Kerol-Dev/Tercio-B1/data/bom-estimate.csv

refs | description | lcsc | library | stock | qty | unit@10 | board@10 | unit@100 | board@100
U1 | MCU STM32G431CBT6 (LQFP-48) | C529355 | Extended | 5241 | 1 | 4.3763 | 4.376 | 4.049 | 4.049
U2 | Gate driver DRV8353RSRGZR (buck + 3 CSA + SPI) | C506246 | Extended | 1675 | 1 | 5.2347 | 5.235 | 4.6092 | 4.609
U3 | Encoder MT6835GT-STD-R (21-bit, SPI) | C2932578 | Extended | 1462 | 1 | 4.2884 | 4.288 | 3.5408 | 3.541
U4 | CAN-FD transceiver MCP2562FDT-E/SN | C511335 | Extended | 5333 | 1 | 1.4398 | 1.44 | 1.1238 | 1.124
U5 | LDO 3.3 V TLV75533PDBVR | C404027 | Extended | 132914 | 1 | 0.1424 | 0.142 | 0.1132 | 0.113
Q1-Q6 | MOSFET BSC030N08NS5 80 V 3 mOhm 5x6 | C501507 | Extended | 24529 | 6 | 0.7688 | 4.613 | 0.5685 | 3.411
R1-R3 | Shunt 1 mOhm 2512 3 W RLP25FEGR001 | C459678 | Extended | 27351 | 3 | 0.0888 | 0.266 | 0.0715 | 0.214
C1-C10 | Bulk MLCC 4.7 uF 100 V X7R 1210 | C381466 | Extended | 160984 | 10 | 0.1856 | 1.856 | 0.1856 | 1.856
C11 | Bulk electrolytic 47 uF 80 V 10x10 (height check) | C249920 | Extended | 7438 | 1 | 0.2238 | 0.224 | 0.1799 | 0.18
D1 | TVS SMBJ54A | C2891330 | Extended | 6025 | 1 | 0.0429 | 0.043 | 0.0429 | 0.043
Y1 | Crystal 16 MHz 3225 (Basic, same as S1/FD) | C13738 | Basic | 152708 | 1 | 0.093 | 0.093 | 0.074 | 0.074
RT1 | NTC 10k 0603 (FET temperature) | C13564 | Extended | 178011 | 1 | 0.0465 | 0.046 | 0.0391 | 0.039
D2 | CAN ESD PESD2CAN | C2687131 | Extended | 658668 | 1 | 0.0362 | 0.036 | 0.0362 | 0.036
D3,D4 | Aux ESD TPD4E05U06DQAR | C138714 | Extended | 102774 | 2 | 0.0839 | 0.168 | 0.0665 | 0.133
J1 | XT30PW-M power (right angle) | C431092 | Extended | 72882 | 1 | 0.3339 | 0.334 | 0.2623 | 0.262
J2,J3 | JST-GH 4-pin SM04B-GHS-TB (CAN in/out) | C189895 | Extended | 28981 | 2 | 0.304 | 0.608 | 0.2675 | 0.535
J4 | JST-GH 8-pin BM08B-GHS-TBT (aux) | C133062 | Extended | 1233 | 1 | 0.3737 | 0.374 | 0.3015 | 0.301
LED1,LED2 | LED 0603 (Basic) | C2286 | Basic | 7143368 | 2 | 0.0076 | 0.015 | 0.0076 | 0.015
- | Driver buck passives: inductor, 100 V Schottky, caps, FB divider |  | Basic (est) | est | 1 | 0.3 | 0.3 | 0.22 | 0.22
- | Driver support caps (100 V CP caps, VGLS/DVDD/VCP, VM HF bypass) |  | Basic (est) | est | 1 | 0.1 | 0.1 | 0.07 | 0.07
- | Logic passives: ~50x 0402 R/C, CAN split termination, dividers, filters |  | Basic (est) | est | 1 | 0.18 | 0.18 | 0.12 | 0.12
- | Leg HF decoupling 100 nF 100 V 0603 x6 |  | Basic (est) | est | 1 | 0.05 | 0.05 | 0.03 | 0.03
