Kerol-Dev/Tercio-B1/data/parts-live-2026-10-12-candidates-extra.csv

group | query | mpn | brand | lcsc | package | library | jlc_stock | jlc_p1 | jlc_p10 | jlc_p100 | lcsc_stock | lcsc_p10 | lcsc_p100 | describe | status
Connector | BM08B-GHS-TBT | BM08B-GHS-TBT-LF-SN | JLCPCB Assembly | C9900006063 | CONN-SMD_BM08B-GHS-TBT-LF-SN | Extended | 0 | 0.0007 | 0.0007 | 0.0007 |  |  |  | CONN-SMD_BM08B-GHS-TBT-LF-SN SMT ROHS | ok
Connector | BM08B-GHS-TBT | BM08B-GHS-TBT(LF)(SN) | JST | C133062 | SMD,P=1.25mm | Extended | 1233 | 0.3737 | 0.3737 | 0.3015 | 1235 | 0.3767 | 0.3039 | -25℃~+85℃ 1 1.25mm 13.25mm 1A 1x8P 4.05mm 4.32mm 50V 8 8P Auxiliary Solder Pin GH PA9T Phosphor bronze Surface Mount,Vertical Tin UL94V-0 White SMD,P=1.25mm Wir | ok
Connector | BM08B-GHS-TBT | BM08B-GHS-TBT(LF)(SN) | JST | C265379 | CONN-SMD-8P-P1.25 | Extended | 0 | 0.544 | 0.4056 | 0.3551 |  |  |  | 插件 Wire To Board Connector ROHS | ok
Connector | BM08B-GHS-TBT | BM08B-GHS-TBT(LF)(SN)(N) | JST | C2983884 | SMD,P=1.25mm | Extended | 0 | 0.0396 | 0.0396 | 0.0204 |  |  |  | -25℃~+85℃ 1 1.25mm 13.25mm 1A 1x8P 4.05mm 4.32mm 50V 8 8P Auxiliary Solder Pin GH PA9T Phosphor bronze Surface Mount,Vertical Tin UL94V-0 White SMD,P=1.25mm Wir | ok
Connector | SM07B-GHS-TB | SM07B-GHS-TB(LF)(SN) | JST | C495552 | SMD,P=1.25mm,Surface Mount，Right Angle | Extended | 6167 | 0.3766 | 0.3766 | 0.3172 | 4760 | 0.3798 | 0.3199 | -25℃~+85℃ 1 1.25mm 12mm 1A 1x7P 4.13mm 4.25mm 50V 7 7P Auxiliary Solder Pin GH PA9T Phosphor bronze Surface Mount, Right Angle Tin UL94V-0 White SMD,P=1.25mm,卧贴 | ok
Connector | BM06B-GHS-TBT | BM06B-GHS-TBT | JST | C20089153 | SMD,P=1.25mm | Extended | 0 | 0.1421 | 0.1421 | 0.139 | 0 | 0.1422 | 0.1391 | -25℃~+85℃ 1 1.25mm 10.75mm 1A 1x6P 4.05mm 4.32mm 50V 6 6P Auxiliary Solder Pin GH PA9T Phosphor bronze Surface Mount,Vertical Tin UL94V-0 White SMD,P=1.25mm Wir | ok
Connector | BM06B-GHS-TBT | BM06B-GHS-TBT(LF)(SN) | JST | C189892 | SMD,P=1.25mm | Extended | 1 | 0.3012 | 0.3012 | 0.2347 | 0 | 0.3034 | 0.2365 | -25℃~+85℃ 1 1.25mm 10.75mm 1A 1x6P 4.05mm 4.32mm 50V 6 6P Auxiliary Solder Pin GH PA9T Phosphor bronze Surface Mount,Vertical Tin UL94V-0 White SMD,P=1.25mm Wir | ok
Connector | BM06B-GHS-TBT | BM06B-GHS-TBT(LF)(SN) | JST | C495534 | SMD,P=1.25mm | Extended | 0 | 0.3168 | 0.3168 | 0.254 |  |  |  | -25℃~+85℃ 1 1.25mm 10.75mm 1A 1x6P 4.05mm 4.32mm 50V 6 6P Auxiliary Solder Pin GH PA9T Phosphor bronze Surface Mount,Vertical Tin UL94V-0 White SMD,P=1.25mm Wir | ok
Connector | BM06B-GHS-TBT | BM06B-GHS-TBT(LF)(SN)(N) | JST | C485353 | SMD,P=1.25mm | Extended | 0 | 0.1748 | 0.1748 | 0.171 | 0 | 0.1716 | 0.1679 | -25℃~+85℃ 1 1.25mm 10.75mm 1A 1x6P 4.05mm 4.32mm 50V 6 6P Auxiliary Solder Pin GH PA9T Phosphor bronze Surface Mount,Vertical Tin UL94V-0 White SMD,P=1.25mm Wir | ok
Connector | BM06B-GHS-TBT | BM06B-GHS-TBT(LF)(SN)(N) | JST | C2845126 | SMD,P=1.25mm | Extended | 0 | 0.1147 | 0.1147 | 0.1147 |  |  |  | -25℃~+85℃ 1 1.25mm 10.75mm 1A 1x6P 4.05mm 4.95mm 50V 6 6P Beige PA9T Phosphor bronze Surface Mount,Vertical Tin UL94V-0 SMD,P=1.25mm Wire To Board Connector ROH | ok
Connector | BM06B-GHS-TBT | BM06B-GHS-TBT(LF)(SN)(N) | JST | C2879703 | SMD,P=1.25mm | Extended | 0 | 0.1147 | 0.1147 | 0.1147 |  |  |  | -25℃~+85℃ 1 1.25mm 10.75mm 1A 1x6P 4.05mm 4.95mm 50V 6 6P Beige PA9T Phosphor bronze Surface Mount,Vertical Tin UL94V-0 SMD,P=1.25mm Wire To Board Connector ROH | ok
Connector | BM06B-GHS-TBT | BM06B-GHS-TBT(LF)(SN)(N) | JLCPCB Assembly | C9900141395 | SMD,P=1.25mm,6P | Extended | 0 | 0.0396 | 0.0396 | 0.0204 |  |  |  | SMD,P=1.25mm,6P New Arrivals ROHS | ok
Connector | 1.25mm 8P GH | SH-SM08B-GHS-TB(LF)(SN) | SHOU HAN | C42376901 | SMD,P=1.25mm,Surface Mount，Right Angle | Extended | 30603 | 0.0839 | 0.0839 | 0.0663 | 27170 | 0.0848 | 0.067 | -25℃~+85℃ 1 1.25mm 125V 1A 1x8P 8 8P Beige GH LCP Phosphor bronze Surface Mount, Right Angle Tin UL94V-0 SMD,P=1.25mm,Surface Mount，Right Angle Wire To Board Co | ok
Connector | 1.25mm 8P GH | A1251WR-S-8P-LCP | CJT(Changjiang Connectors) | C225117 | SMD,P=1.25mm,Surface Mount，Right Angle | Extended | 17177 | 0.1471 | 0.1471 | 0.1173 | 17175 | 0.1485 | 0.1184 | -40℃~+105℃ 1 1.25mm 125V 1A 1x8P 8 8P LCP Phosphor Bronze Surface Mount, Right Angle Tin UL94V-0 SMD,P=1.25mm,卧贴 Wire To Board Connector ROHS | ok
Connector | 1.25mm 8P GH | A1251WV-S-8P | CJT(Changjiang Connectors) | C225110 | SMD,P=1.25mm | Extended | 11154 | 0.1662 | 0.1662 | 0.1295 | 11150 | 0.1676 | 0.1306 | -40℃~+105℃ 1 1.25mm 125V 1A 1x8P 8 8P LCP Phosphor Bronze Surface Mount,Vertical Tin UL94V-0 SMD,P=1.25mm Wire To Board Connector ROHS | ok
Connector | 1.25mm 8P GH | A1257WV-S-8P | CJT(Changjiang Connectors) | C225124 | SMD,P=1.25mm | Extended | 10616 | 0.1846 | 0.1846 | 0.1424 | 10020 | 0.1856 | 0.1433 | -40℃~+105℃ 1 1.25mm 1A 1x8P 50V 8 8P GH PA9T Phosphor Bronze Surface Mount,Vertical Tin UL94V-0 SMD,P=1.25mm Wire To Board Connector ROHS | ok
Dev board | B-G431B-ESC1 | B-G431B-ESC1 |  |  |  |  |  |  |  |  |  |  |  |  | not found on JLCPCB/LCSC
Bulk elec | 47uF 80V SMD | HBV470M1KTR-1010 | Lelon | C3031594 | SMD,D10xL10mm | Extended | 9901 | 0.8111 | 0.6629 | 0.5147 | 9901 | 0.6689 | 0.5193 | -55℃~+105℃ 10000hrs@105℃ 10mm 10mm 47uF 80V Polarized SMD ±20% SMD,D10xL10mm Hybrid Aluminum Electrolytic Capacitors ROHS | ok
Bulk elec | 47uF 80V SMD | HV1K476M1010PZ | Honor Elec | C5246571 | SMD,D10xL10mm | Extended | 9385 | 0.3686 | 0.3686 | 0.2991 | 9105 | 0.3724 | 0.3022 | -55℃~+105℃ 10mm 10mm 2000hrs 4.5mm 47uF 80V Polarized ±20% SMD,D10xL10mm Polymer Aluminum Capacitors ROHS | ok
Bulk elec | 47uF 80V SMD | VZH470M1KTR-1010 | Lelon | C249920 | SMD,D10xL10mm | Extended | 7438 | 0.2238 | 0.2238 | 0.1799 | 7095 | 0.2252 | 0.181 | -45℃~+105℃ 10mm 10mm 47uF 5000hrs@105℃ 80V ±20% SMD,D10xL10mm Aluminum Electrolytic Capacitors - SMD ROHS | ok
Bulk elec | 100uF 80V SMD | JVJ80V100M10x10 | jieerrui | C46550424 | SMD,D10xL10.5mm | Extended | 35809 | 0.1662 | 0.1662 | 0.1305 | 34170 | 0.1677 | 0.1317 | -55℃~+105℃ 10.5mm 100uF 10mm 135mA@120Hz 2000hrs@105℃ 80V ±20% SMD,D10xL10.5mm Aluminum Electrolytic Capacitors - SMD ROHS | ok
Bulk elec | 100uF 80V SMD | RVT100UF80V167RV0112 | KNSCHA | C5246576 | SMD,D10xL10.5mm | Extended | 12198 | 0.1602 | 0.1602 | 0.1303 | 12195 | 0.1611 | 0.1312 | -55℃~+105℃ 10.5mm 100uF 10mm 2000hrs@105℃ 280mA@120Hz 80V ±20% SMD,D10xL10.5mm Aluminum Electrolytic Capacitors - SMD ROHS | ok
Bulk elec | 100uF 80V SMD | MA80V100M10X12 | jieerrui | C53120969 | SMD,D10xL12.5mm | Extended | 6506 | 0.4773 | 0.3746 | 0.2769 | 6506 | 0.3782 | 0.2795 | -55℃~+105℃ 100uF 10mm 12.5mm 2.9A@100kHz 2000hrs@105℃ 35mΩ@100kHz 5mm 80V Polarized Polymer ±20% SMD,D10xL12.5mm Polymer Aluminum Capacitors ROHS | ok
Bulk elec | 33uF 100V SMD | RVT2A330M1010 | Honor Elec | C45162 | SMD | Extended | 11265 | 0.136 | 0.136 | 0.1101 | 10795 | 0.1373 | 0.1112 | -55℃~+105℃ 10.2mm 100V 10mm 2000hrs@105℃ 33uF ±20% SMD Aluminum Electrolytic Capacitors - SMD ROHS | ok
Bulk elec | 33uF 100V SMD | JVJ100V33M10X10 | jieerrui | C49256861 | SMD,D10xL10.5mm | Extended | 5760 | 0.1888 | 0.1888 | 0.1499 | 5760 | 0.1899 | 0.1507 | -55℃~+105℃ 10.5mm 100V 10mm 133mA@120Hz 2000hrs@105℃ 33uF ±20% SMD,D10xL10.5mm Aluminum Electrolytic Capacitors - SMD ROHS | ok
Bulk elec | 33uF 100V SMD | FZ2A330M1010 | JARSON | C5260775 | SMD,D10xL10.5mm | Extended | 819 | 0.1237 | 0.1237 | 0.0981 | 790 | 0.1248 | 0.0991 | -55℃~+105℃ 10.5mm 100V 10mm 200mA 33uF 5000hrs@105℃ 700mΩ ±20% SMD,D10xL10.5mm Aluminum Electrolytic Capacitors - SMD ROHS | ok
ESD | TPD4E05U06DQAR | TPD4E05U06DQAR | Texas Instruments | C138714 | USON-10(1x2.5) | Extended | 102774 | 0.0839 | 0.0839 | 0.0665 | 102770 | 0.0848 | 0.0671 | -40℃~+125℃ 0.5pF 10nA 14V 2.5A@8/20us 40W@8/20us 5.5V 6.5V ESD Four channels IEC 61000-4-2、IEC 61000-4-5、IEC 61000-4-4 Unidirectional USON-10(1x2.5) ESD and Sur | ok
ESD | TPD4E05U06DQAR | TPD4E05U06DQAR-N | BORN | C920310 | DFN-10(2.5x1.0) | Extended | 23300 | 0.0706 | 0.0706 | 0.0564 | 23300 | 0.0713 | 0.057 | 0.25pF、0.3pF 10V 3.5A@8/20us 500nA 5V 60W@8/20us 7.8V IEC 61000-4-2、IEC 61000-4-5、IEC 61000-4-4 Unidirectional DFN-10(2.5x1.0) ESD and Surge Protection (TVS/ESD | ok
ESD | TPD4E05U06DQAR | TPD4E05U06DQAR | TECH PUBLIC | C2827646 | USON-10(1x2.5) | Extended | 35262 | 0.0717 | 0.0717 | 0.0569 | 35260 | 0.0725 | 0.0575 | -55℃~+125℃ 0.3pF、0.6pF 13V 5.5V 50nA 5A 7.5V 70W@8/20us ESD Four channels IEC 61000-4-2、IEC 61000-4-5、IEC 61000-4-4 Unidirectional USON-10(1x2.5) ESD and Surge | ok
ESD | TPD4E05U06DQAR | TPD4E05U06DQAR-MS | MSKSEMI | C2836386 | DFN2510-10 | Extended | 7749 | 0.072 | 0.072 | 0.0579 | 7740 | 0.0727 | 0.0584 | 0.3pF、0.8pF 150W 15V 1uA 3.3V 5A 6V ESD Four channels IEC 61000-4-2、IEC 61000-4-5、IEC 61000-4-4 DFN2510-10 ESD and Surge Protection (TVS/ESD) ROHS | ok
ESD | TPD4E05U06DQAR | TPD4E05U06DQAR | Leiditech | C2972498 | DFN2510-10 | Extended | 5653 | 0.0838 | 0.0838 | 0.0681 | 5650 | 0.0846 | 0.0688 | 0.3pF、0.8pF 100nA 5A@8/20us 5V 6V 75W@8/20us 9.8V、15V ESD Four channels IEC 61000-4-2、IEC 61000-4-5 DFN2510-10 ESD and Surge Protection (TVS/ESD) ROHS | ok
ESD | TPD4E05U06DQAR | TPD4E05U06DQAR-ES | ElecSuper | C5199181 | DFN2510-10L | Extended | 1951 | 0.0279 | 0.0279 | 0.0229 | 1950 | 0.0282 | 0.023 | -40℃~+125℃ 0.6pF 12V 1uA 4.5A 5V 60W 6V ESD Four channels IEC 61000-4-2、IEC 61000-4-5、IEC 61000-4-4 Unidirectional DFN2510-10L ESD and Surge Protection (TVS/ESD | ok
ESD | TPD4E05U06DQAR | TPD4E05U06DQAR | HXY MOSFET | C5337182 | DFN2510-10L | Extended | 286 | 0.0807 | 0.0807 | 0.0642 | 285 | 0.0814 | 0.0648 | -40℃~+125℃ 0.8pF 150W 15V 1uA 3.3V 5A 6V ESD Four channels IEC 61000-4-2 Unidirectional DFN2510-10L ESD and Surge Protection (TVS/ESD) ROHS | ok
ESD | TPD4E05U06DQAR | TPD4E05U06DQAR | GOODWORK | C21713973 | USON-10(1x2.5) | Extended | 1193 | 0.0393 | 0.0393 | 0.0393 | 1180 | 0.0397 | 0.0397 | -55℃~+125℃ 0.6pF 15V 1uA 4.5A@8/20us 5V 60W@8/20us 6V ESD Four channels IEC 61000-4-2 Unidirectional USON-10(1x2.5) ESD and Surge Protection (TVS/ESD) ROHS | ok
ESD | TPD4E05U06DQAR | TPD4E05U06DQAR | DOWO | C22390021 | DFN2510-10L | Extended | 97226 | 0.0287 | 0.0287 | 0.0287 | 96460 | 0.0289 | 0.0289 | 0.2pF 15V 1uA 5V 60W@8/20us 9V Four channels IEC 61000-4-2、IEC 61000-4-5 TVS Unidirectional DFN2510-10L ESD and Surge Protection (TVS/ESD) ROHS | ok
ESD | TPD4E05U06DQAR | TPD4E05U06DQAR | YTL | C53433026 | DFN2510-10L | Extended | 2941 | 0.044 | 0.044 | 0.0346 | 2940 | 0.0441 | 0.0347 | DFN2510-10L ESD and Surge Protection (TVS/ESD) ROHS | ok
ESD | TPD4E05U06DQAR | TPD4E05U06DQAR | Texas Instruments | C125795 | USON-10 | Extended | 0 | 0.6124 | 0.5978 | 0.5782 |  |  |  | USON-10 ESD Protection Devices ROHS | ok
ESD | TPD4E05U06DQAR | TPD4E05U06DQAR | JLCPCB Assembly | C9900010487 | USON-10 | Extended | 0 | 0.0007 | 0.0007 | 0.0007 |  |  |  | USON-10 SMT ROHS | ok
ESD | TPD4E05U06DQAR | TPD4E05U06DQAR | JLCPCB Assembly | C9900145545 | DSON-10_L2.5-W1.0-P0.50-BL | Extended | 0 | 0.0396 | 0.0396 | 0.0204 |  |  |  | DSON-10_L2.5-W1.0-P0.50-BL New Arrivals ROHS | ok
ESD | TPD4E05U06DQAR | TPD4E05U06DQAR-L | TECH PUBLIC | C19829470 | DFN2510-10 | Extended | 2525 | 0.0481 | 0.0481 | 0.0378 | 2520 | 0.0446 | 0.035 | -55℃~+125℃ 0.3pF、0.8pF 100nA 16V 4A@8/20us 5V 80W@8/20us 8V Four channels IEC 61000-4-2、IEC 61000-4-5、IEC 61000-4-4 TVS Unidirectional DFN2510-10 ESD and Surge | ok
ESD | SRV05-4 | SRV05-4.TCT | SEMTECH | C13612 | SOT-23-6L | Extended | 43056 | 0.1624 | 0.1624 | 0.1294 | 43055 | 0.164 | 0.1305 | -55℃~+125℃ 12A@8/20us 17.5V 300W@8/20us 3pF 5V 5uA 6V Four channels IEC 61000-4-2、IEC 61000-4-5、IEC 61000-4-4 TVS Unidirectional SOT-23-6L ESD and Surge Protect | ok
ESD | SRV05-4 | SRV05-4-P-T7 | ProTek Devices | C85364 | SOT-23-6 | Extended (preferred) | 2 | 0.308 | 0.308 | 0.2522 | 0 | 0.3076 | 0.2519 | 12V 1A@8/20us 3.5pF 500W@8/20us 5V 5uA 6V ESD Four channels IEC 61000-4-2、IEC 61000-4-5、IEC 61000-4-4 SOT-23-6 ESD and Surge Protection (TVS/ESD) ROHS | ok
ESD | SRV05-4 | SRV05-4L-TP | MCC(Micro Commercial Components) | C107351 | SOT-23-6L | Extended | 1339 | 0.1684 | 0.1684 | 0.1333 | 1335 | 0.2247 | 0.1959 | -55℃~+150℃ 1.5pF 12A@8/20us 17.5V 1uA 350W@8/20us 5V 9V ESD Four channels IEC 61000-4-2、IEC 61000-4-4 SOT-23-6L ESD and Surge Protection (TVS/ESD) ROHS | ok
ESD | SRV05-4 | SRV05-4HTG | Littelfuse | C151305 | SOT-23-6 | Extended | 29731 | 0.9431 | 0.8274 | 0.6808 | 29731 | 0.8326 | 0.6851 | 10A@8/20us 150W 15V 3pF 500nA 6V IEC 61000-4-2、IEC 61000-4-5、IEC 61000-4-4 TVS SOT-23-6 ESD and Surge Protection (TVS/ESD) ROHS | ok
ESD | SRV05-4 | SRV05-4A | SMC(Sangdest Microelectronicstronic (Nanjing)) | C260410 | SOT-23-6L | Extended | 2786 | 0.14 | 0.14 | 0.1101 | 2785 | 0.1411 | 0.1111 | -55℃~+125℃ 1.5pF、3.2pF 17.5V 2.3uA 20A@8/20us 5V 6V Four channels IEC 61000-4-2、IEC 61000-4-5、IEC 61000-4-4 TVS Unidirectional SOT-23-6L ESD and Surge Protectio | ok
ESD | SRV05-4 | SRV05-4ATCT | SEMTECH | C371093 | SOT-23-6 | Extended | 3757 | 0.2284 | 0.2284 | 0.1797 | 3755 | 0.2305 | 0.1814 | -55℃~+125℃ 12A@8/20us 17.5V 300W 3pF 5V 5uA 6V ESD Four channels IEC 61000-4-2、IEC 61000-4-5、IEC 61000-4-4 SOT-23-6 ESD and Surge Protection (TVS/ESD) ROHS | ok
ESD | SRV05-4 | SRV05-4 | Leiditech | C384887 | SOT-26 | Extended | 7099 | 0.065 | 0.065 | 0.0509 | 7090 | 0.0655 | 0.0513 | 0.5pF 12A 15V 1uA 350W@8/20us 5V 6V Four channels IEC 61000-4-2、IEC 61000-4-5、IEC 61000-4-4 TVS SOT-26 ESD and Surge Protection (TVS/ESD) ROHS | ok
ESD | SRV05-4 | SRV05-4 | AnBon | C397788 | SOT-23-6 | Extended | 270 | 0.0514 | 0.0514 | 0.0414 | 0 | 0.0518 | 0.0418 | -55℃~+125℃ 0.35pF、0.9pF 100W@8/20us 15V 4A 5V 5uA 6V ESD Four channels IEC 61000-4-2、IEC 61000-4-5 SOT-23-6 ESD and Surge Protection (TVS/ESD) ROHS | ok
ESD | SRV05-4 | SRV05-4 | TECH PUBLIC | C558418 | SOT-23-6 | Extended | 195535 | 0.0266 | 0.0266 | 0.0266 | 195600 | 0.0268 | 0.0268 | -55℃~+125℃ 0.3pF、0.8pF 20V 3A 500nA 5V 60W 6V ESD Four channels IEC 61000-4-2、IEC 61000-4-5、IEC 61000-4-4 Unidirectional SOT-23-6 ESD and Surge Protection (TVS/ | ok
ESD | SRV05-4 | SRV05-4MR6T1G | onsemi | C604719 | TSOP-6 | Extended | 78 | 4.4154 | 3.9496 | 3.36 | 78 | 3.9742 | 3.3809 | -55℃~+125℃ 1.5pF、3pF 17.5V 300W 5V 5uA 6V ESD Four channels IEC 61000-4-2、IEC 61000-4-5、IEC 61000-4-4 TSOP-6 ESD and Surge Protection (TVS/ESD) ROHS | ok
ESD | SRV05-4 | SRV05-4 | Applied Power | C712153 | SOT-23-6 | Extended | 1 | 0.0989 | 0.0989 | 0.0786 | 0 | 0.0995 | 0.079 | 1.5pF、3pF 12A@8/20us 25V 300W@8/20us 500nA 5V 6V IEC 61000-4-2、IEC 61000-4-5 TVS SOT-23-6 ESD and Surge Protection (TVS/ESD) ROHS | ok
ESD | SRV05-4 | SRV05-4LA 4A | DOWO | C1884586 | SOT-23-6L | Extended | 4148 | 0.0354 | 0.0354 | 0.0354 | 4140 | 0.0356 | 0.0356 | -40℃~+85℃ 0.8pF 15V 1uA 4A@8/20us 5V 60W@8/20us 9.5V Four channels IEC 61000-4-2 TVS Unidirectional SOT-23-6L ESD and Surge Protection (TVS/ESD) ROHS | ok
ESD | SRV05-4 | SRV05-4HTG-D | Littelfuse | C1975211 | SOT-23-6 | Extended | 25620 | 0.1784 | 0.1784 | 0.1417 | 25620 | 0.18 | 0.143 | 10A@8/20us 150W@8/20us 15V 1pF 500nA 6V 8.5V ESD Four channels IEC 61000-4-2、IEC 61000-4-5、IEC 61000-4-4 SOT-23-6 ESD and Surge Protection (TVS/ESD) ROHS | ok
ESD | SRV05-4 | SRV05-4.TCT | UMW(Youtai Semiconductor Co., Ltd.) | C2687126 | SOT-23-6 | Extended | 63022 | 0.0373 | 0.0373 | 0.0373 | 63020 | 0.0373 | 0.0373 | 0.3pF 20V 500nA 5V 6V ESD Four channels IEC 61000-4-2、IEC 61000-4-5、IEC 61000-4-4 SOT-23-6 ESD and Surge Protection (TVS/ESD) ROHS | ok
ESD | SRV05-4 | SRV05-4ATCT | TECH PUBLIC | C2827642 | SOT-23-6 | Extended | 4168 | 0.0417 | 0.0417 | 0.0331 | 4160 | 0.0421 | 0.0334 | -55℃~+125℃ 0.4pF、0.8pF 18V 300W@8/20us 5.5A@8/20us 5V 6V 80nA Four channels IEC 61000-4-2、IEC 61000-4-5、IEC 61000-4-4 SOT-23-6 ESD and Surge Protection (TVS/ESD | ok
ESD | SRV05-4 | SRV05-4 | MSKSEMI | C2836319 | SOT-23-6 | Extended | 401980 | 0.0289 | 0.0289 | 0.0289 | 393440 | 0.0292 | 0.0292 | -40℃~+125℃ 0.6pF 12V 1uA 4.5A@8/20us 5V 60W@8/20us 9V ESD Four channels SOT-23-6 ESD and Surge Protection (TVS/ESD) ROHS | ok
ESD | SRV05-4 | SRV05-4MR6T1G | TECH PUBLIC | C2901302 | SOT-23-6 | Extended | 3161 | 0.079 | 0.079 | 0.0644 | 3160 | 0.0799 | 0.0651 | -55℃~+125℃ 0.3pF、0.8pF 18V 300W@8/20us 4.7A@8/20us 5V 6V 80nA ESD IEC 61000-4-2、IEC 61000-4-5、IEC 61000-4-4 SOT-23-6 ESD and Surge Protection (TVS/ESD) ROHS | ok
ESD | SRV05-4 | SRV05-4.TCT | TECH PUBLIC | C2905630 | SOT-23-6 | Extended | 8975 | 0.0455 | 0.0455 | 0.0365 | 8860 | 0.046 | 0.0369 | -55℃~+125℃ 0.3pF、0.8pF 18V 300W@8/20us 4.7A@8/20us 5V 6V 80nA ESD IEC 61000-4-2、IEC 61000-4-5、IEC 61000-4-4 SOT-23-6 ESD and Surge Protection (TVS/ESD) ROHS | ok
ESD | SRV05-4 | SRV05-4 | DOWO | C2972082 | SOT-23-6L | Extended | 6424 | 0.0362 | 0.0362 | 0.0362 | 6420 | 0.0366 | 0.0366 | 0.3pF、0.6pF 12V 1uA 4.5A@8/20us 5V 60W@8/20us ESD Four channels IEC 61000-4-2 Unidirectional SOT-23-6L ESD and Surge Protection (TVS/ESD) ROHS | ok
ESD | SRV05-4 | SRV05-4 | Shenzhen Jinkaisheng Elec | C2972750 | SOT-23-6L | Extended | 2910 | 0.0509 | 0.0509 | 0.0408 | 2910 | 0.0478 | 0.0382 | 0.4pF、0.8pF 150W@8/20us 15V、28V 1uA 5A@8/20us 5V 6V ESD Four channels IEC 61000-4-2 SOT-23-6L ESD and Surge Protection (TVS/ESD) ROHS | ok
LED | 0603 red LED | KT-0603R | Hubei KENTO Elec | C2286 | 0603 | Basic | 7143368 | 0.0076 | 0.0076 | 0.0076 | 4686900 | 0.0077 | 0.0077 | -40℃~+85℃ 1.6mm x 0.8mm square LED 1.8V~2.4V 120° 20mA 300mcd 40mW 615nm~630nm 645nm Discrete Diode Red Water Clear 0603 LED Indication - Discrete ROHS | ok
LED | 0603 red LED | NCD0805R1 | Foshan NationStar Optoelectronics | C84256 | 0805 | Basic | 4196154 | 0.0134 | 0.0134 | 0.0134 | 3009300 | 0.0135 | 0.0135 | -30℃~+85℃ 1.6V~2.6V 130° 195mcd 25mA 615nm~630nm 630nm 65mW Discrete Diode Red 0805 LED Indication - Discrete ROHS | ok
MOSFET | BSC070N10NS5 | BSC070N10NS5 | Infineon Technologies | C534364 | TDSON-8(5x6) | Extended | 25994 | 0.588 | 0.4984 | 0.3258 | 22631 | 0.5032 | 0.3289 | -55℃~+150℃ 1 N-channel 100V 2.7nF 28pF 3.8V 38nC@10V 7mΩ@10V 80A 83W TDSON-8(5x6) MOSFETs ROHS | ok
MOSFET | BSC070N10NS5 | BSC070N10NS5-HXY | HXY MOSFET | C22366974 | DFN-8(5x6) | Extended | 133 | 0.6206 | 0.5082 | 0.3975 | 133 | 0.5114 | 0.3999 | -55℃~+150℃ 1 N-channel 1.6V 100V 2.046nF 25pF 39.4nC@10V 7.3mΩ@10V 75A 865pF 97W N-Channel Standalone ±20V DFN-8(5x6) MOSFETs ROHS | ok
MOSFET | BSC070N10NS5 | BSC070N10NS5SC | Infineon Technologies | C534365 | SON-8-EP(5x6) | Extended | 0 | 3.5571 | 3.5571 | 3.5571 |  |  |  | SON-8-EP(5x6) MOSFETs ROHS | ok
MOSFET | BSC070N10NS5 | BSC070N10NS5SC | Infineon Technologies | C3279351 | WSON-8-EP(5x6) | Extended | 0 | 2.1206 | 2.075 | 2.0131 | 0 | 2.0727 | 2.0109 | -55℃~+175℃ 1 N-channel 100V 100W 2.7nF 28pF 3.8V 30nC@10V 440pF 7mΩ@10V 82A N-Channel WSON-8-EP(5x6) MOSFETs ROHS | ok
MOSFET | BSC070N10NS5 | BSC070N10NS5 | JLCPCB Assembly | C9900102270 | TDSON-8 | Extended | 0 | 0.0396 | 0.0396 | 0.0204 |  |  |  | TDSON-8 New Arrivals ROHS | ok
MOSFET | BSC070N10NS5 | BSC070N10NS5-MS | MSKSEMI | C51927954 | DFN-8L(5x6) | Extended | 199 | 0.9186 | 0.772 | 0.6238 | 199 | 0.77 | 0.6222 | -55℃~+150℃ 1 N-channel 1.6V 100V 2.046nF 25pF 39.4nC 7.3mΩ@10V 75A 865pF 97W N-Channel ±20V DFN-8L(5x6) MOSFETs ROHS | ok
MOSFET | BSC070N10NS5 | BSC070N10NS5(ES) | ElecSuper | C49108749 | PDFN-8L(5x6) | Extended | 2 | 0.4603 | 0.4603 | 0.3807 | 0 | 0.4647 | 0.3842 | 1 N-channel 1.357nF 1.8nF 100V 125W 29nC@10V 3V 53pF 6.5mΩ@10V 92A N-Channel PDFN-8L(5x6) MOSFETs ROHS | ok
MOSFET | BSC070N10NS5 | BSC070N10NS5ATMA1 | Infineon Technologies | C151549 | PG-TDSON-8 | Extended | 0 | 2.6939 | 2.347 | 1.9072 |  |  |  | 100V 3.8V@50uA 7mΩ@10V,40A 80A 83W N-Channel PG-TDSON-8(6x5) MOSFETs ROHS | ok
MOSFET | BSC070N10NS5 | BSC070N10NS5ATMA1 | JLCPCB Assembly | C9900302558 | PG-TDSON-8 | Extended | 0 | 0.0396 | 0.0396 | 0.0204 |  |  |  | PG-TDSON-8 SMT ROHS | ok
MOSFET | BSC070N10NS5 | BSC070N10NS5SCATMA1 | Infineon Technologies | C55035936 | WSON-8-EP(5x6) | Extended | 0 | 7.6386 | 7.6386 | 7.6386 |  |  |  | WSON-8-EP(5x6) SMT ROHS | ok
MOSFET | BSC093N10NS5 | BSC093N10NS5 |  |  |  |  |  |  |  |  |  |  |  |  | not found on JLCPCB/LCSC
