Kerol-Dev/Tercio-B1/data/parts-live-2026-10-12.csv

group | query | mpn | brand | lcsc | package | library | jlc_stock | jlc_p1 | jlc_p10 | jlc_p100 | lcsc_stock | lcsc_p10 | lcsc_p100 | describe | status
MCU | STM32G431CBT6 | STM32G431CBT6 | STMicroelectronics | C529355 | LQFP-48(7x7) | Extended | 5241 | 5.0213 | 4.3763 | 4.049 | 4197 | 4.4179 | 4.0875 | -40℃~+85℃ 1.71V~3.6V 128KB 12bit 12bit 170MHz 32 Bit 32KB 38 ARM Cortex-M4F Built-in FLASH LQFP-48(7x7) Microcontrollers (MCU/MPU/SOC) ROHS | ok
MCU | STM32G431CBT6 | STM32G431CBT6 | JLCPCB Assembly | C9900183364 | SMD-51P-P0.5 | Extended | 0 | 0.0396 | 0.0396 | 0.0204 |  |  |  | SMD-51P-P0.5 SMT ROHS | ok
MCU | STM32G431CBT6 | STM32G431CBT6TR | STMicroelectronics | C37706925 | LQFP-48(7x7) | Extended | 0 | 10.4139 | 8.9855 | 7.3862 | 0 | 9.0501 | 7.4392 | LQFP-48(7x7) Microcontrollers (MCU/MPU/SOC) ROHS | ok
MCU | STM32G431CBT6 | STM32G431CBT6GQ204 | JLCPCB Assembly | C9900269867 | LQFP-48(7x7) | Extended | 0 | 0.0396 | 0.0396 | 0.0204 |  |  |  | LQFP-48(7x7) SMT ROHS | ok
MCU | STM32G431CBU6 | STM32G431CBU6 | STMicroelectronics | C529356 | UFQFPN-48(7x7) | Extended | 3561 | 7.9252 | 7.0116 | 5.8617 | 2575 | 7.075 | 5.9148 | -40℃~+85℃ 1.71V~3.6V 128KB 12bit 12bit 170MHz 32 Bit 32KB 42 ARM Cortex-M4F Built-in FLASH UFQFPN-48(7x7) Microcontrollers (MCU/MPU/SOC) ROHS | ok
MCU | STM32G431CBU6 | STM32G431CBU6U | STMicroelectronics | C1341712 | UFQFPN-48(7x7) | Extended | 0 | 4.2086 | 4.2086 | 4.2086 | 0 | 3.9884 | 3.9884 | -40℃~+85℃ 1.71V~3.6V 128KB 12bit 12bit 170MHz 32 Bit 32KB 42 ARM Cortex-M4F Built-in FLASH UFQFPN-48(7x7) Microcontrollers (MCU/MPU/SOC) ROHS | ok
MCU | STM32G431RBT6 | STM32G431RBT6 | STMicroelectronics | C431633 | LQFP-64(10x10) | Extended | 3117 | 5.7477 | 5.1272 | 4.2982 | 2980 | 5.1736 | 4.3371 | -40℃~+85℃ 1.71V~3.6V 128KB 12bit 12bit 170MHz 32 Bit 32KB 52 ARM Cortex-M4F Built-in FLASH LQFP-64(10x10) Microcontrollers (MCU/MPU/SOC) ROHS | ok
MCU | STM32G431RBT6 | STM32G431RBT6U | STMicroelectronics | C1341937 | LQFP-64(10x10) | Extended | 0 | 5.5848 | 5.5848 | 5.5848 | 0 | 5.2926 | 5.2926 | -40℃~+85℃ 1.71V~3.6V 128KB 12bit 12bit 170MHz 32 Bit 32KB 52 ARM Cortex-M4F Built-in FLASH LQFP-64(10x10) Microcontrollers (MCU/MPU/SOC) ROHS | ok
MCU | STM32G431RBT6 | STM32G431RBT6TR | STMicroelectronics | C3019121 | LQFP-64(10x10) | Extended | 0 | 19.6844 | 18.743 | 15.6892 | 0 | 17.7505 | 14.8584 | -40℃~+85℃ 1.71V~3.6V 128KB 12bit 12bit 170MHz 32 Bit 32KB 52 ARM Cortex-M4 Built-in FLASH LQFP-64(10x10) Microcontrollers (MCU/MPU/SOC) ROHS | ok
MCU | STM32G474CET6 | STM32G474CET6 | STMicroelectronics | C730125 | LQFP-48(7x7) | Extended | 0 | 21.4694 | 20.4662 | 15.8847 | 0 | 20.653 | 16.0297 | -40℃~+85℃ 1.71V~3.6V 128KB 12bit 12bit 170MHz 32 Bit 38 512KB ARM Cortex-M4F Built-in FLASH LQFP-48(7x7) Microcontrollers (MCU/MPU/SOC) ROHS | ok
MCU | STM32G474CEU6 | STM32G474CEU6 | STMicroelectronics | C1235412 | UFQFPN-48(7x7) | Extended | 6 | 13.7462 | 13.0784 | 10.9123 | 0 | 13.1866 | 11.0025 | -40℃~+85℃ 1.71V~3.6V 128KB 12bit 12bit 170MHz 32 Bit 38 512KB ARM Cortex-M4F Built-in FLASH UFQFPN-48(7x7) Microcontrollers (MCU/MPU/SOC) ROHS | ok
MCU | STM32G474CBT6 | STM32G474CBT6 | STMicroelectronics | C730123 | LQFP-48_7x7 | Extended | 481 | 4.2933 | 3.777 | 3.5131 | 164 | 3.8129 | 3.5465 | -40℃~+85℃ 1.71V~3.6V 128KB 128KB 12bit 12bit 170MHz 32 Bit 38 ARM Cortex-M4F Built-in FLASH LQFP-48(7x7) Microcontrollers (MCU/MPU/SOC) ROHS | ok
MCU | STM32G474CBT6 | STM32G474CBT6 | JLCPCB Assembly | C9900115372 | UFQFPN-48_L7.0-W7.0-P0.50-BL-E | Extended | 0 | 0.0396 | 0.0396 | 0.0204 |  |  |  | UFQFPN-48_L7.0-W7.0-P0.50-BL-E New Arrivals ROHS | ok
MCU | STM32G474CBT6 | STM32G474CBT6TR | STMicroelectronics | C5270356 | LQFP-48(7x7) | Extended | 0 | 3.5995 | 3.1288 | 2.5652 | 0 | 3.1482 | 2.5812 | 1.71V~3.6V 12bit 12bit 170MHz 38 ARM Cortex-M4 LQFP-48(7x7) Microcontrollers (MCU/MPU/SOC) ROHS | ok
MCU | STM32G474RET6 | STM32G474RET6 | STMicroelectronics | C521608 | LQFP-64(10x10) | Extended | 353 | 13.5621 | 11.9302 | 10.1631 | 139 | 12.0168 | 10.2369 | -40℃~+85℃ 1.71V~3.6V 128KB 12bit 12bit 170MHz 32 Bit 512KB 52 ARM Cortex-M4F Built-in FLASH LQFP-64(10x10) Microcontrollers (MCU/MPU/SOC) ROHS | ok
MCU | STM32G474RET6 | STM32G474RET6TR | STMicroelectronics | C55072751 | LQFP-64 | Extended | 0 | 0.0396 | 0.0396 | 0.0204 |  |  |  | LQFP-64 SMT ROHS | ok
MCU | STM32G473CET6 | STM32G473CET6 | STMicroelectronics | C730113 | LQFP-48(7x7) | Extended | 0 | 13.7755 | 13.1501 | 11.1207 | 0 | 13.2584 | 11.2124 | -40℃~+85℃ 1.71V~3.6V 128KB 12bit 12bit 170MHz 32 Bit 38 512KB ARM Cortex-M4 Built-in FLASH LQFP-48(7x7) Microcontrollers (MCU/MPU/SOC) ROHS | ok
MCU | STM32G491CET6 | STM32G491CET6 | STMicroelectronics | C3227300 | LQFP-48(7x7) | Extended | 3 | 9.023 | 8.3992 | 8.1305 | 0 | 8.4683 | 8.1973 | -40℃~+85℃ 1.71V~3.6V 112KB 12bit 12bit 170MHz 32 Bit 38 512KB ARM Cortex-M4F Built-in FLASH LQFP-48(7x7) Microcontrollers (MCU/MPU/SOC) ROHS | ok
MCU | STM32G491CEU6 | STM32G491CEU6 | STMicroelectronics | C3227342 | UFQFPN-48(7x7) | Extended | 2 | 8.6663 | 8.4627 | 8.1924 | 0 | 8.4567 | 8.1865 | -40℃~+85℃ 1.71V~3.6V 12bit 12bit 170MHz 32 Bit 42 512KB ARM Cortex-M4F Built-in FLASH UFQFPN-48(7x7) Microcontrollers (MCU/MPU/SOC) ROHS | ok
MCU | STM32G491CEU6 | STM32G491CEU6TR | STMicroelectronics | C5909866 | UFQFPN-48(7x7) | Extended | 0 | 13.6045 | 13.6045 | 13.6045 | 0 | 13.2584 | 13.2584 | -40℃~+85℃ 1.71V~3.6V 12bit 12bit 170MHz 32 Bit 42 512KB ARM Cortex-M4 Built-in FLASH UFQFPN-48(7x7) Microcontrollers (MCU/MPU/SOC) ROHS | ok
MCU | STM32G491RET6 | STM32G491RET6 | STMicroelectronics | C3231005 | LQFP-64(10x10) | Extended | 0 | 6.8031 | 5.9497 | 4.9936 | 0 | 5.9999 | 5.0358 | -40℃~+85℃ 1.71V~3.6V 112KB 12bit 12bit 170MHz 32 Bit 512KB 52 ARM Cortex-M4F Built-in FLASH LQFP-64(10x10) Microcontrollers (MCU/MPU/SOC) ROHS | ok
MCU | STM32G491RET6 | STM32G491RET6TR | STMicroelectronics | C5270292 | LQFP-64(10x10) | Extended | 0 | 8.5507 | 8.5507 | 8.5507 | 0 | 8.0675 | 8.0675 | -40℃~+85℃ 1.71V~3.6V 12bit 12bit 170MHz 32 Bit 512KB 52 ARM Cortex-M4 Built-in FLASH LQFP-64(10x10) Microcontrollers (MCU/MPU/SOC) ROHS | ok
Gate driver | DRV8323RSRGZR | DRV8323RSRGZR | Texas Instruments | C545497 | VQFN-48-EP(7x7) | Extended | 0 | 5.6809 | 5.5555 | 5.3878 | 0 | 5.6015 | 5.4323 | -40℃~+125℃ 1A、2A SPI VQFN-48-EP(7x7) Gate Drivers ROHS | ok
Gate driver | DRV8323RHRGZR | DRV8323RHRGZR | Texas Instruments | C543035 | VQFN-48-EP(7x7) | Extended | 754 | 3.1858 | 2.7151 | 2.119 | 732 | 2.738 | 2.1369 | -40℃~+125℃ 12uA 1A 2A 6V~60V Half-Bridge、Three Phase MOSFET Under Voltage Protection、Over Current Protection、Short Circuit Protection、Overtemperature protection | ok
Gate driver | DRV8323SRTAR | DRV8323SRTAR | Texas Instruments | C701784 | WQFN-40-EP(6x6) | Extended | 158 | 4.1141 | 3.5034 | 2.7721 | 158 | 3.5393 | 2.8005 | -40℃~+125℃ 12uA 1A 3 6V~60V SPI Three Phase WQFN-40-EP(6x6) Brushless DC (BLDC) Motor Driver ROHS | ok
Gate driver | DRV8353RSRGZR | DRV8353RSRGZR | Texas Instruments | C506246 | VQFN-48-EP(7x7) | Extended | 1675 | 5.7591 | 5.2347 | 4.6092 | 1580 | 5.2462 | 4.6194 | -40℃~+125℃ 1.5V 1A 20uA 2A 3 6V~95V 800mV MOSFET Three Phase Under Voltage Protection、Over Current Protection、Overtemperature protection (OTP)、Enable shutdown、I | ok
Gate driver | DRV8353SRTAR | DRV8353SRTAR | Texas Instruments | C701785 | WQFN-40-EP(6x6) | Extended | 72 | 4.4219 | 3.9741 | 3.4382 | 0 | 3.9834 | 3.4463 | -40℃~+125℃ 1.5V 20uA 6 800mV 9V~75V MOSFET Three Phase Under Voltage Protection、Over Current Protection、Overtemperature protection (OTP) WQFN-40-EP(6x6) Gate Dr | ok
Gate driver | DRV8353RHRGZR | DRV8353RHRGZR | Texas Instruments | C2868224 | VQFN-48-EP(7x7) | Extended | 5 | 6.619 | 5.922 | 5.0474 | 5 | 5.9691 | 5.0875 | -40℃~+125℃ 1.5V 1A 20uA 2A 3 800mV 9V~75V MOSFET Three Phase Under Voltage Protection、Over Current Protection、Overtemperature protection (OTP)、Enable shutdown、I | ok
Gate driver | DRV8301DCAR | DRV8301DCAR | Texas Instruments | C98969 | HTSSOP-56-6mm | Extended | 7034 | 3.3714 | 2.9317 | 2.1955 | 7034 | 2.9562 | 2.2139 | -40℃~+125℃ 1.7A 2.3A 20uA 25ns 25ns 6 6V~60V MOSFET Three Phase Under Voltage Protection、Over Voltage Protection、Over Current Protection、Overtemperature protect | ok
Gate driver | DRV8320SRHAR | DRV8320SRHAR |  |  |  |  |  |  |  |  |  |  |  |  | not found on JLCPCB/LCSC
Gate driver | 6EDL7141 | 6EDL7141XUMA1 | Infineon Technologies | C3655737 | VQFN-48 | Extended | 263 | 4.689 | 3.9969 | 3.0148 | 263 | 4.0288 | 3.0388 | -40℃~+125℃ 1.5A 1.5A 25ns 3 5.5V~60V Half-Bridge MOSFET Under Voltage Protection、Over Voltage Protection、Over Current Protection、Overtemperature protection (OTP | ok
Gate driver | 6EDL7141 | 6EDL7141XUMA1 | JLCPCB Assembly | C9900012446 | PG-VQFN-48-78 | Extended | 0 | 0.0007 | 0.0007 | 0.0007 |  |  |  | PG-VQFN-48-78 SMT ROHS | ok
Gate driver | STDRIVE101 | STDRIVE101 | STMicroelectronics | C2969847 | VFQFPN-24(4x4) | Extended | 357 | 2.1499 | 1.8014 | 1.36 | 111 | 1.8154 | 1.3706 | -40℃~+125℃ 0V~800mV 1.7mA 2V~5V 3 5.5V~75V 600mA 600mA Enable shutdown、Interleaved conduction protection、Dead-time control、Overcurrent Protection、Built-in boots | ok
Gate driver | STDRIVE101 | STDRIVE101TR | STMicroelectronics | C3655697 | VFQFPN-24 | Extended | 6 | 2.0147 | 1.7265 | 1.3014 | 6 | 1.7372 | 1.3095 | -40℃~+125℃ 0V~800mV 1.7mA 2V~5V 5.5V~75V 600mA 600mA Half-Bridge MOSFET Over Current Protection、Overtemperature protection (OTP)、Enable shutdown、Interleaved con | ok
Gate driver | MP6539 | MP6539GV-Z | Monolithic Power Systems | C5676243 | QFN-28(4x5) | Extended | 1022 | 3.1519 | 3.1519 | 2.6501 |  |  |  | -40℃~+125℃ 1A 6 700uA 800mA 8V~100V Enable shutdown、Interleaved conduction protection、Dead-time control、Charge pump boost MOSFET Three Phase QFN-28(4x5) Gate Dr | ok
Gate driver | MP6539 | MP6539GF-Z | Monolithic Power Systems | C6097207 | TSSOP-28-EP | Extended | 62 | 3.3835 | 3.3835 | 2.8431 |  |  |  | -40℃~+125℃ 1A 2V 6 700uA 800mA 800mV 8V~100V MOSFET Three Phase Under Voltage Protection、Over Current Protection、Overtemperature protection (OTP) TSSOP-28-EP Ga | ok
Gate driver | MP6539 | MP6539GF-P | Monolithic Power Systems | C5776344 | TSSOP-28-EP | Extended | 0 | 0.7737 | 0.6304 | 0.4854 |  |  |  | -40℃~+125℃ 1A 6 800mA 8V~100V MOSFET Three Phase TSSOP-28-EP Gate Drivers ROHS | ok
Gate driver | MP6539 | MP6539GV-P | Monolithic Power Systems | C6674797 | QFN-28(4x5) | Extended | 0 | 0.7346 | 0.5978 | 0.461 |  |  |  | Interleaved conduction protection QFN-28(4x5) Gate Drivers ROHS | ok
Gate driver | MP6539 | MP6539BGF-Z | Monolithic Power Systems | C3655671 | TSSOP-28-EP | Extended | 10 | 2.4572 | 2.4572 | 2.1485 |  |  |  | -40℃~+125℃ 1.1mA 1A 2 2V 8.5V~14V 800mA 800mV MOSFET Three Phase Under Voltage Protection、Over Temperature Protection TSSOP-28-EP Gate Drivers ROHS | ok
Gate driver | MP6539 | MP6539BGV-Z | Monolithic Power Systems | C7231731 | QFN-28(4x5) | Extended | 58 | 2.4572 | 2.4572 | 2.1485 |  |  |  | -40℃~+125℃ 2uA 3 8.5V~14V Interleaved conduction protection No PWM Three Phase QFN-28(4x5) Gate Drivers ROHS | ok
Gate driver | MP6539 | MP6539BGV-P | Monolithic Power Systems | C3655464 | QFN-28(4x5) | Extended | 0 | 0.6352 | 0.5131 | 0.3926 |  |  |  | -40℃~+125℃ 1A 2 8.5V~14V 800mA MOSFET Three Phase QFN-28(4x5) Gate Drivers ROHS | ok
Gate driver | MP6539 | MP6539BGF-P | Monolithic Power Systems | C6228184 | TSSOP-28-EP | Extended | 0 | 0.7623 | 0.6206 | 0.4789 |  |  |  | -40℃~+125℃ 1A 6 8.5V~14V 800mA MOSFET Three Phase TSSOP-28-EP Gate Drivers ROHS | ok
Gate driver | FD6288Q | FD6288Q | LCSC | C97677 | QFN-24 | Extended | 0 | 0.5294 | 0.4887 | 0.4072 |  |  |  | QFN-24-EP(4x4) Gate Drivers ROHS | ok
Gate driver | FD6288Q | FD6288Q | Fortior Tech | C328453 | QFN-24-EP(4x4) | Extended | 0 | 2.3535 | 1.8828 | 1.3291 | 0 | 1.8984 | 1.3401 | -40℃~+125℃ 1.5A 1.8A 100ns 12ns 12ns 2.7V 3 300ns 330uA 5V~20V 800mV IGBT、MOSFET Three Phase Under Voltage Protection QFN-24-EP(4x4) Gate Drivers ROHS | ok
Gate driver | FD6288Q | FD6288Q | JSMSEMI | C7466367 | QFN-24-EP(4x4) | Extended | 0 | 0.5603 | 0.4512 | 0.3421 |  |  |  | -40℃~+125℃ 1.5A 1.8A 230uA 3 30ns 30ns 8V~20V Interleaved conduction protection、Dead-time control Low Side、High Side、Three Phase MOSFET QFN-24-EP(4x4) Gate Driv | ok
Gate driver | FD6288Q | FD6288Q-Y1 | YLPTEC | C53446573 | QFN-24-EP(4x4) | Extended | 0 | 0.4903 | 0.3877 | 0.29 |  |  |  | QFN-24-EP(4x4) Gate Drivers ROHS | ok
Gate driver | FD6288T | FD6288T | Fortior Tech | C97683 | TSSOP-20 | Extended | 0 | 0.8828 | 0.7313 | 0.5359 | 0 | 0.7276 | 0.5331 | -40℃~+125℃ 1.5A 1.8A 12ns 12ns 2.7V 330uA 4.8V~20V 6 800mV Half-Bridge IGBT、MOSFET Under Voltage Protection、Short Circuit Protection TSSOP-20 Gate Drivers ROHS | ok
Gate driver | FD6288T | FD6288T | JSMSEMI | C5804616 | TSSOP-20 | Extended | 0 | 0.4007 | 0.3095 | 0.2199 |  |  |  | -40℃~+125℃ 1.5A 1.8A 230uA 3 30ns 30ns 8V~20V Low Side、High Side、Three Phase MOSFET TSSOP-20 Gate Drivers ROHS | ok
Gate driver | EG2133 | EG2133 | EG Micro | C190343 | TSSOP-20 | Extended | 0 | 0.5522 | 0.4317 | 0.316 | 3996 | 0.3776 | 0.3069 | -300mV~1V -40℃~+125℃ 1.2A 1.4A 100nA 20ns 25ns 4.5V~20V Half-Bridge、Three Phase IGBT、MOSFET TSSOP-20 Gate Drivers ROHS | ok
Gate driver | EG2133 | EG2133 | EG Micro | C405330 | TSSOP-20 | Extended | 0 | 0.4414 | 0.3486 | 0.259 | 0 | 0.347 | 0.2579 | -300mV~1V -40℃~+125℃ 1.2A 1.4A 20ns 25ns 300uA 4.5V~20V Half-Bridge、Three Phase IGBT、MOSFET TSSOP-20 Gate Drivers ROHS | ok
MOSFET | BSC040N08NS5 | BSC040N08NS5 | Infineon Technologies | C534333 | TDSON-8(5x6) | Extended | 6574 | 1.3225 | 1.088 | 0.8128 | 6377 | 1.0979 | 0.8202 | -55℃~+150℃ 1 N-channel 100A 104W 3.8V 3.9nF 42pF 43nC@10V 4mΩ@10V 80V TDSON-8(5x6) MOSFETs ROHS | ok
MOSFET | BSC040N08NS5 | BSC040N08NS5ATMA1-VB | VBsemi Elec | C22395976 | DFN5x6-8 | Extended | 5 | 1.8616 | 1.6027 | 1.2997 | 5 | 1.6012 | 1.2985 | -55℃~+175℃ 1 N-channel 136W 140A 225pF 3V 470pF 4mΩ@4.5V 8.6nF 85V 92nC@10V N-Channel ±20V DFN5x6-8 MOSFETs ROHS | ok
MOSFET | BSC040N08NS5 | BSC040N08NS5 | Infineon Technologies | C2986577 | TDSON-8 | Extended | 0 | 2.5261 | 2.1646 | 1.6336 | 0 | 2.0051 | 1.5133 | -55℃~+150℃ 1 N-channel 104W 121A 3.8V@67uA 3.9nF 42pF 43nC@10V 4mΩ@10V 650pF 80V N-Channel TDSON-8 MOSFETs ROHS | ok
MOSFET | BSC040N08NS5 | BSC040N08NS5-VB | VBsemi Elec | C22395977 | DFN5x6-8 | Extended | 0 | 1.3861 | 1.1792 | 0.974 | 0 | 1.1794 | 0.9742 | -55℃~+175℃ 140A 225pF 3V@250uA 470pF 4mΩ@4.5V 8.6nF 85V 92nC N-Channel DFN5x6-8 MOSFETs ROHS | ok
MOSFET | BSC040N08NS5 | BSC040N08NS5ATMA1 | Infineon Technologies | C152216 | PG-TDSON-8_EP_5.2x6.2x1.27P | Extended | 0 | 2.6923 | 2.3372 | 2.2069 |  |  |  | 100A 104W 3.8V@67uA 4mΩ@10V,50A 80V N-Channel PG-TDSON-8(6x5) MOSFETs ROHS | ok
MOSFET | BSC026N08NS5 | BSC026N08NS5 | Infineon Technologies | C534311 | TDSON-8-EP(5x6) | Extended | 0 | 3.0148 | 2.6222 | 2.1239 |  |  |  | TDSON-8-EP(5x6) MOSFETs ROHS | ok
MOSFET | BSC026N08NS5 | BSC026N08NS5-VB | VBsemi Elec | C22395986 | DFN-8-EP(5x6) | Extended | 9 | 1.9773 | 1.7199 | 1.417 | 9 | 1.7183 | 1.4157 | -55℃~+175℃ 1 N-channel 136W 140A 225pF 3V 470pF 4mΩ@4.5V 8.6nF 85V 92nC@0V N-Channel DFN-8-EP(5x6) MOSFETs ROHS | ok
MOSFET | BSC026N08NS5 | BSC026N08NS5ATMA1 | Infineon Technologies | C5955453 | TDSON-8 | Extended | 5379 | 1.5457 | 1.2737 | 0.9561 | 5105 | 1.2824 | 0.9626 | -55℃~+150℃ 1 N-channel 156W 184A 2.6mΩ@10V 3.8V 6.8nF 66pF 74nC 80V TDSON-8 MOSFETs ROHS | ok
MOSFET | BSC026N08NS5 | BSC026N08NS5ATMA1-VB | VBsemi Elec | C22395985 | DFN5x6-8 | Extended | 2 | 1.8502 | 1.5913 | 1.2883 | 2 | 1.5873 | 1.2851 | -55℃~+175℃ 1 N-channel 136W 140A 225pF 3V@250uA 3mΩ@10V 470pF 8.6nF 85V 92nC@10V N-Channel DFN5x6-8 MOSFETs ROHS | ok
MOSFET | BSC014N06NS | BSC014N06NS | Infineon Technologies | C113391 | TDSON-8-FL | Extended | 29960 | 1.505 | 1.1988 | 0.8405 | 29960 | 1.2087 | 0.8474 | -55℃~+150℃ 1 N-channel 1.45mΩ@10V 1.875nF 100A 104nC@10V 118pF 156W 3.3V 60V 8.125nF N-Channel TDSON-8-FL MOSFETs ROHS | ok
MOSFET | BSC014N06NS | BSC014N06NSTATMA1 | Infineon Technologies | C3278639 | TDSON-8FL | Extended | 5 | 3.6695 | 3.2249 | 2.6939 | 5 | 3.2168 | 2.6872 | -55℃~+175℃ 1 N-channel 1.45mΩ@10V 1.875nF 104nC@10V 118pF 188W 257A 3.3V 60V 8.125nF N-Channel TDSON-8FL MOSFETs ROHS | ok
MOSFET | BSC014N06NS | BSC014N06NST | Infineon Technologies | C534290 | TDSON-8-EP(5x6) | Extended | 0 | 5.2021 | 5.2021 | 5.2021 |  |  |  | TDSON-8-EP(5x6) MOSFETs ROHS | ok
MOSFET | BSC014N06NS | BSC014N06NSATMA1 | Infineon Technologies | C3278670 | TDSON-8 | Extended | 0 | 2.6092 | 2.5408 | 2.4512 | 0 | 2.4115 | 2.3265 | -55℃~+150℃ 1 N-channel 1.45mΩ@10V 1.875nF 104nC@10V 118pF 156W 240A 3.3V 60V 8.125nF N-Channel TDSON-8 MOSFETs ROHS | ok
MOSFET | BSC014N06NS | BSC014N06NSSCATMA1 | Infineon Technologies | C6516242 | WSON-8 | Extended | 0 | 7.106 | 6.9888 | 6.8324 | 0 | 6.984 | 6.8277 | -55℃~+175℃ 1 N-channel 1.4mΩ@10V 104nC@10V 118pF 188W 261A 3.3V 60V 8.125nF WSON-8 MOSFETs ROHS | ok
MOSFET | BSC014N06NS | BSC014N06NSSC | Infineon Technologies | C534289 | TDSON-8(5.9x5.2) | Extended | 0 | 4.6337 | 4.6337 | 4.6337 |  |  |  | TDSON-8(5.9x5.2) MOSFETs ROHS | ok
MOSFET | BSC014N06NS | BSC014N06NSTATMA1-JSM | JSMSEMI | C55509879 | DFN-8L(5x6) | Extended | 4976 | 0.8584 | 0.6955 | 0.5359 | 4976 | 0.6998 | 0.5392 | -55℃~+150℃ 1 N-channel 1.1mΩ@10V 198W 2.75nF 265A 3V 6.99nF 60V 60pF 85nC N-Channel ±20V DFN-8L(5x6) MOSFETs ROHS | ok
MOSFET | BSC030N08NS5 | BSC030N08NS5 | Infineon Technologies | C501507 | TDSON-8(5x6) | Extended | 24529 | 0.9251 | 0.7688 | 0.5685 | 24529 | 0.7748 | 0.5729 | -55℃~+150℃ 1 N-channel 100A 139W 3.8V 3mΩ@10V 5.6nF 56pF 76nC@10V 80V TDSON-8(5x6) MOSFETs ROHS | ok
MOSFET | BSC030N08NS5 | BSC030N08NS5ATMA1-VB | VBsemi Elec | C22395982 | DFN5x6-8 | Extended | 121 | 1.531 | 1.2721 | 0.9691 | 121 | 1.2697 | 0.9673 | -55℃~+175℃ 1 N-channel 140A 225pF 3V 470pF 4mΩ@4.5V 8.3W 8.6nF 85V 92nC@10V N-Channel DFN5x6-8 MOSFETs ROHS | ok
MOSFET | BSC030N08NS5 | BSC030N08NS5-VB | VBsemi Elec | C22395983 | DFN5x6-8 | Extended | 51 | 1.6743 | 1.4154 | 1.1124 | 51 | 1.4273 | 1.1218 | -55℃~+175℃ 1 N-channel 140A 225pF 3V@250uA 470pF 4mΩ@4.5V 8.3W 8.6nF 85V 92nC N-Channel DFN5x6-8 MOSFETs ROHS | ok
MOSFET | BSC030N08NS5 | BSC030N08NS5ATMA1 | Infineon Technologies | C3288905 | TDSON-8 | Extended | 0 | 1.1108 | 0.9284 | 0.6857 | 0 | 0.8779 | 0.6484 | -55℃~+150℃ 1 N-channel 139W 161A 3.8V 4.5mΩ@6V 5.6nF 56pF 76nC@10V 80V 910pF N-Channel TDSON-8 MOSFETs ROHS | ok
MOSFET | BSC030N08NS5 | BSC030N08NS5(TOKMAS) | Tokmas | C19626233 | DFN-8(5x6) | Extended | 0 | 0.8633 | 0.6939 | 0.5261 | 0 | 0.6958 | 0.5276 | -55℃~+150℃ 1 N-channel 1.63nF 130A 132W 224pF 3.3mΩ 4V 5.66nF 71.4nC@10V 80V N-Channel DFN-8(5x6) MOSFETs ROHS | ok
MOSFET | BSC030N08NS5 | BSC030N08NS5-TP | TECH PUBLIC | C50314226 | PDFN-8L(5x6) | Extended | 288 | 1.0326 | 0.8519 | 0.6401 | 288 | 0.8547 | 0.6422 | -55℃~+150℃ 1 N-channel 31pF 36.5nC@10V 3V 4.194nF 4.5mΩ@10V 665pF 83W 85A 85V PDFN-8L(5x6) MOSFETs ROHS | ok
MOSFET | BSC030N08NS5 | BSC030N08NS5(ES) | ElecSuper | C49108769 | PDFN-8L(5x6) | Extended | 266 | 1.0001 | 0.816 | 0.6336 | 266 | 0.8238 | 0.6396 | -55℃~+150℃ 1 N-channel 1.536nF 100V 138A 139W 19pF 2.7V 3.658nF 3mΩ@10V 49nC@10V N-Channel PDFN-8L(5x6) MOSFETs ROHS | ok
MOSFET | BSC030N08NS5 | BSC030N08NS5ATMA1 | JLCPCB Assembly | C9900005279 | TDSON-8 | Extended | 0 | 0.0007 | 0.0007 | 0.0007 |  |  |  | TDSON-8 SMT ROHS | ok
MOSFET | TPH4R008NH | TPH4R008NH | JLCPCB Assembly | C9900010785 | DFN5X6-8L | Extended | 0 | 0.0007 | 0.0007 | 0.0007 |  |  |  | DFN5X6-8L SMT ROHS | ok
MOSFET | TPH4R008NH | TPH4R008NH-TP | TECH PUBLIC | C50314368 | DFN-8L(5x6) | Extended | 285 | 1.044 | 0.8633 | 0.6515 | 285 | 0.8706 | 0.657 | -55℃~+150℃ 1 N-channel 31pF 36.5nC@10V 3V 4.194nF 4.5mΩ@10V 665pF 83W 85A 85V DFN-8L(5x6) MOSFETs ROHS | ok
MOSFET | TPH4R008NH | TPH4R008NH,L1Q | TOSHIBA | C141587 | SOP-8 | Extended | 4792 | 1.044 | 0.8567 | 0.6369 | 4792 | 0.8636 | 0.642 | 1 N-channel 100A 4V 4mΩ@10V 5.3nF 59nC@10V 64pF 78W 80V N-Channel SOP-8 MOSFETs ROHS | ok
MOSFET | TPH4R008NH | TPH4R008NHLQ(M1 | TOSHIBA | C5220794 | SOP-8-Advance | Extended | 19 | 0.601 | 0.4805 | 0.3632 | 19 | 0.4535 | 0.3428 | 12ns 8.6ns MOSFET SOP-8-Advance MOSFETs ROHS | ok
MOSFET | TPH4R008NH | TPH4R008NH,L1Q(M | TOSHIBA | C396039 | SOP-8-Advance | Extended | 3685 | 1.487 | 1.2183 | 0.9056 | 3685 | 1.2294 | 0.9139 | 1 N-channel 100A 4V 4mΩ@10V 5.3nF 59nC@10V 64pF 78W 80V N-Channel SOP-8-Advance MOSFETs ROHS | ok
MOSFET | TPH4R008NH | TPH4R008NH1,LQ(M | TOSHIBA | C5274169 | SOP | Extended | 3166 | 0.9756 | 0.8747 | 0.7574 | 3166 | 0.8806 | 0.7626 | -55℃~+150℃ 1 N-channel 116A 170W 3.3mΩ@10V 32pF 4.1nF 4V 59nC@10V 80V 890pF N-Channel SOP MOSFETs ROHS | ok
MOSFET | TPH2R408QM | TPH2R408QM,L1Q | TOSHIBA | C5802574 | SOP-8 | Extended | 171 | 3.2835 | 2.7965 | 2.1809 | 80 | 2.8228 | 2.2013 | 1 N-channel 1.34nF 120A 2.43mΩ@10V 3.5V 3W、210W 60pF 8.3nF 80V 87nC@10V N-Channel SOP-8 MOSFETs ROHS | ok
MOSFET | CSD19502Q5B | CSD19502Q5B | Texas Instruments | C2864118 | VSON-CLIP-8(6x5) | Extended | 7508 | 1.5473 | 1.3698 | 1.1287 | 6760 | 1.3826 | 1.1393 | -55℃~+150℃ 1 N-channel 1.202nF 157A 195W 2.7V 22pF 3.4mΩ@10V 4.87nF 48nC@10V 80V N-Channel VSON-CLIP-8(6x5) MOSFETs ROHS | ok
MOSFET | CSD19502Q5B | CSD19502Q5BT | Texas Instruments | C2868625 | VSON-CLIP-8(6x5) | Extended | 0 | 1.3453 | 1.316 | 1.2769 | 0 | 1.2366 | 1.1998 | VSON-CLIP-8(6x5) MOSFETs ROHS | ok
MOSFET | CSD19532Q5B | CSD19532Q5B | Texas Instruments | C473333 | SON-8(5x6) | Extended | 2410 | 2.1401 | 1.8291 | 1.3519 | 2049 | 1.8436 | 1.3626 | -55℃~+150℃ 1 N-channel 100A 100V 18pF 195W 2.6V 4.6mΩ@6V 4.81nF 48nC@10V 706pF N-Channel SON-8(5x6) MOSFETs ROHS | ok
MOSFET | CSD19532Q5B | CSD19532Q5BT | Texas Instruments | C2832190 | VSON-8-EP(5x6) | Extended | 33 | 2.2216 | 1.8616 | 1.6369 | 33 | 1.8784 | 1.6516 | -55℃~+150℃ 1 N-channel 100A 100V 18pF 195W 2.6V 4.81nF 48nC@10V 4mΩ@10V 918pF N-Channel VSON-8-EP(5x6) MOSFETs ROHS | ok
MOSFET | CSD19532Q5B | CSD19532Q5B-JSM | JSMSEMI | C55112138 | DFN-8L(5x6) | Extended | 556 | 1.088 | 0.9121 | 0.7069 | 556 | 0.9208 | 0.7136 | -55℃~+150℃ 1 N-channel 100A 100V 154W 20pF 3.92nF 4.1mΩ@10V 4V 590pF 59nC N-Channel ±20V DFN-8L(5x6) MOSFETs ROHS | ok
MOSFET | CSD19532Q5B | CSD19532Q5BT-HXY | HXY MOSFET | C55510086 | DFN-8L(5x6) | Extended | 25 | 1.7183 | 1.4642 | 1.1401 | 25 | 1.4733 | 1.1472 | DFN-8L(5x6) MOSFETs ROHS | ok
MOSFET | CSD18540Q5B | CSD18540Q5B | Texas Instruments | C86513 | VSON-8(5x6) | Extended | 10 | 2.2949 | 2.1011 | 1.7102 | 0 | 2.1162 | 1.7225 | -55℃~+175℃ 1 N-channel 1.9V 2.6mΩ 205A 20pF 3.8W 4.23nF 41nC@10V 60V 808pF N-Channel VSON-8(5x6) MOSFETs ROHS | ok
MOSFET | CSD18540Q5B | CSD18540Q5BT | Texas Instruments | C2863985 | VSON-CLIP-8(6x5) | Extended | 2 | 2.1353 | 1.803 | 1.5929 | 2 | 1.8199 | 1.6079 | VSON-CLIP-8(6x5) MOSFETs ROHS | ok
MOSFET | CSD18540Q5B | CSD18540Q5B(ES) | ElecSuper | C49108747 | PDFN-8L(5x6) | Extended | 3939 | 0.8958 | 0.7264 | 0.5587 | 2981 | 0.7231 | 0.5561 | 1 N-channel 1.6V 1.9mΩ@10V、2.6mΩ@4.5V 102nC@10V 135pF 156W 190A 2.2nF 5.44nF 60V N-Channel PDFN-8L(5x6) MOSFETs ROHS | ok
MOSFET | CSD18540Q5B | CSD18540Q5B-JSM | JSMSEMI | C55107000 | PDFN-8L(5x6) | Extended | 4328 | 1.0066 | 0.8177 | 0.6287 | 4328 | 0.8176 | 0.6287 | -55℃~+150℃ 1 N-channel 1.5mΩ@10V 198W 2.75nF 210A 3V 6.99nF 60V 60pF 85nC N-Channel ±20V PDFN-8L(5x6) MOSFETs ROHS | ok
MOSFET | CSD18540Q5B | CSD18540Q5B(TOKMAS) | Tokmas | C19626234 | DFN-8(5x6) | Extended | 4909 | 0.9056 | 0.7362 | 0.5685 | 4909 | 0.7432 | 0.5739 | -55℃~+150℃ 1 N-channel 1.25nF 100nC@10V 132W 2.3mΩ 2.5V 200A 58pF 6.6nF 60V N-Channel DFN-8(5x6) MOSFETs ROHS | ok
MOSFET | CSD18532Q5B | CSD18532Q5B | Texas Instruments | C882766 | SON-8(5x6) | Extended | 2356 | 2.0213 | 1.8502 | 1.619 | 2174 | 1.867 | 1.6336 | -55℃~+150℃ 1 N-channel 1.8V 100A 156W 17pF 2.5mΩ@10V 44nC@10V 5.07nF 60V 611pF N-Channel SON-8(5x6) MOSFETs ROHS | ok
MOSFET | CSD18532Q5B | CSD18532Q5BT | Texas Instruments | C2876541 | SON-8(5x6) | Extended | 182 | 2.7981 | 2.3568 | 2.0799 | 182 | 2.3714 | 2.0928 | -55℃~+150℃ 1 N-channel 1.8V 156W 172A 17pF 2.5mΩ@10V 44nC@10V 5.07nF 60V 611pF N-Channel SON-8(5x6) MOSFETs ROHS | ok
MOSFET | CSD18532Q5B | CSD18532Q5B(ES) | ElecSuper | C55067980 | PDFN-8L(5x6) | Extended | 44 | 1.632 | 1.3681 | 1.0587 | 44 | 1.3772 | 1.0657 | PDFN-8L(5x6) MOSFETs ROHS | ok
MOSFET | NTMFS6H818NL | NTMFS6H818NLT1G | onsemi | C900317 | DFN-5(5.9x4.9) | Extended | 20 | 2.7265 | 2.6841 | 2.6255 | 20 | 2.7008 | 2.6418 | -55℃~+175℃ 1 N-channel 135A 140W 2.7mΩ@10V 21pF 2V 3.844nF 64nC@10V 80V DFN-5(5.9x4.9) MOSFETs ROHS | ok
MOSFET | NTMFS5C628NL | NTMFS5C628NLT1G | onsemi | C145537 | SO-8FL | Extended | 7957 | 0.7737 | 0.619 | 0.4642 | 7957 | 0.6174 | 0.4631 | -55℃~+175℃ 1 N-channel 1.7nF 110W 150A 28pF 2V 3.3mΩ@4.5V 3.6nF 52nC@10V 60V N-Channel SO-8FL MOSFETs ROHS | ok
MOSFET | NTMFS5C628NL | NTMFS5C628NLT3G | onsemi | C604443 | SO-8FL | Extended | 5 | 3.0946 | 3.0424 | 2.9757 | 5 | 3.0348 | 2.9682 | -55℃~+175℃ 1 N-channel 150A 2.4mΩ@10V 28pF 2V 3.6nF 3.7W、110W 52nC@10V 60V SO-8FL MOSFETs ROHS | ok
MOSFET | NTMFS5C628NL | NTMFS5C628NLT1G-VB | VBsemi Elec | C55251731 | DFN-8(5x6) | Extended | 4 | 0.7867 | 0.7704 | 0.7476 | 4 | 0.7726 | 0.7497 | DFN-8(5x6) MOSFETs ROHS | ok
MOSFET | NTMFS5C628NL | NTMFS5C628NLT1G(ES) | ElecSuper | C49108756 | PDFN-8L(5x6) | Extended | 5935 | 0.5359 | 0.43 | 0.3242 | 5935 | 0.4336 | 0.3268 | 1 N-channel 1.6V 1.9mΩ@10V、2.6mΩ@4.5V 102nC@10V 135pF 156W 190A 2.2nF 5.44nF 60V N-Channel PDFN-8L(5x6) MOSFETs ROHS | ok
MOSFET | NTMFS5C628NL | NTMFS5C628NLT1G(TOKMAS) | Tokmas | C48586472 | DFN-8(5x6) | Extended | 0 | 0.4952 | 0.3877 | 0.2851 | 0 | 0.3887 | 0.2858 | -55℃~+150℃ 1 N-channel 1.666nF 140W 150A 2.5V@250uA 2.7mΩ@10V 5.377nF 60V 66.1nC@10V 77.7pF N-Channel DFN-8(5x6) MOSFETs ROHS | ok
MOSFET | NTMFS5C646NL | NTMFS5C646NLT1G | onsemi | C153736 | DFN-5(5.9x4.9) | Extended | 0 | 3.7802 | 3.7363 | 3.6776 | 0 | 3.7269 | 3.6684 | -55℃~+175℃ 1 N-channel 2.164nF 2V 33.7nC@10V 6.3mΩ@4.5V 60V 900pF 93A N-Channel DFN-5(5.9x4.9) MOSFETs ROHS | ok
MOSFET | NTMFS5C646NL | NTMFS5C646NLT3G | onsemi | C893886 | DFN-5(5.9x4.9) | Extended | 0 | 2.0913 | 1.7786 | 1.3812 | 0 | 1.681 | 1.3054 | -55℃~+175℃ 1 N-channel 15.7nC@4.5V 17pF 2.164nF 2V 3.8mΩ@10V 60V 79W DFN-5(5.9x4.9) MOSFETs ROHS | ok
MOSFET | NTMFS5C646NL | NTMFS5C646NLT3G-HXY | HXY MOSFET | C51949325 | DFN-8L(5x6) | Extended | 99 | 1.7574 | 1.5131 | 1.202 | 99 | 1.5081 | 1.1981 | -55℃~+150℃ 1 N-channel 1.673nF 100A 2.9V 28.5nC@10V 3.7mΩ@10V 46.8pF 60V 73.5W 773pF N-Channel Standalone ±20V DFN-8L(5x6) MOSFETs ROHS | ok
MOSFET | NCEP85T14 | NCEP85T14 | Wuxi NCE Power Semiconductor | C216782 | TO-220 | Extended | 0 | 1.3144 | 1.0375 | 0.7639 | 0 | 0.9845 | 0.7249 | -55℃~+175℃ 1 N-channel 140A 200W 4.1mΩ@10V 4V 5.6nF 60pF 85V 8nC@10V N-Channel TO-220 MOSFETs ROHS | ok
MOSFET | NCEP85T14 | NCEP85T14D | Wuxi NCE Power Semiconductor | C2686595 | TO-263-2L | Extended | 0 | 0.9251 | 0.7313 | 0.5375 | 0 | 0.6939 | 0.51 | -55℃~+175℃ 1 N-channel 140A 200W 4V 4mΩ@10V 5.6nF 60pF 85V 8nC@10V N-Channel TO-263-2L MOSFETs ROHS | ok
MOSFET | NCEP0178AG | NCEP0178AG |  |  |  |  |  |  |  |  |  |  |  |  | not found on JLCPCB/LCSC
MOSFET | NCEP6080AGU | NCEP6080AGU |  |  |  |  |  |  |  |  |  |  |  |  | not found on JLCPCB/LCSC
MOSFET | NCEP85T25VGU | NCEP85T25VGU |  |  |  |  |  |  |  |  |  |  |  |  | not found on JLCPCB/LCSC
MOSFET | NCEP60T20AGU | NCEP60T20AGU |  |  |  |  |  |  |  |  |  |  |  |  | not found on JLCPCB/LCSC
MOSFET | SIR680ADP | SIR680ADP-T1-RE3 | Vishay Intertech | C3289502 | PowerPAK-SO-8 | Extended | 999 | 7.4155 | 6.3324 | 5.119 | 999 | 6.3784 | 5.1562 | -55℃~+150℃ 1 N-channel 125A 26pF 3.5V 3.5mΩ@7.5V 4.415nF 614pF 80V 80W 83nC@10V N-Channel PowerPAK-SO-8 MOSFETs ROHS | ok
MOSFET | AON6276 | AON6276 | Alpha & Omega Semicon | C3288304 | DFN-8(5x6) | Extended | 0 | 1.5229 | 1.5229 | 1.5229 | 0 | 1.4427 | 1.4427 | -55℃~+150℃ 1 N-channel 100A 100nC@10V 2.6mΩ@10V 215W 3.2V 4.94nF 80V DFN-8(5x6) MOSFETs ROHS | ok
MOSFET | IPT020N08N5 | IPT020N08N5 |  |  |  |  |  |  |  |  |  |  |  |  | not found on JLCPCB/LCSC
MOSFET | IPT012N08N5 | IPT012N08N5 | Infineon Technologies | C531199 | HSOF-8 | Extended | 5825 | 2.7704 | 2.3812 | 1.8877 | 5825 | 2.396 | 1.8994 | -55℃~+175℃ 1 N-channel 1.2mΩ@10V 300A 375W 3V 80V N-Channel HSOF-8 MOSFETs ROHS | ok
MOSFET | IPT012N08N5 | IPT012N08N5-VB | VBsemi Elec | C22395929 | TOLL-8 | Extended | 5 | 2.8291 | 2.3959 | 1.8486 | 5 | 2.354 | 1.8163 | -55℃~+150℃ 1 N-channel 15nF 21pF 246pF 350A 370W 4.5V 80V 80nC@10V N-Channel TOLL-8 MOSFETs ROHS | ok
MOSFET | IPT012N08N5 | IPT012N08N5ATMA1 | Infineon Technologies | C122550 | PG-HSOF-8-1 | Extended | 0 | 8.0686 | 6.9806 | 6.5816 |  |  |  | 1.2mΩ@10V,150A 3.8V@280uA 300A 375W 80V N-Channel PG-HSOF-8-1 MOSFETs ROHS | ok
MOSFET | IPT012N08N5 | IPT012N08N5(TOKMAS) | Tokmas | C19626224 | HSOF-8 | Extended | 481 | 0.9463 | 0.8535 | 0.7818 | 481 | 0.8622 | 0.7898 | 0.9mΩ 1 N-channel 14.49nF 2.35nF 240nC@10V 2V 300A 472pF 500W 85V N-Channel HSOF-8 MOSFETs ROHS | ok
MOSFET | IPT012N08N5 | IPT012N08N5ATMA1-VB | VBsemi Elec | C22395928 | TOLL-8 | Extended | 0 | 3.3959 | 2.9643 | 2.4154 | 0 | 2.9569 | 2.4094 | -55℃~+150℃ 1 N-channel 180W 18nF 1mΩ@10V 21pF 246pF 350A 4.5V 80V 80nC N-Channel TOLL-8 MOSFETs ROHS | ok
Shunt | 1mΩ 2512 | YLR12-2-1F-W | Shenzhen Yezhan Elec. | C469371 | 2512 | Extended | 45428 | 0.1005 | 0.1005 | 0.0802 | 45395 | 0.1003 | 0.08 | 1mΩ 2W Current Sense Resistor SMD ±1% ±50ppm/℃ 2512 Current Sense Resistors / Shunt Resistors ROHS | ok
Shunt | 1mΩ 2512 | ASR-M-3-1F | Shenzhen Yezhan Elec. | C469427 | 2512 | Extended | 42042 | 0.2733 | 0.2733 | 0.2159 | 41470 | 0.2755 | 0.2176 | 1mΩ 5W SMD Shunt ±1% ±100ppm/℃ 2512 Current Sense Resistors / Shunt Resistors ROHS | ok
Shunt | 1mΩ 2512 | RLP25FEGR001 | TA-I Tech | C459678 | 2512 | Extended | 27351 | 0.0888 | 0.0888 | 0.0715 | 27350 | 0.0894 | 0.0721 | 1mΩ 3W Current Sense Resistor SMD ±1% ±50ppm/℃ 2512 Current Sense Resistors / Shunt Resistors ROHS | ok
Shunt | 1mΩ 2512 | YLR12-3-1F-W | Shenzhen Yezhan Elec. | C489551 | 2512 | Extended | 23959 | 0.1147 | 0.1147 | 0.0913 | 23865 | 0.1145 | 0.0911 | 1mΩ 3W Current Sense Resistor SMD ±1% ±50ppm/℃ 2512 Current Sense Resistors / Shunt Resistors ROHS | ok
Shunt | 2mΩ 2512 | ASR-K-3-2F | Shenzhen Yezhan Elec. | C695817 | 2512 | Extended | 85820 | 0.3069 | 0.3069 | 0.2453 | 85475 | 0.3088 | 0.2469 | 2mΩ 5W SMD Shunt ±1% ±50ppm/℃ 2512 Current Sense Resistors / Shunt Resistors ROHS | ok
Shunt | 2mΩ 2512 | RLP25FEGR002 | TA-I Tech | C459679 | 2512 | Extended | 49666 | 0.0732 | 0.0732 | 0.059 | 48360 | 0.0736 | 0.0594 | 2mΩ 3W Current Sense Resistor SMD ±1% ±50ppm/℃ 2512 Current Sense Resistors / Shunt Resistors ROHS | ok
Shunt | 2mΩ 2512 | ASR-F-3-2F | Shenzhen Yezhan Elec. | C469428 | 2512 | Extended | 40747 | 0.3098 | 0.3098 | 0.2525 | 40445 | 0.3118 | 0.254 | 2mΩ 5W SMD Shunt ±1% ±50ppm/℃ 2512 Current Sense Resistors / Shunt Resistors ROHS | ok
Shunt | 2mΩ 2512 | WSL25122L000FEA18 | Vishay Intertech | C844691 | 2512 | Extended | 28300 | 0.1843 | 0.1442 | 0.1058 | 28300 | 0.1451 | 0.1063 | -65℃~+170℃ 2W 2mΩ ±1% ±275ppm/℃ 2512 Chip Resistor - Surface Mount ROHS | ok
Shunt | 1mΩ 2010 | WSLP20101L000FEA | Vishay Intertech | C2090277 | 2010 | Extended | 8745 | 1.1988 | 0.9968 | 0.759 | 8745 | 1.0048 | 0.7651 | 1mΩ 2W Current Sense Resistor SMD ±1% ±275ppm/℃ 2010 Current Sense Resistors / Shunt Resistors ROHS | ok
Shunt | 1mΩ 2010 | WSL20101L000FEA18 | Vishay Intertech | C844486 | 2010 | Extended | 5251 | 0.6597 | 0.5343 | 0.4089 | 5232 | 0.5388 | 0.4123 | -65℃~+170℃ 1W 1mΩ ±1% ±275ppm/℃ 2010 Current Sense Resistors / Shunt Resistors ROHS | ok
Shunt | 1mΩ 2010 | SL1206400 | TECHFUSE | C70173 | 1206 | Extended | 2072 | 0.1128 | 0.1128 | 0.0908 | 2060 | 0.1139 | 0.0915 | 1.5W 16mΩ 16s 1mΩ 4A 50A 6V 8A 1206 Resettable Fuses ROHS | ok
Shunt | 0.5mΩ 2512 | RLM25FEGMR50M | TA-I Tech | C710260 | 2512 | Extended | 202444 | 0.0724 | 0.0724 | 0.0582 | 202440 | 0.0728 | 0.0586 | 0.5mΩ 3W Current Sense Resistor SMD ±1% ±75ppm/℃ 2512 Current Sense Resistors / Shunt Resistors ROHS | ok
Shunt | 0.5mΩ 2512 | LRAM25GJER0005S | NCT | C5121029 | 2512 | Extended | 66581 | 0.0294 | 0.0294 | 0.0294 |  |  |  | 0.5mΩ 3W Current Sense Resistor Surface Mount ±5% 2512 Current Sense Resistors / Shunt Resistors ROHS | ok
Shunt | 0.5mΩ 2512 | HoYLR2512E-3W-0.5mR-1% | Milliohm | C5375456 | 2512 | Extended | 44994 | 0.0611 | 0.0611 | 0.0491 | 44990 | 0.0616 | 0.0495 | 0.5mΩ 3W Current Sense Resistor SMD ±1% 2512 Current Sense Resistors / Shunt Resistors ROHS | ok
Current amp | INA240A1PWR | INA240A1PWR | Texas Instruments | C93965 | TSSOP-8 | Extended | 565 | 2.4871 | 2.2656 | 1.9659 | 0 | 2.2878 | 1.9852 | -40℃~+125℃ -4V~80V 1 1.8mA 132dB 2.7V~5.5V 20V/V 250nV/℃ 2V/us 400kHz 40nV/√Hz@1kHz 5uV 90uA Bidirectional detection、Zero drift / auto-zero、Programmable output | ok
Current amp | INA240A1PWR | INA240A1PWR(I240A1) | JLCPCB Assembly | C9900292367 | TSSOP-8 | Extended | 0 | 0.0396 | 0.0396 | 0.0204 |  |  |  | TSSOP-8 SMT ROHS | ok
Current amp | INA240A2PWR | INA240A2PWR | Texas Instruments | C129949 | TSSOP-8 | Extended | 9082 | 2.2362 | 1.8926 | 1.3795 | 8587 | 1.9097 | 1.392 | -40℃~+125℃ -4V~80V 1 1.8mA 132dB 2.7V~5.5V 250nV/℃ 2V/us 400kHz 40nV/√Hz@1kHz 50V/V 5uV 90uA Bidirectional detection、Zero drift / auto-zero、Programmable output | ok
Current amp | INA181A1IDBVR | INA181A1IDBVR | Texas Instruments | C2058943 | SOT-23-6 | Extended | 4779 | 0.3377 | 0.3377 | 0.2706 | 3195 | 0.341 | 0.2731 | -200mV~26V -40℃~+125℃ 1 100dB 195uA 1uV/℃ 2.7V~5.5V 20V/V 25uV 2V/us 350kHz 40nV/√Hz@1kHz 6uA 8mA High-side detection、Low-side detection、Bidirectional detection | ok
Current amp | INA181A1IDBVR | INA181A1IDBVR(LX) | lingxingic | C52097916 | SOT-23-6 | Extended | 2278 | 0.1522 | 0.1522 | 0.1212 | 2275 | 0.1534 | 0.1223 | -200mV~30V -40℃~+125℃ 0.2uV/℃ 1 100dB 175uA 2.7V~5.5V 20V/V 25uV 2V/us 350kHz 6uA Bidirectional detection、Zero drift / auto-zero ±30V SOT-23-6 Current Sense Amp | ok
Current amp | INA181A1IDBVR | INA181A1IDBVR(XBLW) | XBLW | C45351496 | SOT-23-6 | Extended | 5460 | 0.2022 | 0.2022 | 0.1611 | 4910 | 0.2038 | 0.1624 | -200mV~30V -40℃~+125℃ 1 100dB 175uA 1uV/℃ 2.7V~5.5V 20V/V 25uV 2V/us 350kHz 40nV/√Hz@1kHz 75uA 8mA Bidirectional detection、Zero drift / auto-zero ±30V SOT-23-6 | ok
Current amp | INA181A2IDBVR | INA181A2IDBVR | Texas Instruments | C2058784 | SOT-23-6 | Extended | 21061 | 0.3354 | 0.3354 | 0.2676 | 21060 | 0.3383 | 0.27 | -200mV~26V -40℃~+125℃ 1 100dB 195uA 1uV/℃ 2.7V~5.5V 210kHz 25uV 2V/us 40nV/√Hz@1kHz 50V/V 6uA 8mA Bidirectional detection、Programmable output reference level、An | ok
Current amp | INA181A2IDBVR | INA181A2IDBVR(LX) | lingxingic | C53198613 | SOT-23-6 | Extended | 2812 | 0.1502 | 0.1502 | 0.1194 | 2810 | 0.1512 | 0.1201 | -200mV~3V -40℃~+125℃ 0.2uV/℃ 1 100dB 175uA 2.7V~5.5V 210kHz 25uV 4V/us 50V/V 6uA Bidirectional detection、Zero drift / auto-zero ±30V SOT-23-6 Current Sense Ampl | ok
Current amp | INA186A1IDCKR | INA186A1IDCKR | Texas Instruments | C2058311 | SC-70-6 | Extended | 4388 | 0.7036 | 0.5962 | 0.4561 | 4388 | 0.5999 | 0.4589 | -200mV~40V -40℃~+125℃ 0.3V/us 0.5uV/℃ 1 1.7V~5.5V 150dB 25V/V 45kHz 48uA 500pA 50uV 75nV/√Hz High-side detection、Low-side detection、Bidirectional detection、Zero | ok
Current amp | TP181A1 | TP181A1-CR | 3PEAK | C2902349 | SC70-6 | Extended | 9550 | 0.3163 | 0.3163 | 0.2432 | 9550 | 0.3182 | 0.2447 | -300mV~36V -40℃~+125℃ 0.5uV/℃ 0.6V/us 1 10uV 120dB 120uA 2.7V~30V 35mA 48kHz 50V/V Bidirectional detection、Zero drift / auto-zero SC70-6 Current Sense Amplifier | ok
Current amp | TP181A1 | TP181A1-CR | JLCPCB Assembly | C9900001365 | SOT-363 | Extended | 0 | 0.0007 | 0.0007 | 0.0007 |  |  |  | SOT-363-6_L2.1-W1.3-P0.65-LS2.3 SMT ROHS | ok
Current amp | INA199A1DCKR | INA199A1DCKR | Texas Instruments | C59135 | SOT-363(SC-70-6) | Extended | 98868 | 0.4121 | 0.3258 | 0.2444 | 97343 | 0.3292 | 0.2469 | -300mV~26V -40℃~+105℃ 0.4V/us 0.5uV/℃ 1 120dB 14kHz 2.7V~26V 25nV/√Hz@1kHz 28uA 50V/V 5uV 65uA High-side detection、Low-side detection、Bidirectional detection、Ze | ok
Current amp | INA199A1DCKR | INA199A1DCKR(XBLW) | XBLW | C55807349 | SC-70-6 | Extended | 2515 | 0.1994 | 0.1994 | 0.158 | 2515 | 0.2011 | 0.1593 | SC-70-6 Current Sense Amplifiers ROHS | ok
Encoder | MT6835GT-STD | MT6835GT-STD-R | NOVOSENSE | C2932578 | TSSOP-16 | Extended | 1462 | 4.8829 | 4.2884 | 3.5408 | 0 | 4.315 | 3.5628 | -40℃~+125℃ 0°~360° 1.2mm 22mA 3V~5.5V 4.4mm 5mm Magnetic rotary position sensor No SPI Zero position programming、Fault diagnosis、Angle nonlinearity compensation | ok
Encoder | MT6835GT-STD | MT6835GT-STD16384 | JLCPCB Assembly | C9900184884 | TSSOP-16 | Extended | 0 | 0.0396 | 0.0396 | 0.0204 |  |  |  | TSSOP-16 SMT ROHS | ok
Encoder | MT6835 | MT6835 | NOVOSENSE | C49423563 | TSSOP-16 | Extended | 0 | 12.4595 | 12.4595 | 12.4595 |  |  |  | TSSOP-16 SMT ROHS | ok
Encoder | MT6835 | MT6835GT | JLCPCB Assembly | C9900201040 | SMD-8_L7.3-W7.3-P1.27-LS10.3 | Extended | 0 | 0.0396 | 0.0396 | 0.0204 |  |  |  | SMD-8_L7.3-W7.3-P1.27-LS10.3 SMT ROHS | ok
Encoder | MT6835 | MT6835GT1 | JLCPCB Assembly | C9900201053 | SMD-8_L7.4-W7.3-P1.27-LS10.2 | Extended | 0 | 0.0396 | 0.0396 | 0.0204 |  |  |  | SMD-8_L7.4-W7.3-P1.27-LS10.2 SMT ROHS | ok
Encoder | MT6835 | MT6835-STD | JLCPCB Assembly | C9900195323 | TSSOP-16 | Extended | 0 | 0.0396 | 0.0396 | 0.0204 |  |  |  | TSSOP-16 SMT ROHS | ok
Encoder | MT6835 | MT6835-AGD | JLCPCB Assembly | C9900240868 | SSOP-16-150mil | Extended | 0 | 0.0396 | 0.0396 | 0.0204 |  |  |  | SSOP-16-150mil SMT ROHS | ok
Encoder | MT6835 | MT6835GT-M5H | JLCPCB Assembly | C9900193967 | TSSOP-16 | Extended | 0 | 0.0396 | 0.0396 | 0.0204 |  |  |  | TSSOP-16 SMT ROHS | ok
Encoder | MT6835 | MT6835GT-STD-R | NOVOSENSE | C2932578 | TSSOP-16 | Extended | 1462 | 4.8829 | 4.2884 | 3.5408 | 0 | 4.315 | 3.5628 | -40℃~+125℃ 0°~360° 1.2mm 22mA 3V~5.5V 4.4mm 5mm Magnetic rotary position sensor No SPI Zero position programming、Fault diagnosis、Angle nonlinearity compensation | ok
Encoder | MT6835 | MT6835GT-A10K | NOVOSENSE | C2984637 | TSSOP-16 | Extended | 0 | 7.062 | 6.0474 | 5.6646 | 0 | 5.8798 | 5.5077 | -40℃~+125℃ 120000rpm 16 16384 21bit 22mA 30mT 3V~5.5V Incremental encoder output、Magnetic field too high/low warning、Programmable hysteresis、Under-voltage locko | ok
Encoder | MT6835 | MT6835SGT-STD | JLCPCB Assembly | C9900192411 | TSSOP-16_L5.0-W4.4-P0.65-LS6.4-BL | Extended | 0 | 0.0396 | 0.0396 | 0.0204 |  |  |  | TSSOP-16_L5.0-W4.4-P0.65-LS6.4-BL SMT ROHS | ok
Encoder | MT6835 | MT6835GT_TSSOP16 | JLCPCB Assembly | C9900169778 | TSSOP-16_L5.0-W4.4-P0.65-LS6.4-BL | Extended | 0 | 0.0396 | 0.0396 | 0.0204 |  |  |  | TSSOP-16_L5.0-W4.4-P0.65-LS6.4-BL SMT ROHS | ok
Encoder | MT6835 | MT6835GT-STD16384 | JLCPCB Assembly | C9900184884 | TSSOP-16 | Extended | 0 | 0.0396 | 0.0396 | 0.0204 |  |  |  | TSSOP-16 SMT ROHS | ok
Encoder | MT6835 | MT6835SSOP-16_150mi | JLCPCB Assembly | C9900038417 | lLC-SSOP-16_150mil | Extended | 0 | 0.0396 | 0.0396 | 0.0204 |  |  |  | lLC-SSOP-16_150mil New Arrivals ROHS | ok
Encoder | MT6826S | MT6826S | NOVOSENSE | C27636638 | TSSOP-16 | Extended | 0 | 0.0396 | 0.0396 | 0.0204 |  |  |  | SSOP-16 New Arrivals ROHS | ok
Encoder | MT6826S | MT6826S | JLCPCB Assembly | C9900148410 | TSSOP-16 | Extended | 0 | 0.0396 | 0.0396 | 0.0204 |  |  |  | TSSOP-16 New Arrivals ROHS | ok
Encoder | MT6826S | MT6826SJT | JLCPCB Assembly | C9900177104 | QFN24-4X4-0.5 | Extended | 0 | 0.0396 | 0.0396 | 0.0204 |  |  |  | QFN24-4X4-0.5 SMT ROHS | ok
Encoder | MT6826S | MT6826SJT-ACD | NOVOSENSE | C49257135 | QFN-24(4x4) | Extended | 1000 | 3.9643 | 3.3389 | 2.5897 | 0 | 3.3664 | 2.611 | -40℃~+125℃ 120000rpm 15bit 16 22mA 30mT 3V~5.5V 4096 Incremental encoder output、Magnetic field too high/low warning、Programmable hysteresis、Under-voltage lockou | ok
Encoder | MT6826S | MT6826SJT-STD | NOVOSENSE | C49296998 | QFN-24_4x4mm | Extended | 0 | 0.0396 | 0.0396 | 0.0204 |  |  |  | QFN-24_4x4mm SMT ROHS | ok
Encoder | MT6826S | MT6826SGT-STD-R | NOVOSENSE | C27636731 | TSSOP-16 | Extended | 4822 | 3.8405 | 3.2004 | 2.391 | 4822 | 3.1982 | 2.3893 | -40℃~+125℃ 120000rpm 15bit 16 22mA 30mT 3V~5.5V 4096 Incremental encoder output、Magnetic field too high/low warning、Programmable hysteresis、Under-voltage lockou | ok
Encoder | MT6826S | MT6826SGT-ACD-R | NOVOSENSE | C41381890 | TSSOP-16 | Extended | 0 | 3.8405 | 3.2004 | 2.391 | 0 | 3.2305 | 2.4134 | -40℃~+125℃ 120000rpm 15bit 16 22mA 30mT 3V~5.5V 4096 Incremental encoder output、Magnetic field too high/low warning、Programmable hysteresis、Under-voltage lockou | ok
Encoder | MT6826S | MT6826SGT-STD-R | NOVOSENSE | C41410105 | TSSOP-16 | Extended | 0 | 0.0396 | 0.0396 | 0.0204 |  |  |  | TSSOP-16 New Arrivals ROHS | ok
Encoder | MT6826S | MT6826SGT-AKD-R | NOVOSENSE | C49257134 | TSSOP-16 | Extended | 0 | 3.8405 | 3.2004 | 2.391 | 0 | 3.1919 | 2.3846 | -40℃~+125℃ 120000rpm 15bit 16 22mA 30mT 3V~5.5V 4096 Incremental encoder output、Magnetic field too high/low warning、Programmable hysteresis、Under-voltage lockou | ok
Encoder | MT6701QT-STD | MT6701QT-STD | NOVOSENSE | C2913974 | QFN-16-EP(3x3) | Extended | 1700 | 1.9007 | 1.6678 | 1.3535 | 0 | 1.6818 | 1.3648 | -40℃~+125℃ 0.75mm 0°~360° 10mA 3.3V~5V 3mm 3mm I2C Magnetic rotary position sensor No Programmable transmission、Zero position programming QFN-16-EP(3x3) Positio | ok
Encoder | MT6701QT-STD | MT6701QT-STD | NOVOSENSE | C2837232 | QFN-16-EP_3x3 | Extended | 0 | 2.9317 | 2.9317 | 2.9317 |  |  |  | QFN-16-EP(3x3) Position Sensors ROHS | ok
Encoder | MT6701 | MT6701QT-STD | NOVOSENSE | C2913974 | QFN-16-EP(3x3) | Extended | 1700 | 1.9007 | 1.6678 | 1.3535 | 0 | 1.6818 | 1.3648 | -40℃~+125℃ 0.75mm 0°~360° 10mA 3.3V~5V 3mm 3mm I2C Magnetic rotary position sensor No Programmable transmission、Zero position programming QFN-16-EP(3x3) Positio | ok
Encoder | MT6701 | MT6701CT-STD-R | NOVOSENSE | C3003196 | SOP-8 | Extended | 4442 | 1.7248 | 1.5603 | 1.2883 | 4442 | 1.1543 | 0.8873 | -40℃~+125℃ 0°~360° 1.75mm 10mA 3.3V~5V 3.9mm 5mm I2C、SSI Magnetic rotary position sensor No Programmable transmission、Zero position programming、Fault diagnosis | ok
Encoder | MT6701 | MT6701CT-ACD-R | NOVOSENSE | C3202694 | SOP-8 | Extended | 4319 | 1.9219 | 1.6011 | 1.1955 | 4319 | 1.611 | 1.2029 | -40℃~+125℃ 0°~360° 1.75mm 10mA 3.3V~5V 3.9mm 5mm I2C、SSI Magnetic rotary position sensor No Programmable transmission、Zero position programming、Multi-axis magne | ok
Encoder | MT6701 | MT6701CT-STD | NOVOSENSE | C5451785 | SOP-8 | Extended | 1244 | 2.0457 | 1.6629 | 1.2167 | 1244 | 1.6602 | 1.2147 | -40℃~+125℃ 0°~360° 1.75mm 10mA 3.3V~5V 3.9mm 5mm I2C、SSI Magnetic rotary position sensor No Programmable transmission、Zero position programming、Multi-axis magne | ok
Encoder | MT6701 | MT6701CT-AKD-R | NOVOSENSE | C19711153 | SOP-8 | Extended | 1517 | 1.9219 | 1.6011 | 1.1955 | 1517 | 1.611 | 1.2029 | -40℃~+125℃ 0°~360° 1.75mm 10mA 3.3V~5V 3.9mm 5mm I2C Magnetic rotary position sensor No Programmable transmission、Zero position programming、Fault diagnosis、Mult | ok
Encoder | MT6701 | MT6701QT-STD | NOVOSENSE | C2837232 | QFN-16-EP_3x3 | Extended | 0 | 2.9317 | 2.9317 | 2.9317 |  |  |  | QFN-16-EP(3x3) Position Sensors ROHS | ok
Encoder | MT6701 | MT6701CT-STD | NOVOSENSE | C2856764 | SOP-8 | Extended | 0 | 2.0457 | 1.6629 | 1.2167 | 0 | 1.6602 | 1.2147 | -40℃~+125℃ 0°~360° 1.75mm 10mA 3.3V~5V 3.9mm 5mm I2C、SSI Magnetic rotary position sensor No Programmable transmission、Zero position programming、Fault diagnosis | ok
Encoder | MT6701 | MT6701 | JLCPCB Assembly | C9900006644 | SOIC-8_L4.9-W3.9-P1.27-LS6.0-BL | Extended | 0 | 0.0007 | 0.0007 | 0.0007 |  |  |  | SOIC-8_L4.9-W3.9-P1.27-LS6.0-BL SMT ROHS | ok
Encoder | MT6701 | MT6701CT64 | JLCPCB Assembly | C9900078366 | SOP8 | Extended | 0 | 0.0396 | 0.0396 | 0.0204 |  |  |  | SOP8 New Arrivals ROHS | ok
Encoder | MT6701 | MT6701QT-ACD | NOVOSENSE | C49257133 | QFN-16(3x3) | Extended | 1086 | 2.0164 | 1.6809 | 1.2558 | 30 | 1.6939 | 1.2655 | -40℃~+125℃ 10mA 12bit 16 3.3V~5V 55000rpm Incremental encoder output、Magnetic field too high/low warning、Programmable hysteresis PWM、ABZ、SSI QFN-16(3x3) Magneti | ok
Encoder | MT6701 | MT6701CT-ACD | NOVOSENSE | C50203010 | SOP-8 | Extended | 648 | 2.0457 | 1.6629 | 1.2167 | 648 | 1.6733 | 1.2242 | Programmable transmission、Zero position programming、Fault diagnosis、Multi-axis magnetic field detection SOP-8 Position Sensors ROHS | ok
Encoder | MT6701 | MT6701CT-AKD | JLCPCB Assembly | C9900092345 | SOP-8 | Extended | 0 | 0.0396 | 0.0396 | 0.0204 |  |  |  | SOP-8 New Arrivals ROHS | ok
Encoder | MT6701 | MT6701QT-ACD | JLCPCB Assembly | C9900182119 | QFN16 | Extended | 0 | 0.0396 | 0.0396 | 0.0204 |  |  |  | QFN16 SMT ROHS | ok
Encoder | MT6701 | MT6701CT-1000 | NOVOSENSE | C5355654 | sop-8 | Extended | 0 | 0.0396 | 0.0396 | 0.0204 |  |  |  | sop-8 New Arrivals ROHS | ok
Encoder | MT6701 | MT6701QCT-ACD | JLCPCB Assembly | C9900077491 | SOP8-50-150 | Extended | 0 | 0.0396 | 0.0396 | 0.0204 |  |  |  | SOP8-50-150 New Arrivals ROHS | ok
Encoder | MT6701 | MT6701CT-ACD-R | JLCPCB Assembly | C9900201641 | SOP-8-150mil | Extended | 0 | 0.0396 | 0.0396 | 0.0204 |  |  |  | SOP-8-150mil SMT ROHS | ok
Encoder | MT6701 | MT6701CT-P500-R | JLCPCB Assembly | C9900211864 | SOP-8-150MIL | Extended | 0 | 0.0396 | 0.0396 | 0.0204 |  |  |  | SOP-8-150MIL SMT ROHS | ok
Encoder | MT6701 | MT6701QT_PWM_OUT | JLCPCB Assembly | C9900139017 | QFN16 | Extended | 0 | 0.0396 | 0.0396 | 0.0204 |  |  |  | QFN16 New Arrivals ROHS | ok
Encoder | MT6701 | Mt6701QT-ACDABZ(1024) | JLCPCB Assembly | C9900163672 | QFN-16_3x3mm | Extended | 0 | 0.0396 | 0.0396 | 0.0204 |  |  |  | QFN-16_3x3mm SMT ROHS | ok
Encoder | MT6816CT-ACD | MT6816CT-ACD | NOVOSENSE | C879560 | SOP-8 | Extended | 0 | 3.2004 | 2.6678 | 1.9919 |  |  |  | -40℃~+125℃ 0°~360° 1.75mm 10mA 3.9mm 3V~5V 5mm Magnetic rotary position sensor No Programmable transmission、Zero position programming、Fault diagnosis、Multi-axis | ok
Encoder | MT6816CT-ACD | MT6816CT-ACD-R | NOVOSENSE | C2991082 | SOP-8 | Extended | 0 | 3.2004 | 2.6678 | 1.9919 | 0 | 2.6844 | 2.0043 | -40℃~+125℃ 0°~360° 1.75mm 10mA 3.9mm 3V~5.5V 5mm Magnetic rotary position sensor No Programmable transmission、Zero position programming、Fault diagnosis、Multi-ax | ok
Encoder | MT6816CT-ACD | MT6816CT-ACD | NOVOSENSE | C5449395 | SOP-8 | Extended | 0 | 3.2004 | 2.6678 | 1.9919 |  |  |  | -40℃~+125℃ 0°~360° 1.75mm 10mA 3.9mm 3V~5.5V 5mm Magnetic rotary position sensor No Programmable transmission、Zero position programming、Fault diagnosis、Multi-ax | ok
Encoder | MT6816CT-ACD | MT6816CT-ACD-Y | JLCPCB Assembly | C9900256757 | SOP-8-150mil | Extended | 0 | 0.0396 | 0.0396 | 0.0204 |  |  |  | SOP-8-150mil SMT ROHS | ok
Encoder | AS5047P-ATST | AS5047P-ATST | AMS | C55112284 | TSSOP-14 | Extended | 44 | 4.3894 | 3.777 | 3.0473 | 44 | 3.8004 | 3.0663 | TSSOP-14 Position Sensors ROHS | ok
Encoder | AS5047U | AS5047U-HTSM | AMS | C2153630 | SSOP-14-4.4mm | Extended | 288 | 6.2982 | 5.3829 | 4.36 | 288 | 5.4163 | 4.3871 | -40℃~+150℃ 0°~360° 1.2mm 16mA 4.4mm 4.5V~5.5V 5mm Magnetic rotary position sensor No SPI SSOP-14-4.4mm Position Sensors ROHS | ok
Encoder | AS5047U | AS5047U-HTST | AMS | C2153660 | TSSOP-14 | Extended | 0 | 6.5718 | 6.5718 | 6.5718 | 0 | 6.2292 | 6.2292 | 0°~360° 3V~3.6V、4.5V~5.5V Programmable transmission、Zero position programming、Fault diagnosis、Angle nonlinearity compensation、Signal filtering processing、Automa | ok
Encoder | AS5048A-HTSP | AS5048A-HTSP | Advanced Monolithic Systems | C2153638 | TSSOP-14 | Extended | 0 | 6.3471 | 6.3471 | 6.3471 |  |  |  | 0°~360° 3V~3.6V、4.5V~5.5V TSSOP-14 Position Sensors ROHS | ok
Encoder | AS5048A-HTSP | AS5048A-HTSP | AMS | C55240175 | TSSOP-14 | Extended | 0 | 4.9838 | 4.2509 | 3.3747 | 0 | 4.2913 | 3.4068 | TSSOP-14 Position Sensors ROHS | ok
Encoder | AS5048A-HTSP | AS5048A-HTSP-500 | AMS | C2655181 | TSSOP-14 | Extended | 104 | 6.6891 | 5.8242 | 4.7917 | 104 | 5.8706 | 4.8298 | -40℃~+150℃ 0°~360° 1.2mm 15mA 3V~3.6V、4.5V~5.5V 4.4mm 5mm Magnetic rotary position sensor No SPI TSSOP-14 Position Sensors ROHS | ok
Encoder | AS5600-ASOM | AS5600-ASOM | AMS | C79815 | SOIC-8 | Extended | 2 | 1.5392 | 1.3714 | 1.0945 | 0 | 1.3844 | 1.1049 | -40℃~+125℃ 0°~360° 1.75mm 3.3V、5V 3.9mm 4.9mm 6.5mA Magnetic rotary position sensor No PWM、I2C SOIC-8 Position Sensors ROHS | ok
Encoder | MA600GQ | MA600GQ-Z | Monolithic Power Systems | C7434430 | QFN-16 (3mmx3mm) | Extended | 0 | 0.0396 | 0.0396 | 0.0204 |  |  |  | QFN-16(3mmx3mm) New Arrivals ROHS | ok
Encoder | MA600GQ | MA600GQE-0000 | Monolithic Power Systems | C19630843 | QFN16_3X3 | Extended | 0 | 0.0396 | 0.0396 | 0.0204 |  |  |  | QFN16_3X3 New Arrivals ROHS | ok
Encoder | MA600GQ | MA600GQE-0000-Z | Monolithic Power Systems | C18221548 | QFN-16-EP(3x3) | Extended | 702 | 6.9757 | 6.1435 | 5.2119 |  |  |  | -40℃~+125℃ 10mT 12bit、15bit 3V~3.6V 4096 7.5mA 8 Incremental encoder output、Programmable hysteresis、Under-voltage lockout PWM、SPI、ABZ、SSI QFN-16-EP(3x3) Magneti | ok
Encoder | MA600GQ | MA600GQE-0000-P | Monolithic Power Systems | C29550865 | - | Extended | 0 | 2.2395 | 2.2395 | 2.2395 |  |  |  | - Lack of specifications ROHS | ok
Encoder | MA600GQ | MA600GQE-0010-Z | JLCPCB Assembly | C9900268165 | QFN-16(3x3) | Extended | 0 | 0.0396 | 0.0396 | 0.0204 |  |  |  | QFN-16(3x3) SMT ROHS | ok
Encoder | MA600AGQ | MA600AGQE-0000-Z | Monolithic Power Systems | C49240579 | QFN-16(3x3) | Extended | 1161 | 5.3438 | 4.7786 | 4.1076 |  |  |  | Incremental encoder output、Programmable hysteresis、Under-voltage lockout QFN-16(3x3) Magnetic Angle Sensors ROHS | ok
Encoder | MA732GQ-Z | MA732GQ-Z | Monolithic Power Systems | C3824836 | QFN-16(3x3) | Extended | 559 | 4.7728 | 4.7728 | 4.1811 |  |  |  | -40℃~+125℃ 11.7mA 3V~3.6V 3mm 3mm Magnetic position sensor No SPI、SSI 可编程传输、零位编程、故障诊断、多轴磁场检测、信号滤波处理 QFN-16(3x3) Position Sensors ROHS | ok
Encoder | MA782GGU | MA782GGU-Z | Monolithic Power Systems | C3825406 | QFN-14(2x2) | Extended | 1 | 4.1167 | 4.1167 | 3.5893 |  |  |  | -40℃~+125℃ 10mA 2mm 2mm 3V~3.6V Magnetic rotary position sensor No SPI QFN-14(2x2) Position Sensors ROHS | ok
Encoder | MA782GGU | MA782GGU-P | Monolithic Power Systems | C3824660 | QFN-14(2x2) | Extended | 0 | 1.3665 | 1.1336 | 0.86 |  |  |  | -40℃~+125℃ 2mm 2mm 3V~3.6V Programmable transmission、Zero position programming、Multi-axis magnetic field detection、Signal filtering processing SPI QFN-14(2x2) P | ok
Encoder | TLE5012BE1000 | TLE5012BE1000 | Infineon Technologies | C123083 | SO-8 | Extended | 11599 | 4.075 | 3.6369 | 2.6792 | 11223 | 3.666 | 2.7006 | -40℃~+150℃ 14mA 15bit 30mT 3V~5.5V Incremental encoder output、Under-voltage lockout、Overvoltage lockout、Built-in self-test (BIST)、Angle prediction function、Inte | ok
Encoder | TLE5012BE1000 | TLE5012BE1000XUMA1 | Infineon Technologies | C83591 | SOIC-8 | Extended | 140 | 5.2558 | 4.5262 | 3.6548 | 64 | 4.5706 | 3.6907 | -40℃~+150℃ 14mA 15bit 30mT 3V~5.5V PWM SOIC-8 Magnetic Angle Sensors ROHS | ok
Encoder | TLE5012BE1000 | TLE5012BE1000FUMA1 | Infineon Technologies | C3824854 | SO-8 | Extended | 0 | 3.9089 | 3.9089 | 3.9089 |  |  |  | 0°~360° 3V~5.5V SO-8 Position Sensors ROHS | ok
Encoder | TLE5012BE1000 | TLE5012BE1000XUMA1 | JLCPCB Assembly | C9900068707 | SO-8 | Extended | 0 | 0.0396 | 0.0396 | 0.0204 |  |  |  | SO-8 New Arrivals ROHS | ok
Encoder | TLE5012BE1000 | TLE5012BE1000MS2GOTOBO1 | Infineon Technologies | C17455067 | - | Extended | 0 | 79.024 | 79.024 | 79.024 | 0 | 73.4919 | 73.4919 | - Specialized Sensors ROHS | ok
CAN-FD | MCP2562FDT-E/SN | MCP2562FDT-E/SN | Microchip Tech | C511335 | SOIC-8 | Extended | 5333 | 1.689 | 1.4398 | 1.1238 | 5333 | 1.4488 | 1.1308 | -40℃~+125℃ 1 15uA 4.5V~5.5V 45mA 8Mbps CAN FD Transceiver SOIC-8 CAN Transceivers ROHS | ok
CAN-FD | MCP2562FDT-E/MF | MCP2562FDT-E/MF | Microchip Tech | C623222 | DFN-8(3x3) | Extended | 1139 | 6.4415 | 5.6353 | 4.3047 | 1066 | 5.6762 | 4.3359 | -40℃~+125℃ 1 15uA 4.5V~5.5V 45mA 8Mbps CAN FD Transceiver Low-power mode、Wake-up function、TXD dominant timeout、ESD protection、Undervoltage Protection、Thermal sh | ok
CAN-FD | MCP2562FD-E/SN | MCP2562FD-E/SN | Microchip Tech | C124016 | SOIC-8 | Extended | 1690 | 2.1255 | 1.803 | 1.3926 | 1690 | 1.8179 | 1.4041 | -40℃~+125℃ 1 15uA 4.5V~5.5V 45mA 8Mbps CAN FD Transceiver SOIC-8 CAN Transceivers ROHS | ok
CAN-FD | TCAN1042VDRQ1 | TCAN1042VDRQ1 | Texas Instruments | C485806 | SOIC-8 | Extended | 926 | 0.7102 | 0.575 | 0.4398 | 926 | 0.5806 | 0.4441 | -55℃~+125℃ 4.5V~5.5V 5Mbps 5uA 80mA CAN FD Transceiver SOIC-8 CAN Transceivers ROHS | ok
CAN-FD | TCAN1042HGVDRBRQ1 | TCAN1042HGVDRBRQ1 | Texas Instruments | C2671243 | HVSON-8-EP(3x3) | Extended | 0 | 3.9398 | 3.3421 | 2.6271 | 0 | 3.3704 | 2.6493 | -55℃~+150℃ 4.5V~5.5V 5Mbps 5uA 70mA CAN Transceiver HVSON-8-EP(3x3) CAN Transceivers ROHS | ok
CAN-FD | TCAN1462VDRQ1 | TCAN1462VDRQ1 | Texas Instruments | C7399456 | SOIC-8 | Extended | 0 | 0.9675 | 0.9463 | 0.9186 | 0 | 0.9015 | 0.8752 | -40℃~+150℃ 1 21uA 4.5V~5.5V 45mA 8Mbps CAN FD Transceiver Low-power mode、Wake-up function、TXD dominant timeout、ESD protection、Undervoltage Protection、Thermal sh | ok
CAN-FD | TJA1051T/3 | TJA1051T/3/1J | NXP Semicon | C38695 | SOIC-8-150mil | Extended | 278027 | 0.5766 | 0.4821 | 0.3616 | 272920 | 0.4867 | 0.3651 | -40℃~+150℃ 110mA 4.5V~5.5V 5Mbps CAN FD Transceiver SOIC-8-150mil CAN Transceivers ROHS | ok
CAN-FD | TJA1051T/3 | TJA1051T/3,118 | NXP Semicon | C58988 | SOIC-8 | Extended | 6465 | 0.8665 | 0.7916 | 0.715 | 6465 | 0.7996 | 0.7223 | -40℃~+150℃ 2.5mA 4.5V~5.5V 5Mbps 70mA CAN FD Transceiver SOIC-8 CAN Transceivers ROHS | ok
CAN-FD | TJA1051T/3 | TJA1051T/3/2Z | NXP Semicon | C1850231 | SO-8 | Extended | 1177 | 1.2362 | 1.0131 | 0.7525 | 1177 | 1.0194 | 0.7572 | -40℃~+150℃ 1 2.5mA 4.5V~5.5V 5Mbps 70mA CAN FD Transceiver SO-8 CAN Transceivers ROHS | ok
CAN-FD | TJA1051T/3 | TJA1051T/3/CM,118 | NXP Semicon | C2671195 | SOIC-8 | Extended | 137 | 0.8193 | 0.7981 | 0.7704 | 137 | 0.8049 | 0.7769 | -40℃~+150℃ 2.5mA 4.5V~5.5V 5Mbps 70mA CAN Transceiver SOIC-8 CAN Transceivers ROHS | ok
CAN-FD | TJA1051T/3 | TJA1051T/3 | Tokmas | C5342108 | SOP-8 | Extended | 17802 | 0.5701 | 0.4626 | 0.36 | 11424 | 0.4664 | 0.363 | -40℃~+150℃ 2.5mA 4.5V~5.5V 5Mbps 70mA SOP-8 CAN Transceivers ROHS | ok
CAN-FD | TJA1051T/3 | TJA1051T/3/2 | NXP Semicon | C5331912 | SOIC-8 | Extended | 0 | 2.2102 | 1.8665 | 1.4317 |  |  |  | 4.5V~5.5V CAN Transceiver SOIC-8 CAN Transceivers ROHS | ok
CAN-FD | TJA1051T/3 | TJA1051T/3/1 | NXP Semicon | C32100239 | - | Extended | 0 | 0.676 | 0.5489 | 0.4219 | 0 | 0.5527 | 0.4248 | - CAN Transceivers ROHS | ok
CAN-FD | TJA1051T/3 | TJA1051T/3-YC | YLPTEC | C54450746 | SOP-8 | Extended | 1514 | 0.4952 | 0.3926 | 0.2932 | 1514 | 0.3879 | 0.2898 | SOP-8 CAN Transceivers ROHS | ok
CAN-FD | TJA1051T/3 | TJA1051T/3-JSM | JSMSEMI | C49450397 | SOP-8 | Extended | 2012 | 0.461 | 0.3616 | 0.2672 | 2012 | 0.3623 | 0.2677 | -40℃~+125℃ 1 1uA 4.5V~5.5V 5Mbps 70mA CAN FD Transceiver TXD dominant timeout、ESD protection、Undervoltage Protection、Thermal shutdown protection、Bus fault prote | ok
CAN-FD | TJA1051T/3 | TJA1051T/3/1J-HX | ZHHXDZ | C53326728 | SOP-8 | Extended | 544 | 0.386 | 0.386 | 0.3048 | 540 | 0.3773 | 0.2979 | -40℃~+125℃ 4.5V~5.5V 5Mbps 5uA 70mA CAN FD Transceiver Low-power mode、Wake-up function、TXD dominant timeout、ESD protection、Undervoltage Protection、Thermal shutd | ok
CAN-FD | TJA1051T/3 | TJA1051T/3/1J-TUDI | Tudi | C55098876 | SOP-8 | Extended | 3713 | 0.5391 | 0.4251 | 0.316 | 3713 | 0.4278 | 0.318 | SOP-8 CAN Transceivers ROHS | ok
CAN-FD | TJA1051T/3 | TJA1051T/3/CM-TUDI | Tudi | C55098877 | SOP-8 | Extended | 111 | 0.6222 | 0.5033 | 0.3844 | 111 | 0.5064 | 0.3868 | SOP-8 CAN Transceivers ROHS | ok
CAN-FD | TJA1462AT | TJA1462AT | NXP Semicon | C4944078 | SOIC-8-150MIL | Extended | 0 | 0.0396 | 0.0396 | 0.0204 |  |  |  | SOIC-8-150mil New Arrivals ROHS | ok
CAN-FD | TJA1462AT | TJA1462AT/0Z | NXP Semicon | C3234095 | SOIC-8 | Extended | 10844 | 1.005 | 0.8274 | 0.6222 | 10844 | 0.835 | 0.6279 | -40℃~+150℃ 1 2uA 4.5V~5.5V 70mA 8Mbps CAN FD Transceiver Low-power mode、Wake-up function、TXD dominant timeout、ESD protection、Undervoltage Protection、Thermal shu | ok
CAN-FD | TJA1462AT | TJA1462ATK/0Z | NXP Semicon | C3229259 | HVSON-8-EP(3x3) | Extended | 3190 | 0.9398 | 0.772 | 0.6059 | 3190 | 0.7794 | 0.6117 | -40℃~+150℃ 2uA 4.5V~5.5V 70mA 8Mbps CAN FD Transceiver HVSON-8-EP(3x3) CAN Transceivers ROHS | ok
CAN-FD | SIT1044QT | SIT1044QT | SIT | C5121966 | SOP-8 | Extended | 1780 | 0.487 | 0.3958 | 0.3095 | 1092 | 0.3956 | 0.3093 | -40℃~+125℃ 1 30uA 30uA 4.75V~5.25V 5Mbps CAN FD Transceiver Low-power mode、Wake-up function、TXD dominant timeout、ESD protection、Undervoltage Protection、Thermal | ok
CAN-FD | SIT1044QT | SIT1044QT/3 | SIT | C5121967 | SOP-8 | Extended | 9856 | 0.5196 | 0.4203 | 0.3242 | 9856 | 0.4189 | 0.3231 | -40℃~+125℃ 1 30uA 4.75V~5.25V 5Mbps 70mA CAN FD Transceiver Low-power mode、Wake-up function、TXD dominant timeout、ESD protection、Undervoltage Protection、Thermal | ok
CAN-FD | SIT1044QT | SIT1044QTK/3 | SIT | C5308063 | DFN-8(3x3) | Extended | 12378 | 0.5261 | 0.4235 | 0.3258 | 12378 | 0.4224 | 0.325 | -40℃~+125℃ 1 30uA 30uA 4.75V~5.25V 5Mbps CAN FD Transceiver Low-power mode、Wake-up function、TXD dominant timeout、ESD protection、Undervoltage Protection、Thermal | ok
CAN-FD | SIT1044QT | SIT1044QTK | SIT | C7433964 | DFN3x3-8 | Extended | 4383 | 0.5424 | 0.4333 | 0.329 | 4383 | 0.4369 | 0.3318 | -40℃~+125℃ 1 30uA 4.75V~5.25V 5Mbps 70mA CAN FD Transceiver Low-power mode、Wake-up function、TXD dominant timeout、ESD protection、Undervoltage Protection、Thermal | ok
CAN-FD | SIT1044QT | SIT1044QT/1 | SIT | C49236570 | SOP-8 | Extended | 284 | 0.2444 | 0.2395 | 0.2313 | 284 | 0.2414 | 0.2332 | -40℃~+150℃ 15uA 4.75V~5.25V 5Mbps CAN FD Transceiver SOP-8 CAN Transceivers ROHS | ok
CAN-FD | SIT1044QT | SIT1044QT/31 | SIT | C49236566 | SOP-8 | Extended | 2330 | 0.4577 | 0.3616 | 0.2688 | 2330 | 0.3639 | 0.2705 | -40℃~+150℃ 4.75V~5.25V 5Mbps 5uA CAN FD Transceiver SOP-8 CAN Transceivers ROHS | ok
CAN-FD | SIT1044QT | SIT1044QTK/1 | SIT | C49236572 | DFN-8(3x3) | Extended | 628 | 0.5033 | 0.3975 | 0.2948 | 628 | 0.3999 | 0.2967 | -40℃~150℃ 15uA 4.75V~5.25V 5Mbps CAN FD Transceiver DFN-8(3x3) CAN Transceivers ROHS | ok
CAN-FD | SIT1044QT | SIT1044QTK/31 | SIT | C49236567 | DFN-8(3x3) | Extended | 45 | 0.2444 | 0.2395 | 0.2313 | 45 | 0.241 | 0.2328 | -40℃~+150℃ 4.75V~5.25V 5Mbps 5uA CAN FD Transceiver DFN-8(3x3) CAN Transceivers ROHS | ok
CAN-FD | CA-IF1044 | CA-IF1044D-Q1 | Chipanalog | C7422513 | DFN-8(3x3) | Extended | 0 | 0.474 | 0.3649 | 0.259 | 0 | 0.342 | 0.2428 | -40℃~+125℃ 4.5V~5.5V 5Mbps 7.5mA 70mA CAN FD Transceiver DFN-8(3x3) CAN Transceivers ROHS | ok
CAN-FD | CA-IF1044 | CA-IF1044S-Q1 | Chipanalog | C7422532 | SOIC-8 | Extended | 0 | 0.5163 | 0.3975 | 0.2818 | 0 | 0.3978 | 0.3068 | -40℃~+125℃ 4.5V~5.5V 5Mbps 7.5mA 80mA CAN FD Transceiver SOIC-8 CAN Transceivers ROHS | ok
CAN-FD | CA-IF1044 | CA-IF1044D-Q1 | JLCPCB Assembly | C9900231207 | DFN-8(3x3) | Extended | 0 | 0.0396 | 0.0396 | 0.0204 |  |  |  | DFN-8(3x3) SMT ROHS | ok
CAN-FD | CA-IF1044 | CA-IF1044VD-Q1 | Chipanalog | C5155979 | DFN-8(3x3) | Extended | 0 | 0.5049 | 0.3893 | 0.2769 | 0 | 0.3677 | 0.2616 | DFN-8(3x3) CAN Transceivers ROHS | ok
CAN-FD | CA-IF1044 | CA-IF1044VS-Q1 | Chipanalog | C5264350 | SOIC-8 | Extended | 0 | 0.5033 | 0.3877 | 0.2753 | 0 | 0.3978 | 0.3068 | -40℃~+125℃ 35uA 4.5V~5.5V 5Mbps 80mA CAN FD Transceiver SOIC-8 CAN Transceivers ROHS | ok
CAN-FD | CA-IF1044 | CA-IF1044VD-Q1 | JLCPCB Assembly | C9900077846 | DFN3*3-8 | Extended | 0 | 0.0396 | 0.0396 | 0.0204 |  |  |  | DFN3*3-8 New Arrivals ROHS | ok
CAN-FD | CA-IF1044 | CA-IF1044AS-Q1 | Chipanalog | C51886492 | SOIC8 | Extended | 0 | 0.0396 | 0.0396 | 0.0204 |  |  |  | SOIC8 SMT ROHS | ok
CAN-FD | CA-IF1044 | CA-IF1044AVS-Q1 | JLCPCB Assembly | C9900191512 | SOIC-8_L4.9-W3.9-P1.27-LS6.0-BL | Extended | 0 | 0.0396 | 0.0396 | 0.0204 |  |  |  | SOIC-8_L4.9-W3.9-P1.27-LS6.0-BL SMT ROHS | ok
CAN-FD | CA-IF1044 | CA-IF1044AVD-Q1 | Chipanalog | C53242099 | DFN8 | Extended | 0 | 0.0396 | 0.0396 | 0.0204 |  |  |  | DFN8 SMT ROHS | ok
CAN ESD | NUP2105L | NUP2105LT1G | onsemi | C14486 | SOT-23 | Extended | 252177 | 0.0826 | 0.0826 | 0.0683 | 252085 | 0.0834 | 0.0688 | -55℃~+150℃ 100nA 2 24V 30pF 32V 350W@8/20us 44V 8A@8/20us Bidirectional IEC 61000-4-2、IEC 61000-4-5、IEC 61000-4-4 TVS SOT-23 ESD and Surge Protection (TVS/ESD) | ok
CAN ESD | NUP2105L | NUP2105L | DOWO | C284104 | SOT-23 | Extended | 61812 | 0.0571 | 0.0571 | 0.046 | 61800 | 0.0575 | 0.0465 | -55℃~+125℃ 2 200nA 24V 26.7V 30pF 420W@8/20us 43V 8A Bidirectional ESD IEC 61000-4-2、IEC 61000-4-5、IEC 61000-4-4 SOT-23 ESD and Surge Protection (TVS/ESD) ROHS | ok
CAN ESD | NUP2105L | NUP2105LT1G-N | BORN | C920312 | SOT-23 | Extended | 8642 | 0.068 | 0.068 | 0.0546 | 8630 | 0.0686 | 0.0552 | 12pF 24V 280W@8/20us 30V 500nA 55V 6A@8/20us ESD IEC 61000-4-2、IEC 61000-4-5、IEC 61000-4-4 Unidirectional SOT-23 ESD and Surge Protection (TVS/ESD) ROHS | ok
CAN ESD | NUP2105L | NUP2105LT1G-MS | MSKSEMI | C2830117 | SOT-23 | Extended | 466 | 0.0509 | 0.0509 | 0.0416 | 460 | 0.0514 | 0.0419 | 2 200nA 24V 25pF 27V 300W 45V ESD SOT-23 ESD and Surge Protection (TVS/ESD) ROHS | ok
CAN ESD | NUP2105L | NUP2105LT1G-TP | TECH PUBLIC | C2835456 | SOT-23 | Extended | 1934 | 0.0572 | 0.0572 | 0.0455 | 1930 | 0.0575 | 0.0458 | 24V 25pF 26.7V 300W@8/20us 43V 7A@8/20us 80nA ESD IEC 61000-4-2、IEC 61000-4-4 SOT-23 ESD and Surge Protection (TVS/ESD) ROHS | ok
CAN ESD | NUP2105L | NUP2105LT1G | TECH PUBLIC | C2890118 | SOT-23 | Extended | 29022 | 0.0533 | 0.0533 | 0.0426 | 27450 | 0.0537 | 0.0428 | -55℃~+125℃ 2 24V 25pF 26.7V 300W@8/20us 43V 7A 80nA Bidirectional ESD IEC 61000-4-2、IEC 61000-4-4 SOT-23 ESD and Surge Protection (TVS/ESD) ROHS | ok
CAN ESD | NUP2105L | NUP2105LT1G | Slkor(SLKORMICRO Elec.) | C2943015 | SOT-23 | Extended | 382 | 0.074 | 0.074 | 0.0592 | 380 | 0.0747 | 0.0597 | 100nA 24V 25pF 32V 350W@8/20us 36V、46V 8A@8/20us ESD IEC 61000-4-2、IEC 61000-4-5、IEC 61000-4-4 SOT-23 ESD and Surge Protection (TVS/ESD) ROHS | ok
CAN ESD | NUP2105L | NUP2105LT1G | Leiditech | C2972524 | SOT-23 | Extended | 2798 | 0.1518 | 0.1518 | 0.1209 | 2795 | 0.1528 | 0.1217 | 2 24V 28.5V 30pF 420W@8/20us 500nA 58V 9A@8/20us Bidirectional ESD IEC 61000-4-2、IEC 61000-4-5、IEC 61000-4-4 SOT-23 ESD and Surge Protection (TVS/ESD) ROHS | ok
CAN ESD | NUP2105L | NUP2105LT1G | DOWO | C2976509 | SOT-23 | Extended | 37234 | 0.0466 | 0.0466 | 0.0373 | 35530 | 0.0469 | 0.0374 | -55℃~+125℃ 2 200nA 24V 26.7V 30pF 420W@8/20us 43V 8A Bidirectional ESD IEC 61000-4-2、IEC 61000-4-5、IEC 61000-4-4 SOT-23 ESD and Surge Protection (TVS/ESD) ROHS | ok
CAN ESD | NUP2105L | NUP2105L | (DIOTEC) | C3700834 | SOT-23-3 | Extended | 400 | 0.1515 | 0.1515 | 0.1186 | 400 | 0.1525 | 0.1193 | -55℃~+125℃ 100nA 2 24V 26.2V 30pF 350W 44V 8A@8/20us Bidirectional ESD IEC 61000-4-2 SOT-23-3 ESD and Surge Protection (TVS/ESD) ROHS | ok
CAN ESD | NUP2105L | NUP2105L | UMW(Youtai Semiconductor Co., Ltd.) | C5158054 | SOT-23 | Extended | 14044 | 0.0419 | 0.0419 | 0.0419 | 12980 | 0.0422 | 0.0422 | 15nA 24V 30pF 32V 350W@8/20us 44V 8A@8/20us IEC 61000-4-2、IEC 61000-4-5、IEC 61000-4-4 SOT-23 ESD and Surge Protection (TVS/ESD) ROHS | ok
CAN ESD | NUP2105L | NUP2105LT1G-ES | ElecSuper | C5180311 | SOT-23 | Extended | 36801 | 0.0259 | 0.0259 | 0.0229 | 36800 | 0.0262 | 0.0231 | 1uA 2 24V 24pF 26.5V 48V 600W@8/20us 8A Bidirectional ESD IEC 61000-4-2 SOT-23 ESD and Surge Protection (TVS/ESD) ROHS | ok
CAN ESD | NUP2105L | NUP2105LT1G | HXY MOSFET | C5261087 | SOT-23 | Extended | 10937 | 0.0437 | 0.0437 | 0.0365 | 10930 | 0.0439 | 0.0367 | 1 10pF 160W 24V 26V 40V 4A 500nA Bidirectional ESD IEC 61000-4-2 SOT-23 ESD and Surge Protection (TVS/ESD) ROHS | ok
CAN ESD | NUP2105L | NUP2105L-AQ | (DIOTEC) | C3712247 | SOT-23-3 | Extended | 0 | 0.1072 | 0.0852 | 0.066 | 0 | 0.0802 | 0.0621 | -55℃~+125℃ 100nA 2 24V 26.2V 30pF 350W 44V 8A@8/20us Bidirectional TVS SOT-23-3 ESD and Surge Protection (TVS/ESD) ROHS | ok
CAN ESD | NUP2105L | NUP2105L | TECH PUBLIC | C19829391 | SOT-23 | Extended | 1792 | 0.051 | 0.051 | 0.0403 | 1790 | 0.0513 | 0.0405 | -55℃~+125℃ 140W@8/20us 18pF 24V 26.7V 40V 80nA IEC 61000-4-2、IEC 61000-4-4 SOT-23 ESD and Surge Protection (TVS/ESD) ROHS | ok
CAN ESD | NUP2105L | NUP2105L | Yenji Elec | C168946 | SOT-23 | Extended | 0 | 0.131 | 0.131 | 0.1059 |  |  |  | 2 200nA 20pF 24V 27V 300W@8/20us 4A@8/20us 70V IEC 61000-4-2、IEC 61000-4-5 TVS SOT-23 ESD and Surge Protection (TVS/ESD) ROHS | ok
CAN ESD | NUP2105L | NUP2105LG | JLCPCB Assembly | C9900132854 | SOT-23-3 | Extended | 0 | 0.0396 | 0.0396 | 0.0204 |  |  |  | SOT-23-3 New Arrivals ROHS | ok
CAN ESD | NUP2105L | NUP2105LTG | JLCPCB Assembly | C9900016700 | SOT23 | Extended | 0 | 0.0396 | 0.0396 | 0.0204 |  |  |  | SOT23 SMT ROHS | ok
CAN ESD | NUP2105L | NUP2105LT3 | JLCPCB Assembly | C9900085745 | SOT23-3 | Extended | 0 | 0.0396 | 0.0396 | 0.0204 |  |  |  | SOT23-3 New Arrivals ROHS | ok
CAN ESD | NUP2105L | NUP2105LT1G | GOODWORK | C21713988 | SOT-23 | Extended | 71774 | 0.0396 | 0.0396 | 0.0396 | 71600 | 0.0398 | 0.0398 | -55℃~+125℃ 100nA 2 20pF 24V 26.7V 350W 40V 8A Bidirectional ESD IEC 61000-4-2、IEC 61000-4-5、IEC 61000-4-4 SOT-23 ESD and Surge Protection (TVS/ESD) ROHS | ok
CAN ESD | NUP2105L | NUP2105LT3G | JLCPCB Assembly | C9900019220 | SOT23 | Extended | 0 | 0.0396 | 0.0396 | 0.0204 |  |  |  | SOT-23 SMT ROHS | ok
CAN ESD | NUP2105L | NUP2105L1TG-L | PIELENST | C41376485 | SOT-23 | Extended | 2659 | 0.029 | 0.029 | 0.029 | 2380 | 0.0292 | 0.0292 | -40℃~+125℃ 100nA 24V 30pF 32V 350W@8/20us 36V Bidirectional IEC 61000-4-2、IEC 61000-4-4 SOT-23 ESD and Surge Protection (TVS/ESD) ROHS | ok
CAN ESD | ESD2CAN24 | ESD2CAN24T2Q | Yangzhou Yangjie Elec Tech | C2942563 | SOT-23 | Extended | 12217 | 0.1468 | 0.1468 | 0.1217 | 10320 | 0.1478 | 0.1225 | 100nA 2 24V 27pF 28.3V 352W@8/20us 44V 8A@8/20us ESD IEC 61000-4-2、IEC 61000-4-5 SOT-23 ESD and Surge Protection (TVS/ESD) ROHS | ok
CAN ESD | ESD2CAN24 | ESD2CAN24-ES | ElecSuper | C19170841 | SOT-23 | Extended | 54005 | 0.0807 | 0.0807 | 0.065 | 54000 | 0.0813 | 0.0656 | -40℃~+125℃ 100nA 18pF 2 24V 28V 340W@8/20us 42V 8A@8/20us Bidirectional IEC 61000-4-2 TVS SOT-23 ESD and Surge Protection (TVS/ESD) ROHS | ok
CAN ESD | ESD2CAN24 | ESD2CAN24T2Q | RUILON(Shenzhen Ruilongyuan Elec) | C53413269 | SOT-23 | Extended | 1818 | 0.1593 | 0.1593 | 0.132 | 1815 | 0.159 | 0.1317 | SOT-23 ESD and Surge Protection (TVS/ESD) ROHS | ok
CAN ESD | ESD2CAN24 | ESD2CAN24T2SQ | Yangzhou Yangjie Elec Tech | C20600709 | SOT-23 | Extended | 5803 | 0.0926 | 0.0926 | 0.0729 | 5255 | 0.0935 | 0.0736 | 1.5nA 2 24V 308W@8/20us 30pF 32V 44V 7A@8/20us Bidirectional ESD IEC 61000-4-2、IEC 61000-4-5 SOT-23 ESD and Surge Protection (TVS/ESD) ROHS | ok
CAN ESD | ESD2CAN24 | ESD2CAN24T2HQ | Yangzhou Yangjie Elec Tech | C54584804 | SOT-23 | Extended | 0 | 0.0396 | 0.0396 | 0.0204 |  |  |  | SOT-23 SMT ROHS | ok
CAN ESD | ESD2CAN24 | ESD2CAN24DBZRQ1 | Texas Instruments | C5736151 | SOT-23 | Extended | 11885 | 0.2955 | 0.2955 | 0.2294 | 11895 | 0.2983 | 0.2316 | -55℃~+150℃ 2 210W@8/20us 24V 35.5V 37V 3pF 5.7A@8/20us 50nA Bidirectional ESD IEC 61000-4-2 SOT-23 ESD and Surge Protection (TVS/ESD) ROHS | ok
CAN ESD | ESD2CAN24 | ESD2CAN24DCKRQ1 | Texas Instruments | C7469913 | SC-70-3 | Extended | 7269 | 0.2813 | 0.2813 | 0.2227 | 6285 | 0.284 | 0.2247 | -55℃~+150℃ 2 210W@8/20us 24V 35.5V 37V 3pF 5.7A@8/20us 50nA Bidirectional ESD IEC 61000-4-2 SC-70-3 ESD and Surge Protection (TVS/ESD) ROHS | ok
CAN ESD | ESD2CAN24 | ESD2CAN24T2Q-ES | ElecSuper | C23083860 | SOT-23 | Extended | 2902 | 0.0764 | 0.0764 | 0.0572 | 2900 | 0.0727 | 0.0543 | -40℃~+125℃ 100nA 18pF 2 24V 28V 31V、42V 340W@8/20us 8A@8/20us Bidirectional IEC 61000-4-2 TVS SOT-23 ESD and Surge Protection (TVS/ESD) ROHS | ok
CAN ESD | ESD2CAN24 | ESD2CAN24T2Q-F2-0000HF | JLCPCB Assembly | C9900314078 | SOT-23-3 | Extended | 0 | 0.0396 | 0.0396 | 0.0204 |  |  |  | SOT-23-3 SMT ROHS | ok
CAN ESD | PESD2CAN | PESD2CAN,215 | Nexperia | C75176 | SOT-23 | Extended | 44122 | 0.0782 | 0.0782 | 0.0619 | 44160 | 0.079 | 0.0626 | -55℃~+150℃ 1nA 2 230W@8/20us 24V 25pF 28V 41V 5A@8/20us Bidirectional ESD IEC 61000-4-2、IEC 61000-4-5 SOT-23 ESD and Surge Protection (TVS/ESD) ROHS | ok
CAN ESD | PESD2CAN | PESD2CAN | DOWO | C284078 | SOT-23 | Extended | 123524 | 0.0447 | 0.0447 | 0.0354 | 123520 | 0.045 | 0.0356 | 2 24V 26.7V 30pF 420W@8/20us 500nA 54V 8A@8/20us Bidirectional IEC 61000-4-2、IEC 61000-4-5、IEC 61000-4-4 TVS SOT-23 ESD and Surge Protection (TVS/ESD) ROHS | ok
CAN ESD | PESD2CAN | PESD2CANFD24V-TR | Nexperia | C552486 | SOT-23 | Extended | 20562 | 0.2668 | 0.2668 | 0.2108 | 20550 | 0.2691 | 0.2126 | -55℃~+175℃ 2.6A@8/20us 24V 25.5V 42V 50nA 6pF Bidirectional ESD IEC 61000-4-2 SOT-23 ESD and Surge Protection (TVS/ESD) ROHS | ok
CAN ESD | PESD2CAN | PESD2CANFD27V-TR | Nexperia | C552488 | SOT-23 | Extended | 2780 | 0.658 | 0.5326 | 0.4056 | 2780 | 0.5379 | 0.4096 | 2 2.5A@8/20us 27V 38V 44V 50nA 6pF Bidirectional ESD IEC 61000-4-2 SOT-23 ESD and Surge Protection (TVS/ESD) ROHS | ok
CAN ESD | PESD2CAN | PESD2CAN | TECH PUBLIC | C907830 | SOT-23 | Extended | 16742 | 0.0453 | 0.0453 | 0.0367 | 16100 | 0.0455 | 0.0369 | -55℃~+125℃ 17pF 2 24V 250W@8/20us 32V 5.5A@8/20us 50V 80nA Bidirectional ESD IEC 61000-4-2、IEC 61000-4-5、IEC 61000-4-4 SOT-23 ESD and Surge Protection (TVS/ESD) | ok
CAN ESD | PESD2CAN | PESD2CANFD24U-UX | Nexperia | C2649021 | SOT-323 | Extended | 4 | 0.0621 | 0.0621 | 0.0606 | 0 | 0.062 | 0.0607 | 1.9A@8/20us 2 24V 25.5V 3.5pF 43V 50nA Bidirectional ESD IEC 61000-4-2 SOT-323 ESD and Surge Protection (TVS/ESD) ROHS | ok
CAN ESD | PESD2CAN | PESD2CAN | UMW(Youtai Semiconductor Co., Ltd.) | C2687131 | SOT-23 | Extended | 658668 | 0.0362 | 0.0362 | 0.0362 | 657560 | 0.0362 | 0.0362 | 24V 250W@8/20us 25pF 28V 41V 500nA 6A@8/20us Bidirectional ESD IEC 61000-4-2、IEC 61000-4-5、IEC 61000-4-4 SOT-23 ESD and Surge Protection (TVS/ESD) ROHS | ok
CAN ESD | PESD2CAN | PESD2CAN | Leiditech | C2972526 | SOT-23 | Extended | 4972 | 0.1621 | 0.1621 | 0.1312 | 4970 | 0.1621 | 0.1312 | 2 24V 28.5V 30pF 420W@8/20us 500nA 58V 9A@8/20us Bidirectional ESD IEC 61000-4-2、IEC 61000-4-5、IEC 61000-4-4 SOT-23 ESD and Surge Protection (TVS/ESD) ROHS | ok
CAN ESD | PESD2CAN | PESD2CANFD27U-TR | Nexperia | C3704425 | TO-236AB | Extended | 2429 | 0.1527 | 0.1527 | 0.1193 | 2425 | 0.1539 | 0.1202 | -55℃~+175℃ 1A@8/20us 1nA 2 27V 28V 3.6pF 44V Bidirectional IEC 61000-4-2 TVS TO-236AB ESD and Surge Protection (TVS/ESD) ROHS | ok
CAN ESD | PESD2CAN | PESD2CANFD27L-TR | Nexperia | C3705004 | TO-236AB | Extended | 3878 | 0.1919 | 0.1919 | 0.1489 | 3875 | 0.1934 | 0.1501 | 1nA 2 27V 28V 3.9A@8/20us 42V 9pF Bidirectional ESD IEC 61000-4-2 TO-236AB ESD and Surge Protection (TVS/ESD) ROHS | ok
CAN ESD | PESD2CAN | PESD2CANFD27V-QCZ | Nexperia | C3705101 | DFN1412D-3 | Extended | 2236 | 0.1426 | 0.1426 | 0.1119 | 2235 | 0.142 | 0.1115 | 1nA 2 2.5A@8/20us 27V 28V 44V 5.2pF Bidirectional ESD IEC 61000-4-2 DFN1412D-3 ESD and Surge Protection (TVS/ESD) ROHS | ok
CAN ESD | PESD2CAN | PESD2CANFD24U-QBZ | Nexperia | C3706840 | DFN1110D-3 | Extended | 2 | 0.1978 | 0.1978 | 0.1567 | 0 | 0.1976 | 0.1566 | 1.9A@8/20us 2 24V 25.5V 3.5pF 43V 50nA Bidirectional ESD IEC 61000-4-2 DFN1110D-3 ESD and Surge Protection (TVS/ESD) ROHS | ok
CAN ESD | PESD2CAN | PESD2CANFD24L-TR | Nexperia | C3711787 | SOT-23 | Extended | 12493 | 0.3906 | 0.3906 | 0.3108 | 12490 | 0.3943 | 0.3138 | 1nA 24V 30V 35.5V 4A@8/20us 9pF Bidirectional ESD IEC 61000-4-2 SOT-23 ESD and Surge Protection (TVS/ESD) ROHS | ok
CAN ESD | PESD2CAN | PESD2CANFD27L-UX | Nexperia | C3713903 | SC-70 | Extended | 1 | 0.0816 | 0.0816 | 0.0802 | 0 | 0.0814 | 0.08 | 2 27V 28V 4A@8/20us 50nA Bidirectional IEC 61000-4-5 TVS SC-70 ESD and Surge Protection (TVS/ESD) ROHS | ok
CAN ESD | PESD2CAN | PESD2CANFD24U-QCZ | Nexperia | C3714690 | DFN1412D-3 | Extended | 4888 | 0.1878 | 0.1878 | 0.1473 | 4885 | 0.1894 | 0.1485 | 1.9A@8/20us 24V 25.5V 43V Bidirectional TVS DFN1412D-3 ESD and Surge Protection (TVS/ESD) ROHS | ok
CAN ESD | PESD2CAN | PESD2CANFD27V-QBZ | Nexperia | C3715372 | DFN1110D-3 | Extended | 4391 | 0.1826 | 0.1826 | 0.1416 | 4390 | 0.1837 | 0.1424 | 1nA 2 2.5A@8/20us 27V 28V 44V 5.2pF Bidirectional ESD IEC 61000-4-2 DFN1110D-3 ESD and Surge Protection (TVS/ESD) ROHS | ok
CAN ESD | PESD2CAN | PESD2CAN | BORN | C5148484 | SOT-23 | Extended | 1566 | 0.0834 | 0.0834 | 0.0667 | 1560 | 0.0842 | 0.0674 | 12pF 24V 280W@8/20us 30V 500nA 55V 6A@8/20us Bidirectional ESD IEC 61000-4-2、IEC 61000-4-5、IEC 61000-4-4 SOT-23 ESD and Surge Protection (TVS/ESD) ROHS | ok
CAN ESD | PESD2CAN | PESD2CAN-ES | ElecSuper | C5180299 | SOT-23 | Extended | 76530 | 0.0245 | 0.0245 | 0.0214 | 76530 | 0.0247 | 0.0216 | 1uA 2 24V 24pF 26.5V 48V 8A Bidirectional ESD IEC 61000-4-2 SOT-23 ESD and Surge Protection (TVS/ESD) ROHS | ok
CAN ESD | PESD2CAN | PESD2CANFD24V-T-ES | ElecSuper | C5180309 | SOT-23 | Extended | 3118 | 0.0349 | 0.0349 | 0.0349 | 3100 | 0.0352 | 0.0352 | 1uA 2 24V 24pF 26.5V 48V 600W@8/20us 8A Bidirectional ESD IEC 61000-4-2 SOT-23 ESD and Surge Protection (TVS/ESD) ROHS | ok
CAN ESD | PESD2CAN | PESD2CAN | HXY MOSFET | C5261081 | SOT-23 | Extended | 8166 | 0.0383 | 0.0383 | 0.0307 | 7910 | 0.038 | 0.0303 | 10pF 160W@8/20us 2 24V 33V 40V 4A 500nA Bidirectional ESD IEC 61000-4-2 SOT-23 ESD and Surge Protection (TVS/ESD) ROHS | ok
CAN ESD | PESD2CAN | PESD2CANFD24V-K | PAKER | C5278878 | SOT-23 | Extended | 11066 | 0.0807 | 0.0807 | 0.0658 | 11060 | 0.0804 | 0.0656 | 12pF 2 24V 26.7V 280W@8/20us 48V 500nA 6A@8/20us Bidirectional ESD SOT-23 ESD and Surge Protection (TVS/ESD) ROHS | ok
CAN ESD | PESD2CAN | PESD2CANFD24L-U-ES | ElecSuper | C5350973 | SOT-323 | Extended | 2212 | 0.0347 | 0.0347 | 0.0272 | 2210 | 0.035 | 0.0275 | 10pF 1uA 2 220W 24V 26V 45V 4A Bidirectional ESD IEC 61000-4-2 SOT-323 ESD and Surge Protection (TVS/ESD) ROHS | ok
CAN ESD | PESD2CAN | PESD2CANFD24V-UX | Nexperia | C552487 | SOT-323 | Extended | 0 | 0.5294 | 0.4154 | 0.3046 | 0 | 0.4181 | 0.3066 | 1nA 2 2.6A@8/20us 24V 25.5V 42V 6pF Bidirectional ESD IEC 61000-4-2 SOT-323 ESD and Surge Protection (TVS/ESD) ROHS | ok
CAN ESD | PESD2CAN | PESD2CANFD27V-UX | Nexperia | C552489 | SC-70 | Extended | 0 | 1.3046 | 1.1776 | 1.0522 | 0 | 1.1747 | 1.0496 | 2 44V ESD SC-70 ESD and Surge Protection (TVS/ESD) ROHS | ok
CAN ESD | PESD2CAN | PESD2CANFD24V-QBZ | Nexperia | C3701298 | DFN1110D-3 | Extended | 0 | 0.6613 | 0.5489 | 0.4365 | 0 | 0.5475 | 0.4354 | -55℃~+150℃ 2 2.6A@8/20us 24V 25.5V 42V 50nA 6pF Bidirectional ESD IEC 61000-4-2 DFN1110D-3 ESD and Surge Protection (TVS/ESD) ROHS | ok
CAN ESD | PESD2CAN | PESD2CANFD27U-QBZ | Nexperia | C3710657 | DFN1110D-3 | Extended | 0 | 0.259 | 0.259 | 0.259 | 0 | 0.246 | 0.246 | 1.8A@8/20us 27V 28V 45V Bidirectional TVS DFN1110D-3 ESD and Surge Protection (TVS/ESD) ROHS | ok
CAN ESD | PESD2CAN | PESD2CANFD24U-U,115 | Nexperia | C3710837 | SC-70 | Extended | 0 | 0.3209 | 0.3209 | 0.2852 | 0 | 0.3201 | 0.2845 | 24V 4A@8/20us TVS SC-70 ESD and Surge Protection (TVS/ESD) ROHS | ok
CAN ESD | PESD2CAN | PESD2CANFD24U-TR | Nexperia | C3711066 | TO-236AB | Extended | 0 | 0.4323 | 0.4323 | 0.4289 | 0 | 0.4312 | 0.4278 | 1A@8/20us 24V 25.5V 3.5pF 43V 50nA IEC 61000-4-2 TVS TO-236AB ESD and Surge Protection (TVS/ESD) ROHS | ok
CAN ESD | PESD2CAN | PESD2CANFD36VT-QR | Nexperia | C5311558 | SOT-23 | Extended | 0 | 0.0966 | 0.0833 | 0.0719 | 0 | 0.0793 | 0.0683 | 2 2A@8/20us 36V 37V 45V 50nA 6pF ESD IEC 61000-4-2 SOT-23 ESD and Surge Protection (TVS/ESD) ROHS | ok
Buck | LMR16006XDDCR | LMR16006XDDCR | Texas Instruments | C87080 | SOT-6 | Extended | 33737 | 0.5733 | 0.4773 | 0.3551 | 32916 | 0.4818 | 0.3585 | -40℃~+125℃@(TJ) 1 28uA 4V~60V 600mA 700kHz 765mV~55V Adjustable Buck Buck Built-in No SOT-6 DC-DC Converters ROHS | ok
Buck | LMR16006XDDCR | LMR16006XDDCR-MS | MSKSEMI | C54539952 | SOT-23-6 | Extended | 2533 | 0.2932 | 0.2932 | 0.2316 | 2530 | 0.295 | 0.2331 | SOT-23-6 DC-DC Converters ROHS | ok
Buck | LMR16006XDDCR | LMR16006XDDCR(TOKMAS) | Tokmas | C54823941 | TSOT-23-6L | Extended | 2665 | 0.2509 | 0.2509 | 0.1976 | 2665 | 0.2516 | 0.1981 | TSOT-23-6L DC-DC Converters ROHS | ok
Buck | LMR16006YDDCR | LMR16006YDDCR | Texas Instruments | C290195 | SOT-23-6 | Extended | 25718 | 1.0131 | 0.8291 | 0.6466 | 24345 | 0.8355 | 0.6517 | -40℃~+125℃@(TJ) 1 2.1MHz 28uA 4V~60V 600mA 765mV~55V Adjustable Buck Buck Built-in No SOT-23-6 DC-DC Converters ROHS | ok
Buck | LMR36006 | LMR36006CRNXT | Texas Instruments | C1850362 | VQFN-12(2x3) | Extended | 79 | 3.1418 | 2.6564 | 2.3519 | 79 | 2.6807 | 2.3733 | -40℃~+150℃@(TJ) 1 2.1MHz 26uA 4.2V~60V 600mA Adjustable Buck Buck Built-in Yes VQFN-12(2x3) DC-DC Converters ROHS | ok
Buck | LMR36006 | LMR36006CRNXR | Texas Instruments | C1850366 | VQFN-12(2x3) | Extended | 81 | 2.9089 | 2.4577 | 1.8519 | 81 | 2.473 | 1.8634 | -40℃~+150℃@(TJ) 1 2.1MHz 26uA 4.2V~60V 600mA Adjustable Buck Buck Built-in Yes VQFN-12(2x3) DC-DC Converters ROHS | ok
Buck | LMR36006 | LMR36006BRNXR | Texas Instruments | C1850367 | VQFN-12(2x3) | Extended | 595 | 2.1401 | 1.9024 | 1.5815 | 595 | 1.9142 | 1.5913 | -40℃~+150℃@(TJ) 1 1MHz 26uA 4.2V~60V 600mA Adjustable Buck Buck Built-in Yes VQFN-12(2x3) DC-DC Converters ROHS | ok
Buck | LMR36006 | LMR36006BRNXT | Texas Instruments | C2876779 | VQFN-12(2x3) | Extended | 0 | 2.9235 | 2.8551 | 2.7639 | 0 | 2.8158 | 2.7259 | -40℃~+150℃@(TJ) 1 1MHz 4.2V~60V 600mA Buck Buck Built-in Yes VQFN-12(2x3) DC-DC Converters ROHS | ok
Buck | LMR36006 | LMR36006AQRNXRQ1 | Texas Instruments | C1850338 | VQFN-12(2x3) | Extended | 2 | 11.7738 | 10.1207 | 8.2673 | 2 | 10.2023 | 8.3339 | -40℃~+150℃@(TJ) 1 26uA 4.2V~60V 400kHz 600mA Adjustable Buck Buck Built-in Yes VQFN-12(2x3) DC-DC Converters ROHS | ok
Buck | LMR36006 | LMR36006AQRNXTQ1 | Texas Instruments | C2071444 | VQFN-12(2x3) | Extended | 4 | 2.6955 | 2.2884 | 2.0327 | 4 | 2.2867 | 2.0312 | -40℃~+150℃@(TJ) 1 26uA 4.2V~60V 400kHz 600mA Adjustable Buck Buck Built-in Yes VQFN-12(2x3) DC-DC Converters ROHS | ok
Buck | LMR36006 | LMR36006BQRNXRQ1 | Texas Instruments | C20345528 | VQFN-12-HR(2x3) | Extended | 5 | 3.5066 | 3.4154 | 3.2916 | 5 | 3.4266 | 3.3024 | -40℃~+150℃ 1 1MHz 1V~57V 26uA 4.2V~60V 600mA Adjustable Buck Built-in Light load efficient mode、Operating status indication、Frequency synchronization、Built-in L | ok
Buck | LMR36006 | LMR36006FSC3RNXRQ1 | Texas Instruments | C1850337 | VQFN-12(2x3) | Extended | 35 | 2.7493 | 2.3323 | 1.8063 | 35 | 2.3368 | 1.8097 | -40℃~+150℃@(TA) 1 2.1MHz 26uA 3.3V 4.2V~60V 600mA Buck Buck Built-in Fixed Yes VQFN-12(2x3) DC-DC Converters ROHS | ok
Buck | LMR36006 | LMR36006FSCQRNXTQ1 | Texas Instruments | C2862581 | VQFN-12(2x3) | Extended | 280 | 2.6727 | 2.3535 | 2.1906 | 276 | 2.3734 | 2.2091 | -40℃~+150℃@(TJ) 1 2.1MHz 26uA 4.2V~60V 600mA Adjustable Buck Buck Built-in Yes VQFN-12(2x3) DC-DC Converters ROHS | ok
Buck | LMR36006 | LMR36006FSCQRNXRQ1 | Texas Instruments | C2869760 | VQFN-12(2x3) | Extended | 5 | 2.2346 | 1.9414 | 1.5685 | 5 | 1.9336 | 1.5621 | -40℃~+150℃@(TJ) 1 2.1MHz 26uA 4.2V~60V 600mA Adjustable Buck Buck Built-in Yes VQFN-12(2x3) DC-DC Converters ROHS | ok
Buck | LMR36006 | LMR36006FSC3RNXTQ1 | Texas Instruments | C2876601 | VQFN-12(2x3) | Extended | 33 | 2.5685 | 2.5685 | 2.5685 | 31 | 6.5746 | 6.5746 | -40℃~+125℃@(TA) 1 2.1MHz 26uA 3.3V 4.2V~60V 600mA Buck Buck Built-in Fixed Yes VQFN-12(2x3) DC-DC Converters ROHS | ok
Buck | LMR38010 | LMR38010FDDAR | Texas Instruments | C5219308 | SO-PowerPAD-8 | Extended | 83 | 2.575 | 2.3046 | 1.9414 | 83 | 2.3097 | 1.9457 | -40℃~+150℃ 1 1A 1V~75V 2.2MHz 4.2V~80V 40uA Adjustable Buck Buck Built-in Yes SO-PowerPAD-8 DC-DC Converters ROHS | ok
Buck | LMR38010 | LMR38010SDDAR | Texas Instruments | C5219310 | SOPowerPAD-8 | Extended | 309 | 0.9284 | 0.7395 | 0.5163 | 309 | 0.7324 | 0.5114 | -40℃~+150℃@(TJ) 1 1A 200kHz~2.2MHz 4.2V~80V 40uA Adjustable Buck Buck Built-in Yes SOPowerPAD-8 DC-DC Converters ROHS | ok
Buck | LMR38010 | LMR38010FSDDAR | Texas Instruments | C5219309 | SOPowerPAD-8 | Extended | 22 | 4.8128 | 4.2916 | 3.6695 | 22 | 4.3011 | 3.6776 | -40℃~+150℃ 1 1A 1V~75V 200kHz~2.2MHz 4.2V~80V 40uA Adjustable Buck Buck Built-in Yes SOPowerPAD-8 DC-DC Converters ROHS | ok
Buck | LMR38010 | LMR38010FSQDDARQ1 | Texas Instruments | C32712895 | SOPowerPAD-8-EP | Extended | 127 | 3.5897 | 3.1597 | 2.6467 | 127 | 3.1793 | 2.6631 | -40℃~+125℃@(TA) 1 1A 1V~75V 200kHz~2.2MHz 4.2V~80V 40uA Adjustable Buck Built-in Overcurrent Protection、Light load efficient mode、Operating status indication、Cy | ok
Buck | LMR38010 | LMR38010SQDDARQ1 | Texas Instruments | C18198885 | SOPowerPAD-8 | Extended | 0 | 3.119 | 2.7819 | 2.3812 | 0 | 2.7991 | 2.396 | -40℃~+150℃@(TJ) 1 1A 1V~75V 200kHz~2.2MHz 4.2V~80V 40uA Adjustable Buck Built-in Overcurrent Protection、Light load efficient mode、Operating status indication、Cy | ok
Buck | TPS560430 | TPS560430XDBVR | Texas Instruments | C524782 | SOT-23-6 | Extended | 26183 | 0.5587 | 0.4447 | 0.3323 | 26183 | 0.4489 | 0.3355 | -40℃~+125℃@(TJ) 1 1.1MHz 4V~36V 600mA 80uA Adjustable Buck Buck Built-in Yes SOT-23-6 DC-DC Converters ROHS | ok
Buck | TPS560430 | TPS560430XDBVT | Texas Instruments | C1848531 | SOT-23-6 | Extended | 90 | 1.1222 | 1.0962 | 1.0603 | 90 | 1.0843 | 1.0489 | -40℃~+125℃@(TJ) 1 1.1MHz 1V~34.2V 4V~36V 600mA Buck Buck Built-in Yes SOT-23-6 DC-DC Converters ROHS | ok
Buck | TPS560430 | TPS560430YDBVR | Texas Instruments | C2071736 | SOT-23-6 | Extended | 125 | 1.3486 | 1.2199 | 1.0066 | 125 | 1.2309 | 1.0156 | -40℃~+125℃@(TJ) 1 1V~34.2V 2.1MHz 4V~36V 600mA 80uA Adjustable Buck Buck Built-in Yes SOT-23-6 DC-DC Converters ROHS | ok
Buck | TPS560430 | TPS560430YDBVT | Texas Instruments | C2072000 | SOT-23-6 | Extended | 20 | 1.1369 | 1.1108 | 1.0766 | 20 | 1.0909 | 1.0574 | -40℃~+125℃@(TJ) 1 1V~34.2V 2.1MHz 4V~36V 600mA Buck Buck Built-in Yes SOT-23-6 DC-DC Converters ROHS | ok
Buck | TPS560430 | TPS560430XFDBVR | Texas Instruments | C523980 | SOT-23-6 | Extended | 3408 | 0.619 | 0.5131 | 0.4072 | 3408 | 0.5143 | 0.4082 | -40℃~+125℃@(TJ) 1 1.1MHz 1V~34.2V 4V~36V 600mA 80uA Adjustable Buck Buck Built-in Yes SOT-23-6 DC-DC Converters ROHS | ok
Buck | TPS560430 | TPS560430YFDBVR | Texas Instruments | C962155 | SOT-23-6 | Extended | 13349 | 1.3144 | 1.0799 | 0.8046 | 13237 | 1.0885 | 0.811 | -40℃~+125℃@(TJ) 1 1V~34.2V 2.1MHz 4V~36V 600mA Adjustable Buck Buck Built-in Yes SOT-23-6 DC-DC Converters ROHS | ok
Buck | TPS560430 | TPS560430YFDBVT | Texas Instruments | C2071735 | SOT-23-6 | Extended | 804 | 1.2835 | 1.1352 | 0.9968 | 252 | 1.1444 | 1.0048 | -40℃~+125℃@(TJ) 1 1V~34.2V 2.1MHz 4V~36V 600mA Adjustable Buck Buck Built-in Yes SOT-23-6 DC-DC Converters ROHS | ok
Buck | TPS560430 | TPS560430XFDBVT | Texas Instruments | C2863641 | SOT-23-6 | Extended | 203 | 0.9773 | 0.7949 | 0.7036 | 203 | 0.8029 | 0.7107 | -40℃~+125℃@(TJ) 1 1.1MHz 1V~34.2V 4V~36V 600mA Adjustable Buck Buck Built-in Yes SOT-23-6 DC-DC Converters ROHS | ok
Buck | TPS560430 | TPS560430X3FDBVR | Texas Instruments | C2071721 | SOT-23-6 | Extended | 2208 | 1.3975 | 1.189 | 0.9447 | 2208 | 1.1916 | 0.9468 | -40℃~+125℃@(TJ) 1 1.1MHz 3.3V 4V~36V 600mA Buck Buck Built-in Fixed Yes SOT-23-6 DC-DC Converters ROHS | ok
Buck | TPS560430 | TPS560430X3FDBVT | Texas Instruments | C2872223 | SOT-23-6 | Extended | 277 | 1.3681 | 1.2216 | 1.0848 | 254 | 1.2319 | 1.0939 | -40℃~+125℃@(TJ) 1 1.1MHz 3.3V 4V~36V 600mA Buck Buck Built-in Fixed Yes SOT-23-6 DC-DC Converters ROHS | ok
Buck | TPS560430 | TPS560430YQDBVRQ1 | Texas Instruments | C2837687 | SOT-23-6 | Extended | 3000 | 1.176 | 0.9675 | 0.7232 | 3000 | 0.9755 | 0.7292 | -40℃~+125℃@(TJ) 1 1V~36V 2.1MHz 4V~36V 600mA Adjustable Buck Buck Built-in Yes SOT-23-6 DC-DC Converters ROHS | ok
Buck | TPS560430 | TPS560430XDBVR-MS | MSKSEMI | C50385346 | SOT-23-6 | Extended | 1914 | 0.2369 | 0.2369 | 0.2079 | 1910 | 0.2388 | 0.2095 | -40℃~+85℃ 1 1.2A 400uA 4V~36V 800kHz Adjustable Buck Buck Built-in Yes SOT-23-6 DC-DC Converters ROHS | ok
Buck | TPS560430 | TPS560430YFQDBVRQ1 | Texas Instruments | C1849549 | SOT-23-6 | Extended | 1114 | 0.8958 | 0.7264 | 0.5571 | 1114 | 0.7339 | 0.5628 | -40℃~+125℃@(TJ) 1 2.1MHz 4V~36V 600mA Adjustable Buck Buck Built-in Yes SOT-23-6 DC-DC Converters ROHS | ok
Buck | MP4560DN | MP4560DN | JLCPCB Assembly | C9900013417 | SOIC8+PAD | Extended | 0 | 0.0007 | 0.0007 | 0.0007 |  |  |  | ESOP-8 SMT ROHS | ok
Buck | MP4560DN | MP4560DN | JLCPCB Assembly | C9900159082 | ESOP-8 | Extended | 0 | 0.0396 | 0.0396 | 0.0204 |  |  |  | ESOP-8 New Arrivals ROHS | ok
Buck | MP4560DN | MP4560DN-LF-Z | Monolithic Power Systems | C40133 | SOIC-8-EP | Extended | 1318 | 4.4299 | 4.4299 | 3.8428 |  |  |  | -40℃~+125℃@(TJ) 1 140uA 1MHz、2MHz 2A 3.8V~55V 800mV~52V Adjustable Buck Buck Built-in No SOIC-8-EP DC-DC Converters ROHS | ok
Buck | MP4560DN | MP4560DN-LF-P | Monolithic Power Systems | C6993259 | SOIC-8-EP | Extended | 0 | 1.0033 | 0.816 | 0.6287 |  |  |  | -40℃~+125℃@(TJ) 1 1MHz 2A 3.8V~55V 800mV~52V Adjustable Buck Buck Built-in No SOIC-8-EP DC-DC Converters ROHS | ok
Buck | MP4560DN | MP4560DN-LF-Z | JLCPCB Assembly | C9900198422 | MSOP-8 | Extended | 0 | 0.0396 | 0.0396 | 0.0204 |  |  |  | MSOP-8 SMT ROHS | ok
Buck | MP9486A | MP9486AGN-Z | Monolithic Power Systems | C404013 | SOIC-8-EP | Extended | 1973 | 2.9488 | 2.9488 | 2.4418 |  |  |  | -40℃~+125℃@(TJ) 1 170uA 1A 1MHz 4.5V~100V Adjustable Buck Buck Built-in No SOIC-8-EP DC-DC Converters ROHS | ok
Buck | MP9486A | MP9486AGN-P | Monolithic Power Systems | C5676399 | SOIC-8-EP | Extended | 3 | 6.6793 | 6.6793 | 5.3145 |  |  |  | -40℃~+125℃@(TJ) 1 1A 1MHz 4.5V~100V Buck Buck Built-in No SOIC-8-EP DC-DC Converters ROHS | ok
Buck | MP9486A | MP9486ANG-Z | Monolithic Power Systems | C5357403 | SOIC-8 EP | Extended | 0 | 0.0396 | 0.0396 | 0.0204 |  |  |  | SOIC-8EP New Arrivals ROHS | ok
Buck | MP9486A | MP9486AGN_Z | JLCPCB Assembly | C9900173911 | ESOP-8 | Extended | 0 | 0.0396 | 0.0396 | 0.0204 |  |  |  | ESOP-8 SMT ROHS | ok
Buck | MP9486A | MP9486AHSOIC-8 | JLCPCB Assembly | C9900298281 | ESOP-8 | Extended | 0 | 0.0396 | 0.0396 | 0.0204 |  |  |  | ESOP-8 SMT ROHS | ok
Buck | SCT2A10 | SCT2A10M | JLCPCB Assembly | C9900320749 | ECLGA4.8X4.8-15L | Extended | 0 | 0.0396 | 0.0396 | 0.0204 |  |  |  | ECLGA4.8X4.8-15L SMT ROHS | ok
Buck | SCT2A10 | SCT2A10STER | SCT | C509053 | ESOP-8 | Extended | 4928 | 1.6222 | 1.3339 | 0.9952 | 4467 | 1.3476 | 1.0054 | -40℃~+125℃@(TJ) 1 100uA 300kHz~800kHz 4.5V~85V 600mA 800mV~24V Adjustable Buck Buck Built-in Yes ESOP-8 DC-DC Converters ROHS | ok
Buck | SCT2A10 | SCT2A10ASTER | SCT | C2916528 | ESOP-8 | Extended | 0 | 2.8665 | 2.4529 | 1.9284 | 0 | 2.4752 | 1.946 | -40℃~+125℃@(TJ) 1 100uA 300kHz~800kHz 4.5V~100V 600mA 800mV~24V Adjustable Buck Buck Built-in Yes ESOP-8 DC-DC Converters ROHS | ok
Buck | SCT2A10 | SCT2A10MLMAR | SCT | C56175844 | ECLGA4.8X4.8-15L | Extended | 0 | 0.0396 | 0.0396 | 0.0204 |  |  |  | ECLGA4.8X4.8-15L SMT ROHS | ok
Buck | TPS54360BDDAR | TPS54360BDDAR | Texas Instruments | C524806 | SOIC-8-EP | Extended | 61981 | 0.7525 | 0.6255 | 0.4626 | 59765 | 0.632 | 0.4674 | -40℃~+150℃@(TJ) 1 146uA 2.5MHz 3.5A 4.5V~60V 800mV~58.8V Adjustable Buck Buck Built-in No SOIC-8-EP DC-DC Converters ROHS | ok
Buck | TPS54360BDDAR | TPS54360BDDAR(TOKMAS) | Tokmas | C55019284 | ESOP-8 | Extended | 1718 | 0.6124 | 0.4919 | 0.373 | 1718 | 0.4933 | 0.3741 | ESOP-8 DC-DC Converters ROHS | ok
LDO | TLV75533PDBVR | TLV75533PDBVR | Texas Instruments | C404027 | SOT-23-5 | Extended | 132914 | 0.1424 | 0.1424 | 0.1132 | 131070 | 0.1439 | 0.1144 | -40℃~+125℃@(Tj) 1 238mV@(500mA) 25uA 3.3V 46dB@(100kHz) 5.5V 500mA 71.5uVrms Fixed Over Current Protection、Thermal Shutdown、Input undervoltage protection Positi | ok
LDO | TLV75533PDBVR | TLV75533PDBVR-MS | MSKSEMI | C30197532 | SOT-23-5 | Extended | 1883 | 0.1478 | 0.1478 | 0.1149 | 1880 | 0.1491 | 0.1159 | SOT-23-5 Voltage Regulators - Linear, Low Drop Out (LDO) Regulators ROHS | ok
LDO | TLV75533PDBVR | TLV75533PDBVR-HXY | HXY MOSFET | C42411799 | SOT-23-5L | Extended | 2608 | 0.1722 | 0.1722 | 0.1369 | 2605 | 0.1679 | 0.1335 | -40℃~+85℃ 120mV@(100mA) 3.3V 500mA 6V Enable SOT-23-5L Voltage Regulators - Linear, Low Drop Out (LDO) Regulators ROHS | ok
LDO | ME6211C33M5G | ME6211C33M5G | JLCPCB Assembly | C9900139058 | DFN2X2-6L | Extended | 0 | 0.0396 | 0.0396 | 0.0204 |  |  |  | DFN2X2-6L New Arrivals ROHS | ok
LDO | ME6211C33M5G | ME6211C33M5G | JLCPCB Assembly | C9900151594 | SOT23-5 | Extended | 0 | 0.0396 | 0.0396 | 0.0204 |  |  |  | SOT23-5 New Arrivals ROHS | ok
LDO | ME6211C33M5G | ME6211C33M5G-N | MICRONE(Nanjing Micro One Elec) | C82942 | SOT-23-5 | Extended | 171519 | 0.0613 | 0.0613 | 0.0497 | 161900 | 0.0619 | 0.0502 | -40℃~+150℃ 1 120mV@(100mA) 3.3V 500mA 50uVrms 60uA 6V 70dB@(1kHz) Fixed Over Current Protection、Enable、Short Circuit Protection Positive SOT-23-5 Voltage Regula | ok
LDO | XC6206P332MR | XC6206P332MR-G | Torex Semicon | C5446 | SOT-23-3L | Basic | 421204 | 0.1429 | 0.1429 | 0.1173 | 164905 | 0.1442 | 0.1184 | -40℃~+85℃@(Ta) 1 1uA 200mA 3.3V 6V Fixed Over Current Protection Positive SOT-23-3L Voltage Regulators - Linear, Low Drop Out (LDO) Regulators ROHS | ok
LDO | XC6206P332MR | XC6206P332MR | UMW(Youtai Semiconductor Co., Ltd.) | C347376 | SOT-23 | Extended | 1873170 | 0.0191 | 0.0191 | 0.0191 | 1862300 | 0.0191 | 0.0191 | -25℃~+80℃@(Ta) 1 240mV@(50mA) 250mA 3.3V 40dB@(1kHz) 7uA 8V Fixed Over Current Protection、Short Circuit Protection Positive SOT-23 Voltage Regulators - Linear, | ok
LDO | XC6206P332MR | XC6206P332MR | PUOLOP | C479053 | SOT-23 | Extended | 9846 | 0.0316 | 0.0316 | 0.0316 | 9840 | 0.0319 | 0.0319 | -40℃~+85℃@(Ta) 1 100mA 240mV@(50mA) 2uA 3.3V 40dB@(1kHz) 6V Fixed Over Current Protection、Short Circuit Protection Positive SOT-23 Voltage Regulators - Linear, | ok
LDO | XC6206P332MR | XC6206P332MR(1uA) | TECH PUBLIC | C2827648 | SOT-23-3L | Extended | 1073 | 0.075 | 0.075 | 0.0593 | 1070 | 0.0756 | 0.0599 | -25℃~+85℃@(Ta) 1 1uA 200mA 200mV@(100mA) 3.3V 7V Fixed Over Current Protection、Short Circuit Protection Positive SOT-23-3L Voltage Regulators - Linear, Low Drop | ok
LDO | XC6206P332MR | XC6206P332MR | YONGYUTAI | C2897477 | SOT-23-3L | Extended | 4933 | 0.0386 | 0.0386 | 0.0308 | 4930 | 0.039 | 0.031 | -40℃~+125℃@(Tj) 1 200mV@(90mA)、400mV@(200mA) 3.3V 300mA 6V 8uA Fixed Over Current Protection、Short Circuit Protection Positive SOT-23-3L Voltage Regulators - Li | ok
LDO | XC6206P332MR | XC6206P332MR | YONGYUTAI | C2909968 | SOT-23 | Extended | 7681 | 0.0246 | 0.0246 | 0.0246 | 7680 | 0.0248 | 0.0248 | -40℃~+125℃@(Tj) 1 200mA 3.3V 400mV@(200mA) 6V 8uA Fixed Over Current Protection、Short Circuit Protection Positive SOT-23 Voltage Regulators - Linear, Low Drop O | ok
LDO | XC6206P332MR | XC6206P332MR | HXY MOSFET | C5148692 | SOT-23 | Extended | 674259 | 0.0183 | 0.0183 | 0.0183 | 656200 | 0.0184 | 0.0184 | -40℃~+85℃@(Ta) 1 240mV@(50mA) 3.3V 300mA 3uA 40dB@(1kHz) 8V Fixed Over Current Protection、Short Circuit Protection Positive SOT-23 Voltage Regulators - Linear, | ok
LDO | XC6206P332MR | XC6206P332MR | TWGMC | C5250985 | SOT-23 | Extended | 10354 | 0.0207 | 0.0207 | 0.0207 | 10350 | 0.0207 | 0.0207 | -20℃~+85℃@(Ta) 1 160uVrms 3.3V 300mA 350mV@(100mA) 6V 70dB@(1kHz) 8uA Fixed Positive Short Circuit Protection SOT-23 Voltage Regulators - Linear, Low Drop Out ( | ok
LDO | XC6206P332MR | XC6206P332MR-MS | MSKSEMI | C5252899 | SOT-23 | Extended | 1178796 | 0.0173 | 0.0173 | 0.0173 | 1178750 | 0.0175 | 0.0175 | -20℃~+85℃ 1 240mV@(50mA) 250mA 3.3V 30uVrms 50dB@(1kHz) 6.5V Fixed Positive Short Circuit Protection SOT-23 Voltage Regulators - Linear, Low Drop Out (LDO) Regu | ok
LDO | XC6206P332MR | XC6206P332MR | GOODWORK | C6430947 | SOT-23 | Extended | 5679 | 0.0212 | 0.0212 | 0.0212 | 4150 | 0.0214 | 0.0214 | 0℃~+70℃ 1 200mA 3.3V 31mV@(10mA) 6.5V 6uA Fixed Over Current Protection、Short Circuit Protection Positive SOT-23 Voltage Regulators - Linear, Low Drop Out (LDO) | ok
LDO | XC6206P332MR | XC6206P332MR-JSM | JSMSEMI | C20616640 | SOT-23-3 | Extended | 4174 | 0.0162 | 0.0162 | 0.0162 | 4150 | 0.0163 | 0.0163 | -25℃~+80℃@(Ta) 1 160mV@(50mA) 250mA 3.3V 40dB@(1kHz) 6.5V 7uA Fixed Over Current Protection、Short Circuit Protection Positive SOT-23-3 Voltage Regulators - Line | ok
LDO | XC6206P332MR | XC6206P332MR | TDSEMIC | C22466437 | SOT-23-3 | Extended | 9123 | 0.0313 | 0.0313 | 0.0313 | 9100 | 0.0315 | 0.0315 | -40℃~+85℃@(Ta) 1 200mA 3.3V 31mV@(10mA)、121mV@(40mA) 6.5V 6.5uA Fixed Over Current Protection、Short Circuit Protection Positive SOT-23-3 Voltage Regulators - Li | ok
LDO | XC6206P332MR | XC6206P332MR-G | Torex Semicon | C2891264 | SOT-23 | Extended | 0 | 0.1326 | 0.1326 | 0.1041 | 0 | 0.1259 | 0.0989 | -40℃~+85℃@(Ta) 1 1uA 200mA 3.3V 350mV@(100mA) 6V Fixed Over Current Protection Positive SOT-23 Voltage Regulators - Linear, Low Drop Out (LDO) Regulators ROHS | ok
LDO | XC6206P332MR | XC6206P332MR | HXY MOSFET | C45958769 | SOT-23-3L | Extended | 1798 | 0.0484 | 0.0484 | 0.0385 | 1790 | 0.0486 | 0.0386 | -40℃~+85℃ 1 160mV@(50mA) 3.3V 300mA 3uA 40dB 6V Fixed Over Current Protection、Short Circuit Protection Positive SOT-23-3L Voltage Regulators - Linear, Low Drop | ok
LDO | XC6206P332MR | XC6206P332MR | QNH | C50593820 | SOT-23 | Extended | 2331 | 0.0191 | 0.0191 | 0.0191 | 2300 | 0.0193 | 0.0193 | -25℃~+125℃ 200mV@(80mA) 3.3V 300mA 50dB@1kHz 6V 9uA Over Current Protection、Short Circuit Protection Positive SOT-23 Voltage Regulators - Linear, Low Drop Out ( | ok
LDO | XC6206P332MR | XC6206P332MR | TECH PUBLIC | C51886221 | SOT-23 | Extended | 21360 | 0.0142 | 0.0142 | 0.0142 | 21350 | 0.0143 | 0.0143 | -40℃~+125℃ 1 160mV@(50mA) 3.3V 45dB@(1kHz) 6V 6uA Fixed Over Current Protection、Thermal Shutdown Positive SOT-23 Voltage Regulators - Linear, Low Drop Out (LDO) | ok
LDO | XC6206P332MR | XC6206P332MR | TDD | C55488637 | SOT-23-3 | Extended | 2700 | 0.0183 | 0.0183 | 0.0183 |  |  |  | SOT-23-3 Voltage Regulators - Linear, Low Drop Out (LDO) Regulators ROHS | ok
LDO | XC6206P332MR | XC6206P332MR | hongjiacheng | C55544541 | SOT-23 | Extended | 4000 | 0.0393 | 0.0393 | 0.0393 | 4000 | 0.0395 | 0.0395 | SOT-23 Voltage Regulators - Linear, Low Drop Out (LDO) Regulators ROHS | ok
LDO | XC6206P332MR | XC6206P332MR | MICRONE(Nanjing Micro One Elec) | C6856338 | SOT23-3 | Extended | 0 | 0.0396 | 0.0396 | 0.0204 |  |  |  | SOT23-3 New Arrivals ROHS | ok
LDO | XC6206P332MR | XC6206P332MRN | Torex Semicon | C7430205 | SOT-23 | Extended | 0 | 0.386 | 0.3763 | 0.3649 | 0 | 0.3748 | 0.3634 | -40℃~+85℃@(Ta) 1 1uA 200mA 3.3V 6V 75mV@(30mA) Fixed Over Current Protection、Short Circuit Protection Positive SOT-23 Voltage Regulators - Linear, Low Drop Out | ok
LDO | XC6206P332MR | XC6206P332MR-L | PIELENST | C41376473 | SOT-23 | Extended | 1198 | 0.0183 | 0.0183 | 0.0183 | 1150 | 0.0184 | 0.0184 | -40℃~+85℃ 1 160mV@(50mA) 3.3V 300mA 3uA 40dB@(1kHz) 8V Fixed Over Current Protection、Short Circuit Protection Positive SOT-23 Voltage Regulators - Linear, Low D | ok
LDO | XC6206P332MR | XC6206P332MR-Y | YONGYUTAI | C47147603 | SOT-23 | Extended | 8575 | 0.0237 | 0.0237 | 0.0237 | 8560 | 0.0239 | 0.0239 | -40℃~+85℃ 1 3.3V 300mA 30uVrms 55dB 5uA 8V Fixed Over Current Protection、Short Circuit Protection Positive SOT-23 Voltage Regulators - Linear, Low Drop Out (LDO | ok
LDO | XC6206P332MR | XC6206P332MR-EV | EVVO | C28646219 | SOT-23-3 | Extended | 0 | 0.0089 | 0.0089 | 0.0089 |  |  |  | 100mA 3.3V 8V Fixed SOT-23-3 Voltage Regulators - Linear, Low Drop Out (LDO) Regulators ROHS | ok
LDO | XC6206P332MR | XC6206P332MR(LX) | lingxingic | C55185842 | SOT-23 | Extended | 34 | 0.0122 | 0.0122 | 0.0122 | 0 | 0.0122 | 0.0122 | SOT-23 Voltage Regulators - Linear, Low Drop Out (LDO) Regulators ROHS | ok
LDO | XC6206P332MR | XC6206P332MR-YJLTY | JLCPCB Assembly | C9900005460 | SOT23-3 | Extended | 0 | 0.0007 | 0.0007 | 0.0007 |  |  |  | SOT23-3 SMT ROHS | ok
LDO | AMS1117-3.3 | AMS1117-3.3 | Advanced Monolithic Systems | C6186 | SOT-223 | Basic | 1194354 | 0.208 | 0.208 | 0.1623 | 744225 | 0.2102 | 0.1639 | -40℃~+125℃ 0.003%Vout 1 1.1V@(800mA) 15V 1A 3.3V 5mA 72dB@(120Hz) Fixed Over Current Protection、Short Circuit Protection、Thermal shutdown Positive SOT-223 Volta | ok
LDO | AMS1117-3.3 | AMS1117-3.3 | UMW(Youtai Semiconductor Co., Ltd.) | C347222 | SOT-223 | Extended | 789289 | 0.0486 | 0.0486 | 0.0385 | 767240 | 0.0486 | 0.0384 | -40℃~+125℃ 0.003%Vout 1 1.3V@(1A) 12V 1A 3.3V 5mA 60dB@(120Hz) Fixed Over Current Protection Positive SOT-223 Voltage Regulators - Linear, Low Drop Out (LDO) Re | ok
LDO | AMS1117-3.3 | AMS1117-3.3S | UMW(Youtai Semiconductor Co., Ltd.) | C347256 | SOT-89 | Extended | 284079 | 0.0465 | 0.0465 | 0.0364 | 280800 | 0.0424 | 0.0341 | -40℃~+125℃ 0.003%Vout 1 1.3V@(1A) 18V 1A 3.3V 5mA 60dB@(120Hz) Fixed Over Current Protection Positive SOT-89 Voltage Regulators - Linear, Low Drop Out (LDO) Reg | ok
LDO | AMS1117-3.3 | AMS1117-3.3 | PUOLOP | C351784 | SOT-223-3 | Extended | 10853 | 0.0628 | 0.0628 | 0.0509 | 10850 | 0.0633 | 0.0512 | -20℃~+125℃@(Ta) 1 1.4V@(1A) 10V 12mA 1A 3.3V Fixed Positive SOT-223-3 Voltage Regulators - Linear, Low Drop Out (LDO) Regulators ROHS | ok
LDO | AMS1117-3.3 | AMS1117-3.3 | KEXIN | C369933 | SOT-223-4 | Extended | 26454 | 0.0577 | 0.0577 | 0.046 | 26450 | 0.0581 | 0.0463 | 1 1.3V@(800mA) 18V 1A 3.3V 8mA Fixed Over Temperature Protection Positive SOT-223-4 Voltage Regulators - Linear, Low Drop Out (LDO) Regulators ROHS | ok
LDO | AMS1117-3.3 | AMS1117-3.3 | Slkor(SLKORMICRO Elec.) | C880752 | SOT-89-3 | Extended | 50898 | 0.0496 | 0.0496 | 0.0395 | 42870 | 0.0498 | 0.0398 | -40℃~+125℃@(Tj) 0.003%Vout 1 1.3V@(800mA) 18V 3.3V 3mA 70dB@(120Hz) 800mA Fixed Over Temperature Protection Positive SOT-89-3 Voltage Regulators - Linear, Low D | ok
LDO | AMS1117-3.3 | AMS1117-3.3 | JSMSEMI | C917183 | SOT-223-3 | Extended | 56827 | 0.0593 | 0.0593 | 0.0466 | 56820 | 0.0598 | 0.047 | -20℃~+125℃@(Tj) 0.003%Vout 1 1.3V@(800mA) 15V 1A 2mA 3.3V 75dB@(120Hz) Fixed Over Current Protection、Thermal shutdown Positive SOT-223-3 Voltage Regulators - Li | ok
LDO | AMS1117-3.3 | AMS1117-3.3V | WPMtek(Wei Pan Microelectronics) | C2688239 | SOT-223-3L | Extended | 2977 | 0.065 | 0.065 | 0.0527 | 2970 | 0.0657 | 0.0531 | -40℃~+125℃@(Tj) 0.003%Vout 1 1.4V@(1A) 12V 1A 3.3V 5mA 70dB@(120Hz) Fixed Over Temperature Protection、Thermal Shutdown Positive SOT-223-3L Voltage Regulators - | ok
LDO | AMS1117-3.3 | AMS1117-3.3S | KEXIN | C2842296 | SOT-223-4 | Extended | 2242 | 0.0585 | 0.0585 | 0.0468 | 2240 | 0.059 | 0.0472 | -40℃~+125℃ 1 1.26V 15V 3.3V 800mA Fixed Over Current Protection、Over Temperature Protection Positive SOT-223-4 Voltage Regulators - Linear, Low Drop Out (LDO) R | ok
LDO | AMS1117-3.3 | AMS1117-3.3 | YONGYUTAI | C2891839 | SOT-223-3 | Extended | 10911 | 0.0629 | 0.0629 | 0.0512 | 10910 | 0.0633 | 0.0515 | -40℃~+125℃@(Tj) 0.005%Vout 1 1.3V@(1A) 10mA 18V 1A 3.3V 60dB@(120Hz) Fixed Over Current Protection、Over Temperature Protection Positive SOT-223-3 Voltage Regula | ok
LDO | AMS1117-3.3 | AMS1117-3.3 | YONGYUTAI | C2904742 | SOT-89-3 | Extended | 9261 | 0.0502 | 0.0502 | 0.0452 | 9260 | 0.0506 | 0.0455 | 0.003%Vout 0℃~+125℃@(Tj) 1 1.25V@(1A) 15V 1A 3.3V 5mA 75dB@(120Hz) Fixed Over Temperature Protection Positive SOT-89-3 Voltage Regulators - Linear, Low Drop Out | ok
LDO | AMS1117-3.3 | AMS1117-3.3RG | HANSCHIP semiconductor | C2977152 | SOT-223 | Extended | 13485 | 0.0527 | 0.0527 | 0.0416 | 13480 | 0.0532 | 0.042 | -40℃~+125℃@(Tj) 0.003%Vout 1 1.3V@(1A) 10mA 15V 1A 3.3V 75dB@(120Hz) Fixed Over Current Protection、Over Temperature Protection Positive SOT-223 Voltage Regulato | ok
LDO | AMS1117-3.3 | AMS1117-3.3 | GUOXIN JIAPIN SEMICONDUCTOR | C2992570 | SOT-223-3 | Extended | 8348 | 0.0377 | 0.0377 | 0.0377 | 8340 | 0.038 | 0.038 | -40℃~+125℃@(Ta) 1 1.3V@(1A) 15V 1A 3.3V 4mA Fixed Over Current Protection、Over Temperature Protection Positive SOT-223-3 Voltage Regulators - Linear, Low Drop O | ok
LDO | AMS1117-3.3 | AMS1117-3.3V | MSKSEMI | C5120765 | SOT-223 | Extended | 298804 | 0.0525 | 0.0525 | 0.0426 | 292820 | 0.053 | 0.043 | 0℃~+125℃@(Ta) 1 1.4V@(1A) 12mA 15V 1A 3.3V Fixed Over Current Protection、Thermal shutdown Positive SOT-223 Voltage Regulators - Linear, Low Drop Out (LDO) Regul | ok
LDO | AMS1117-3.3 | AMS1117-3.3V | MSKSEMI | C5120796 | SOT-89 | Extended | 335119 | 0.0559 | 0.0559 | 0.0461 | 326290 | 0.0565 | 0.0465 | 0℃~+125℃@(Ta) 1 12mA 15V 1A 20mV@(1A) 3.3V Fixed Positive SOT-89 Voltage Regulators - Linear, Low Drop Out (LDO) Regulators ROHS | ok
LDO | AMS1117-3.3 | AMS1117-3.3 | HEERMICR | C5199435 | SOT-223 | Extended | 5057 | 0.0779 | 0.0779 | 0.0639 | 4910 | 0.0786 | 0.0644 | -20℃~+85℃@(Ta) 1 1.3V@(1A) 15V 1A 2mA 3.3V Fixed Over Temperature Protection Positive SOT-223 Voltage Regulators - Linear, Low Drop Out (LDO) Regulators ROHS | ok
LDO | AMS1117-3.3 | AMS1117-3.3V | JSMSEMI | C5205141 | SOT-223 | Extended | 116278 | 0.0566 | 0.0566 | 0.0448 | 115600 | 0.057 | 0.0452 | -20℃~+85℃ 1 1.2A 1.5V@(800mA) 15V 3.3V 5mA Fixed Positive Thermal shutdown SOT-223 Voltage Regulators - Linear, Low Drop Out (LDO) Regulators ROHS | ok
LDO | AMS1117-3.3 | AMS1117-3.3 | TWGMC | C5250992 | SOT-223-3L | Extended | 153668 | 0.0536 | 0.0536 | 0.044 | 152380 | 0.0423 | 0.034 | -40℃~+125℃@(Tj) 0.003%Vout 1 1.4V@(1A) 12V 1A 3.3V 3mA 70dB@(120Hz) Fixed Over Temperature Protection Positive SOT-223-3L Voltage Regulators - Linear, Low Drop | ok
LDO | AMS1117-3.3 | AMS1117-3.3 | HXY MOSFET | C5345982 | SOT-89-3L | Extended | 5 | 0.0434 | 0.0434 | 0.0357 | 0 | 0.0433 | 0.0356 | 0℃~+125℃@(Ta) 1 12mA 15V 1A 3.3V Fixed Positive SOT-89-3L Voltage Regulators - Linear, Low Drop Out (LDO) Regulators ROHS | ok
LDO | AMS1117-3.3 | AMS1117-3.3 | GOODWORK | C6067465 | SOT-89 | Extended | 6306 | 0.0518 | 0.0518 | 0.0409 | 6300 | 0.0523 | 0.0413 | -40℃~+125℃@(Tj) 0.003%Vout 1 18V 1A 3.3V 3mA 70dB@(120Hz) Fixed Over Temperature Protection Positive SOT-89 Voltage Regulators - Linear, Low Drop Out (LDO) Regu | ok
LDO | AMS1117-3.3 | AMS1117-3.3 | GOODWORK | C6068481 | SOT-223 | Extended | 85560 | 0.0631 | 0.0631 | 0.051 | 85560 | 0.0637 | 0.0515 | -40℃~+125℃@(Tj) 1 1.3V@(1A) 18V 1A 3.3V 3mA 70dB@(120Hz) Fixed Over Temperature Protection Positive SOT-223 Voltage Regulators - Linear, Low Drop Out (LDO) Regu | ok
LDO | AMS1117-3.3 | AMS1117-3.3V | HXY MOSFET | C17702043 | SOT-223 | Extended | 2 | 0.0238 | 0.0238 | 0.0233 | 0 | 0.0238 | 0.0233 | 0℃~+125℃ 1 12mA 12mV@(1A) 15V 1A 3.3V Fixed Positive SOT-223 Voltage Regulators - Linear, Low Drop Out (LDO) Regulators ROHS | ok
LDO | AMS1117-3.3 | AMS1117-3.3 | GR | C18164485 | SOT-223 | Extended | 44917 | 0.0395 | 0.0395 | 0.0395 | 44900 | 0.0398 | 0.0398 | 0.003%Vout 0℃~+150℃@(Tj) 1 1.2V@(1A) 15V 1A 3.3V 5mA 75dB@(120Hz) Fixed Over Current Protection、Over Temperature Protection Positive SOT-223 Voltage Regulators | ok
LDO | AMS1117-3.3 | AMS1117-3.3 | TECH PUBLIC | C18212698 | SOT-223 | Extended | 104546 | 0.053 | 0.053 | 0.0411 | 104540 | 0.0534 | 0.0415 | -50℃~+140℃ 1 1.3V@(1A) 12V 1A 3.3V 4mA Fixed Over Current Protection、Over Temperature Protection Positive SOT-223 Voltage Regulators - Linear, Low Drop Out (LDO | ok
LDO | AMS1117-3.3 | AMS1117-3.3V | TECH PUBLIC | C20611856 | SOT-223 | Extended | 10477 | 0.0499 | 0.0499 | 0.0395 | 10420 | 0.0503 | 0.0399 | -50℃~+140℃ 1 1.2V@(1A) 12V 1A 3.3V 8mA Fixed Over Current Protection、Over Temperature Protection Positive SOT-223 Voltage Regulators - Linear, Low Drop Out (LDO | ok
LDO | AMS1117-3.3 | AMS1117-3.3 | FOSAN | C20628883 | SOT-89-3L | Extended | 12216 | 0.0487 | 0.0487 | 0.0388 | 12210 | 0.0491 | 0.0392 | -40℃~+125℃ 0.003%Vout 1 1.1V@(1A) 15V 1A 2mA 3.3V Fixed Over Current Protection、Short Circuit Protection、Over Temperature Protection Positive SOT-89-3L Voltage | ok
LDO | AMS1117-3.3 | AMS1117-3.3V | Shenzhen Fuman Elec | C173386 | SOT-223 | Extended | 0 | 0.0484 | 0.0484 | 0.0385 | 0 | 0.0449 | 0.0357 | -40℃~+125℃@(Tj) 1 1.3V@(800mA) 12V 3.3V 55uA 75dB@(10kHz) 800mA 80uVrms Fixed Over Current Protection、Over Temperature Protection、Short Circuit Protection Posit | ok
LDO | AMS1117-3.3 | AMS1117-3.3 | PUOLOP | C351785 | SOT-223 | Extended | 0 | 0.0698 | 0.0698 | 0.0698 |  |  |  | SOT-223 Voltage Regulators - Linear, Low Drop Out (LDO) Regulators ROHS | ok
LDO | AMS1117-3.3 | AMS1117-3.3 | Slkor(SLKORMICRO Elec.) | C426566 | SOT-223 | Extended | 0 | 0.0518 | 0.0518 | 0.0419 | 0 | 0.0522 | 0.0423 | -40℃~+125℃ 1 1.3V@(0.8A) 18V 3.3V 3mA 70dB@(120Hz) 800mA Fixed Over Temperature Protection Positive SOT-223 Voltage Regulators - Linear, Low Drop Out (LDO) Regu | ok
LDO | RT9013-33GB | RT9013-33GB | Richtek Tech | C47773 | SOT-23-5 | Extended | 65860 | 0.143 | 0.143 | 0.117 | 64730 | 0.1442 | 0.1179 | -40℃~+125℃@(Tj) 1 25uA 3.3V 30uVrms 400mV@(500mA) 5.5V 500mA 50dB@(10kHz) Fixed Over Current Protection、Over Temperature Protection、Enable Positive SOT-23-5 Vol | ok
LDO | RT9013-33GB | RT9013-33GB | TECH PUBLIC | C19268157 | SOT-23-5 | Extended | 24859 | 0.0818 | 0.0818 | 0.0639 | 24850 | 0.0825 | 0.0645 | -40℃~+85℃ 1 3.3V 500mA 50uVrms 60uA 70dB@(1kHz) 7V Enable Fixed Positive SOT-23-5 Voltage Regulators - Linear, Low Drop Out (LDO) Regulators ROHS | ok
LDO | RT9013-33GB | RT9013-33GB-MS | MSKSEMI | C7434207 | SOT-23-5 | Extended | 135913 | 0.0584 | 0.0584 | 0.047 | 128400 | 0.0589 | 0.0474 | -40℃~+85℃ 1 100mV@(100mA)、300mV@(200mA) 3.3V 5.5V 500mA 50uVrms 60uA 75dB@(1kHz) Fixed Over Current Protection、Enable、Short Circuit Protection Positive SOT-23-5 | ok
LDO | RT9013-33GB | RT9013-33GB-JSM | JSMSEMI | C39846929 | SOT-23-5 | Extended | 4742 | 0.065 | 0.065 | 0.051 | 4740 | 0.0654 | 0.0513 | -40℃~+85℃ 1 300mV@(100mA)、500mV@(200mA) 400mA 40uA 50uVrms 70dB@(1kHz) 7V Fixed Over Current Protection、Short Circuit Protection、Enable control Positive SOT-23- | ok
LDO | TPS7A2033PDBVR | TPS7A2033PDBVR | Texas Instruments | C2862740 | SOT-23-5 | Extended | 186366 | 0.2155 | 0.2155 | 0.1663 | 180000 | 0.2175 | 0.1679 | -40℃~+125℃@(Tj) 1 10uVrms 140mV@(300mA) 3.3V 300mA 65dB@(100kHz) 6V 8.5uA Fixed Over Current Protection、Short Circuit Protection、Thermal shutdown、Enable control | ok
LDO | TPS7A2033PDBVR | TPS7A2033PDBVR-TP | TECH PUBLIC | C49452001 | SOT-23-5 | Extended | 2802 | 0.1028 | 0.1028 | 0.0813 | 2800 | 0.1036 | 0.0819 | -40℃~+85℃ 1 180uV@(300mA) 2uA 3.3V 300mA 5.5V 75dB@(1kHz) Fixed Over Current Protection、Enable、Thermal Shutdown Positive SOT-23-5 Voltage Regulators - Linear, L | ok
TVS | SMBJ54A | SMBJ54A | MDD(Microdiode Semiconductor) | C123823 | DO-214AA(SMB) | Extended | 1984 | 0.0551 | 0.0551 | 0.0453 | 1980 | 0.0554 | 0.0456 | -65℃~+150℃ 1uA 54V 6.9A@10/1000us 600W@10/1000us 66.3V 87.1V TVS Unidirectional DO-214AA(SMB) ESD and Surge Protection (TVS/ESD) ROHS | ok
TVS | SMBJ54A | SMBJ54A-13-F | Diodes Incorporated | C135083 | SMB | Extended | 1164 | 0.1849 | 0.1849 | 0.1471 | 1160 | 0.1862 | 0.1482 | -55℃~+150℃ 54V 5uA 6.9A 600W 69V 87.1V TVS Unidirectional SMB ESD and Surge Protection (TVS/ESD) ROHS | ok
TVS | SMBJ54A | SMBJ54A | Littelfuse | C151266 | DO-214AA | Extended | 2663 | 0.247 | 0.247 | 0.1914 | 2660 | 0.2488 | 0.1929 | -65℃~+150℃ 1uA 54V 6.9A@10/1000us 600W@10/1000us 66.3V 87.1V IEC 61000-4-2、IEC 61000-4-4 TVS Unidirectional DO-214AA ESD and Surge Protection (TVS/ESD) ROHS | ok
TVS | SMBJ54A | SMBJ54A | PTTC(Polytronics Tech) | C163660 | SMB(DO-214AA) | Extended | 10 | 0.1145 | 0.1145 | 0.0903 | 10 | 0.1116 | 0.088 | -55℃~+150℃ 1uA 54V 6.9A@10/1000us 600W@10/1000us 66.3V 87.1V TVS Unidirectional SMB(DO-214AA) ESD and Surge Protection (TVS/ESD) ROHS | ok
TVS | SMBJ54A | SMBJ54A | SEMIWARE | C294886 | DO-214AA(SMB) | Extended | 15 | 0.0611 | 0.0611 | 0.0489 | 10 | 0.0614 | 0.0492 | -55℃~+125℃ 1uA 54V 6.9A@10/1000us 600W@10/1000us 66.3V 87.1V TVS Unidirectional DO-214AA(SMB) ESD and Surge Protection (TVS/ESD) ROHS | ok
TVS | SMBJ54A | SMBJ54A | Shandong Jingdao Microelectronics | C353352 | SMB | Extended | 1921 | 0.0369 | 0.0369 | 0.0369 | 1840 | 0.0372 | 0.0372 | -65℃~+150℃ 1uA 390pF 54V 6.9A@10/1000us 600W@10/1000us 66.3V 87.1V TVS SMB ESD and Surge Protection (TVS/ESD) ROHS | ok
TVS | SMBJ54A | SMBJ54A | BORN | C383707 | DO-214AA(SMB) | Extended | 3850 | 0.0629 | 0.0629 | 0.0501 | 3830 | 0.0635 | 0.0505 | 1uA 54V 6.9A 600W@10/1000us 60V 87.1V TVS Unidirectional DO-214AA(SMB) ESD and Surge Protection (TVS/ESD) ROHS | ok
TVS | SMBJ54A | SMBJ54A | AnBon | C440308 | SMB(DO-214AA) | Extended | 54 | 0.0658 | 0.0658 | 0.0525 | 50 | 0.0663 | 0.0528 | -55℃~+150℃ 54V 5uA 6.9A 600W@10/1000us 60V 87.1V TVS Unidirectional SMB(DO-214AA) ESD and Surge Protection (TVS/ESD) ROHS | ok
TVS | SMBJ54A | SMBJ54A | FTR | C707475 | DO-214AA(SMB) | Extended | 511 | 0.0517 | 0.0517 | 0.0419 | 510 | 0.0515 | 0.0418 | 1uA 54V 6.9A 600W@10/1000us 60V 87.1V TVS Unidirectional DO-214AA(SMB) ESD and Surge Protection (TVS/ESD) ROHS | ok
TVS | SMBJ54A | SMBJ54A | TWGMC | C726841 | DO-214AA(SMB) | Extended | 2914 | 0.0385 | 0.0385 | 0.0385 | 2900 | 0.0386 | 0.0386 | -65℃~+150℃ 1uA 390pF 54V 6.9A 600W@10/1000us 66.3V 87.1V TVS Unidirectional DO-214AA(SMB) ESD and Surge Protection (TVS/ESD) ROHS | ok
TVS | SMBJ54A | SMBJ54A | SEMBO | C782469 | SMB(DO-214AA) | Extended | 47 | 0.0673 | 0.0673 | 0.0533 | 40 | 0.0624 | 0.0493 | -65℃~+150℃ 1uA 54V 6.9A 600W 60V 87.1V TVS SMB(DO-214AA) ESD and Surge Protection (TVS/ESD) ROHS | ok
TVS | SMBJ54A | SMBJ54A-E3/52 | Vishay Intertech | C1978757 | SMB(DO-214AA) | Extended | 2 | 0.1942 | 0.1942 | 0.1541 | 0 | 0.1957 | 0.1554 | -55℃~+150℃ 1uA 54V 6.9A@10/1000us 600W@10/1000us 66.3V 87.1V TVS Unidirectional SMB(DO-214AA) ESD and Surge Protection (TVS/ESD) ROHS | ok
TVS | SMBJ54A | SMBJ54A-Q | BOURNS | C1980061 | SMB(DO-214AA) | Extended | 100 | 0.8193 | 0.6629 | 0.5082 | 100 | 0.6682 | 0.5122 | -55℃~+150℃ 1uA 210.6V 36.5A@8/20us 54V 600W 71.2V TVS SMB(DO-214AA) ESD and Surge Protection (TVS/ESD) ROHS | ok
TVS | SMBJ54A | SMBJ54A | WPMtek(Wei Pan Microelectronics) | C2688181 | SMB(DO-214AA) | Extended | 932 | 0.058 | 0.058 | 0.047 | 930 | 0.0537 | 0.0435 | -55℃~+150℃ 1 1uA 54V 6.9A@10/1000us 600W@10/1000us 66.3V 87.1V TVS Unidirectional SMB(DO-214AA) ESD and Surge Protection (TVS/ESD) ROHS | ok
TVS | SMBJ54A | SMBJ54A | SUNMATE Elec | C2803676 | SMB(DO-214AA) | Extended | 500 | 0.0751 | 0.0751 | 0.0637 | 500 | 0.0749 | 0.0636 | -55℃~+150℃ 54V 5uA 6.9A 69V 87.1V TVS Unidirectional SMB(DO-214AA) ESD and Surge Protection (TVS/ESD) ROHS | ok
TVS | SMBJ54A | SMBJ54A | GOODWORK | C2891330 | DO-214AA(SMB) | Extended | 6025 | 0.0429 | 0.0429 | 0.0429 | 6020 | 0.0428 | 0.0428 | -55℃~+150℃ 54V 5uA 6.9A 600W 60V 87.1V TVS Unidirectional DO-214AA(SMB) ESD and Surge Protection (TVS/ESD) ROHS | ok
TVS | SMBJ54A | SMBJ54A | DOWO | C2943880 | SMB(DO-214AA) | Extended | 3393 | 0.0408 | 0.0408 | 0.0326 | 3390 | 0.0404 | 0.0323 | -55℃~+150℃ 1uA 54V 6.89A 600W@10/1000us 60V 87.1V TVS Unidirectional SMB(DO-214AA) ESD and Surge Protection (TVS/ESD) ROHS | ok
TVS | SMBJ54A | SMBJ54A | Liown | C2989903 | SMB(DO-214AA) | Extended | 2609 | 0.047 | 0.047 | 0.0375 | 2600 | 0.0443 | 0.0353 | -55℃~+150℃ 1uA 54V 6.9A 600W 60V 87.1V IEC 61000-4-2 TVS Unidirectional SMB(DO-214AA) ESD and Surge Protection (TVS/ESD) ROHS | ok
TVS | SMBJ54A | SMBJ54A | ZHIDE | C5161391 | DO-214AA(SMB) | Extended | 175 | 0.0746 | 0.0746 | 0.059 | 170 | 0.0744 | 0.0588 | -55℃~+150℃ 1 1uA 54V 6.9A@10/1000us 600W@10/1000us 66.3V 87.1V TVS Unidirectional DO-214AA(SMB) ESD and Surge Protection (TVS/ESD) ROHS | ok
TVS | SMBJ54A | SMBJ54A | MSKSEMI | C5331130 | DO-214AA(SMB) | Extended | 360 | 0.0334 | 0.0334 | 0.0334 | 360 | 0.0326 | 0.0326 | -55℃~+125℃ 1 1uA 54V 6.89A@10/1000us 600W 60V 87.1V TVS Unidirectional DO-214AA(SMB) ESD and Surge Protection (TVS/ESD) ROHS | ok
TVS | SMBJ54A | SMBJ54A | XCH | C5342936 | DO-214AA(SMB) | Extended | 2913 | 0.0461 | 0.0461 | 0.0369 | 2910 | 0.0455 | 0.0363 | -55℃~+150℃ 1 1uA 54V 6.9A@10/1000us 600W@10/1000us 66.3V 87.1V TVS Unidirectional DO-214AA(SMB) ESD and Surge Protection (TVS/ESD) ROHS | ok
TVS | SMBJ54A | SMBJ54A | FOSAN | C5353278 | SMB(DO-214AA) | Extended | 2304 | 0.0388 | 0.0388 | 0.0388 | 2300 | 0.0391 | 0.0391 | -55℃~+150℃ 1 54V 5uA 6.9A 600W 69V 87.1V TVS Unidirectional SMB(DO-214AA) ESD and Surge Protection (TVS/ESD) ROHS | ok
TVS | SMBJ54A | SMBJ54A | JUXING | C5860953 | SMB | Extended | 2400 | 0.0468 | 0.0468 | 0.0369 | 2400 | 0.0465 | 0.0367 | -65℃~+150℃ 1 1uA 390pF 54V 6.9A 600W@10/1000us 60V 87.1V IEC 61000-4-2 TVS Unidirectional SMB ESD and Surge Protection (TVS/ESD) ROHS | ok
TVS | SMBJ54A | SMBJ54A/TR13 | Brightking | C91967 | SMB(DO-214AA) | Extended | 0 | 0.0605 | 0.0605 | 0.0473 | 0 | 0.0609 | 0.0475 | -65℃~+150℃ 1uA 54V 6.9A 600W 60V 87.1V TVS Unidirectional SMB(DO-214AA) ESD and Surge Protection (TVS/ESD) ROHS | ok
TVS | SMBJ54A | SMBJ54A-AT | Brightking | C523329 | SMB(DO-214AA) | Extended | 0 | 0.1426 | 0.1426 | 0.123 | 0 | 0.1423 | 0.1226 | -55℃~+150℃ 1uA 54V 6.9A 600W@10/1000us 60V 87.1V TVS Unidirectional SMB(DO-214AA) ESD and Surge Protection (TVS/ESD) ROHS | ok
TVS | SMBJ54A | SMBJ54AHE3_A/I | Vishay Intertech | C1856824 | DO-214AA(SMBJ) | Extended | 0 | 0.2129 | 0.2129 | 0.2129 | 0 | 0.2017 | 0.2017 | -55℃~+150℃ 1uA 54V 6.9A@10/1000us 600W@10/1000us 66.3V 87.1V TVS Unidirectional DO-214AA(SMBJ) ESD and Surge Protection (TVS/ESD) ROHS | ok
TVS | SMBJ58A | SMBJ58A | RUILON(Shenzhen Ruilongyuan Elec) | C10226 | DO-214AA(SMB) | Extended | 893 | 0.0922 | 0.0922 | 0.0735 | 890 | 0.0897 | 0.0714 | -55℃~+150℃ 1uA 58V 6.4A@10/1000us 600W@10/1000us 74.1V 93.6V IEC 61000-4-2、IEC 61000-4-4 TVS Unidirectional DO-214AA(SMB) ESD and Surge Protection (TVS/ESD) ROH | ok
TVS | SMBJ58A | SMBJ58A | MDD(Microdiode Semiconductor) | C123824 | DO-214AA(SMB) | Extended | 1723 | 0.0553 | 0.0553 | 0.0455 | 1720 | 0.0557 | 0.0459 | -65℃~+150℃ 1uA 58V 6.5A@10/1000us 600W@10/1000us 71.2V 93.6V TVS Unidirectional DO-214AA(SMB) ESD and Surge Protection (TVS/ESD) ROHS | ok
TVS | SMBJ58A | SMBJ58A-13-F | Diodes Incorporated | C135085 | SMB | Extended | 33203 | 0.2769 | 0.2769 | 0.2183 | 33200 | 0.2797 | 0.2205 | -55℃~+150℃ 58V 5uA 6.4A 600W 74.6V 93.6V TVS Unidirectional SMB ESD and Surge Protection (TVS/ESD) ROHS | ok
TVS | SMBJ58A | SMBJ58A | BORN | C151910 | DO-214AA(SMB) | Extended | 5407 | 0.0652 | 0.0652 | 0.0518 | 5190 | 0.0658 | 0.0524 | -55℃~+150℃ 1uA 58V 6.4A@10/1000us 600W@10/1000us 71.2V 93.6V TVS Unidirectional DO-214AA(SMB) ESD and Surge Protection (TVS/ESD) ROHS | ok
TVS | SMBJ58A | SMBJ58A | Littelfuse | C157526 | DO-214AA | Extended | 5268 | 0.1372 | 0.1372 | 0.1131 | 5265 | 0.1384 | 0.1141 | -65℃~+150℃ 1uA 58V 6.9A@10/1000us 600W@10/1000us 71.2V 93.6V IEC 61000-4-2、IEC 61000-4-4 TVS Unidirectional DO-214AA ESD and Surge Protection (TVS/ESD) ROHS | ok
TVS | SMBJ58A | SMBJ58A | Suzhou Good-Ark Elec | C280378 | DO-214AA(SMB) | Extended | 54 | 0.1067 | 0.1067 | 0.0864 | 50 | 0.1007 | 0.0815 | -55℃~+150℃ 1uA 58V 6.4A 600W@10/1000us 64.4V 93.6V TVS Unidirectional DO-214AA(SMB) ESD and Surge Protection (TVS/ESD) ROHS | ok
TVS | SMBJ58A | SMBJ58A | DOWO | C284025 | SMB(DO-214AA) | Extended | 1589 | 0.0492 | 0.0492 | 0.0406 | 1550 | 0.0491 | 0.0406 | -55℃~+150℃ 1uA 58V 6.41A 600W@10/1000us 64.4V 93.6V TVS Unidirectional SMB(DO-214AA) ESD and Surge Protection (TVS/ESD) ROHS | ok
TVS | SMBJ58A | SMBJ58A | SEMIWARE | C294887 | DO-214AA(SMB) | Extended | 58 | 0.0597 | 0.0597 | 0.0474 | 50 | 0.0601 | 0.0479 | -55℃~+125℃ 1uA 58V 6.5A@10/1000us 600W@10/1000us 71.2V 93.6V TVS Unidirectional DO-214AA(SMB) ESD and Surge Protection (TVS/ESD) ROHS | ok
TVS | SMBJ58A | SMBJ58A/TR13 | Brightking | C309973 | SMB(DO-214AA) | Extended | 2909 | 0.0492 | 0.0492 | 0.0385 | 2900 | 0.0496 | 0.0387 | -65℃~+150℃ 1uA 58V 6.5A 600W 64.4V 93.6V IEC 61000-4-2 TVS Unidirectional SMB(DO-214AA) ESD and Surge Protection (TVS/ESD) ROHS | ok
TVS | SMBJ58A | SMBJ58A | LGE | C320247 | SMB(DO-214AA) | Extended | 1524 | 0.0709 | 0.0709 | 0.0569 | 1500 | 0.0709 | 0.0568 | -55℃~+150℃ 1uA 58V 6.41A 600W@10/1000us 64.4V 93.6V TVS Unidirectional SMB(DO-214AA) ESD and Surge Protection (TVS/ESD) ROHS | ok
TVS | SMBJ58A | SMBJ58A | Shandong Jingdao Microelectronics | C353350 | SMB | Extended | 978 | 0.0367 | 0.0367 | 0.0367 | 960 | 0.037 | 0.037 | 1uA 390pF 58V 6.5A 600W@10/1000us 71.2V 93.6V TVS SMB ESD and Surge Protection (TVS/ESD) ROHS | ok
TVS | SMBJ58A | SMBJ58A | Shenzhen Jinkaisheng Elec | C362093 | DO-214AA(SMB) | Extended | 3009 | 0.052 | 0.052 | 0.0414 | 3000 | 0.0525 | 0.0418 | 1uA 58V 6.4A 600W 64.4V 93.6V TVS Unidirectional DO-214AA(SMB) ESD and Surge Protection (TVS/ESD) ROHS | ok
TVS | SMBJ58A | SMBJ58A | SMC(Sangdest Microelectronicstronic (Nanjing)) | C499717 | SMB(DO-214AA) | Extended | 28 | 0.0846 | 0.0846 | 0.0673 | 25 | 0.0784 | 0.0624 | 58V 5uA 6.5A@10/1000us 600W@10/1000us 71.2V 93.6V TVS Unidirectional SMB(DO-214AA) ESD and Surge Protection (TVS/ESD) ROHS | ok
TVS | SMBJ58A | SMBJ58A | JF | C501882 | SMB(DO-214AA) | Extended | 70 | 0.0777 | 0.0777 | 0.0619 |  |  |  | 58V 5uA 6.7A 600W 64.4V 93.6V TVS Unidirectional SMB(DO-214AA) ESD and Surge Protection (TVS/ESD) ROHS | ok
TVS | SMBJ58A | SMBJ58A-AT/TR7 | Brightking | C523331 | SMB(DO-214AA) | Extended | 2 | 0.0891 | 0.0891 | 0.0696 | 0 | 0.0826 | 0.0644 | -55℃~+150℃ 1uA 58V 6.5A 600W@10/1000us 64.4V 93.6V IEC 61000-4-2 TVS Unidirectional SMB(DO-214AA) ESD and Surge Protection (TVS/ESD) ROHS | ok
TVS | SMBJ58A | SMBJ58A | FTR | C707476 | DO-214AA(SMB) | Extended | 6386 | 0.0465 | 0.0465 | 0.0365 | 6330 | 0.0469 | 0.0369 | -55℃~+150℃ 1uA 58V 6.5A 600W@10/1000us 64.4V 93.6V TVS Unidirectional DO-214AA(SMB) ESD and Surge Protection (TVS/ESD) ROHS | ok
TVS | SMBJ58A | SMBJ58A | TWGMC | C726842 | DO-214AA(SMB) | Extended | 380 | 0.0452 | 0.0452 | 0.0373 | 380 | 0.045 | 0.0372 | -65℃~+150℃ 1uA 390pF 58V 6.5A@10/1000us 600W@10/1000us 71.2V 93.6V IEC 61000-4-2 TVS Unidirectional DO-214AA(SMB) ESD and Surge Protection (TVS/ESD) ROHS | ok
TVS | SMBJ58A | SMBJ58A-TP | MCC(Micro Commercial Components) | C779088 | SMB(DO-214AA) | Extended | 10 | 0.0225 | 0.0225 | 0.0225 | 0 | 0.1506 | 0.1506 | 1uA 58V 6.4A 600W 64.4V 93.6V TVS Unidirectional SMB(DO-214AA) ESD and Surge Protection (TVS/ESD) ROHS | ok
TVS | SMBJ58A | SMBJ58A | SEMBO | C782470 | SMB(DO-214AA) | Extended | 12 | 0.0683 | 0.0683 | 0.0541 | 10 | 0.0632 | 0.0502 | -65℃~+150℃ 1uA 58V 6.4A 600W@10/1000us 64.4V 93.6V TVS Unidirectional SMB(DO-214AA) ESD and Surge Protection (TVS/ESD) ROHS | ok
TVS | SMBJ58A | SMBJ58A-E3/52 | Vishay Intertech | C968562 | SMB(DO-214AA) | Extended | 9 | 0.0945 | 0.0945 | 0.0926 | 5 | 0.0954 | 0.0933 | -55℃~+150℃ 1uA 58V 6.4A 600W 64.4V 93.6V TVS Unidirectional SMB(DO-214AA) ESD and Surge Protection (TVS/ESD) ROHS | ok
TVS | SMBJ58A | SMBJ58A | Jiangsu Changjing Electronics Technology Co., Ltd. | C1509121 | SMBG | Extended | 237 | 0.0673 | 0.0673 | 0.0527 | 230 | 0.0679 | 0.0531 | -55℃~+150℃ 58V 5uA 6.4A@10/1000us 600W@10/1000us 71.2V 93.6V TVS Unidirectional SMBG ESD and Surge Protection (TVS/ESD) ROHS | ok
TVS | SMBJ58A | SMBJ58A | WPMtek(Wei Pan Microelectronics) | C2688182 | SMB(DO-214AA) | Extended | 1308 | 0.0536 | 0.0536 | 0.0426 | 1300 | 0.05 | 0.0398 | -55℃~+150℃ 1 1uA 58V 6.4A@10/1000us 600W@10/1000us 71.2V 93.6V TVS Unidirectional SMB(DO-214AA) ESD and Surge Protection (TVS/ESD) ROHS | ok
TVS | SMBJ58A | SMBJ58A | GOODWORK | C2891331 | DO-214AA(SMB) | Extended | 11269 | 0.0445 | 0.0445 | 0.0357 | 11260 | 0.0448 | 0.0359 | -55℃~+150℃ 58V 5uA 6.4A 600W 64.4V 93.6V TVS Unidirectional DO-214AA(SMB) ESD and Surge Protection (TVS/ESD) ROHS | ok
TVS | SMBJ58A | SMBJ58A | YFW | C2898454 | DO-214AA(SMB) | Extended | 3011 | 0.0523 | 0.0523 | 0.0414 | 3010 | 0.0526 | 0.0416 | -65℃~+150℃ 1uA 390pF 58V 6.5A@10/1000us 600W@10/1000us 71.2V 93.6V IEC 61000-4-2 TVS Unidirectional DO-214AA(SMB) ESD and Surge Protection (TVS/ESD) ROHS | ok
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
