Kerol-Dev/Tercio-B1/hardware/kicad/tercio-b1.kicad_pcb

## KiCad design hardware/kicad/tercio-b1.kicad_pcb (2026-10-18)

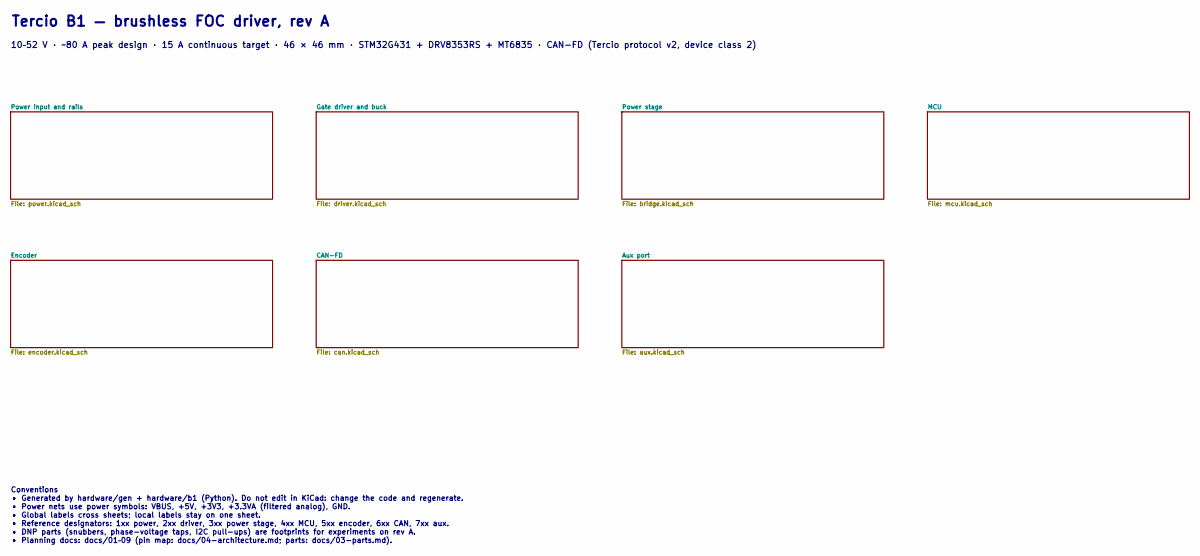
[picture p4: schematic tercio-b1.kicad_sch, Tercio B1 — brushless FOC driver]

Notes on the sheet:
Tercio B1 — brushless FOC driver, rev A
10–52 V · ~80 A peak design · 15 A continuous target · 46 × 46 mm · STM32G431 + DRV8353RS + MT6835 · CAN-FD (Tercio protocol v2, device class 2)
Conventions • Generated by hardware/gen + hardware/b1 (Python). Do not edit in KiCad: change the code and regenerate. • Power nets use power symbols: VBUS, +5V, +3V3, +3.3VA (filtered analog), GND. • Global labels cross sheets; local labels stay on one sheet. • Reference designators: 1xx power, 2xx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

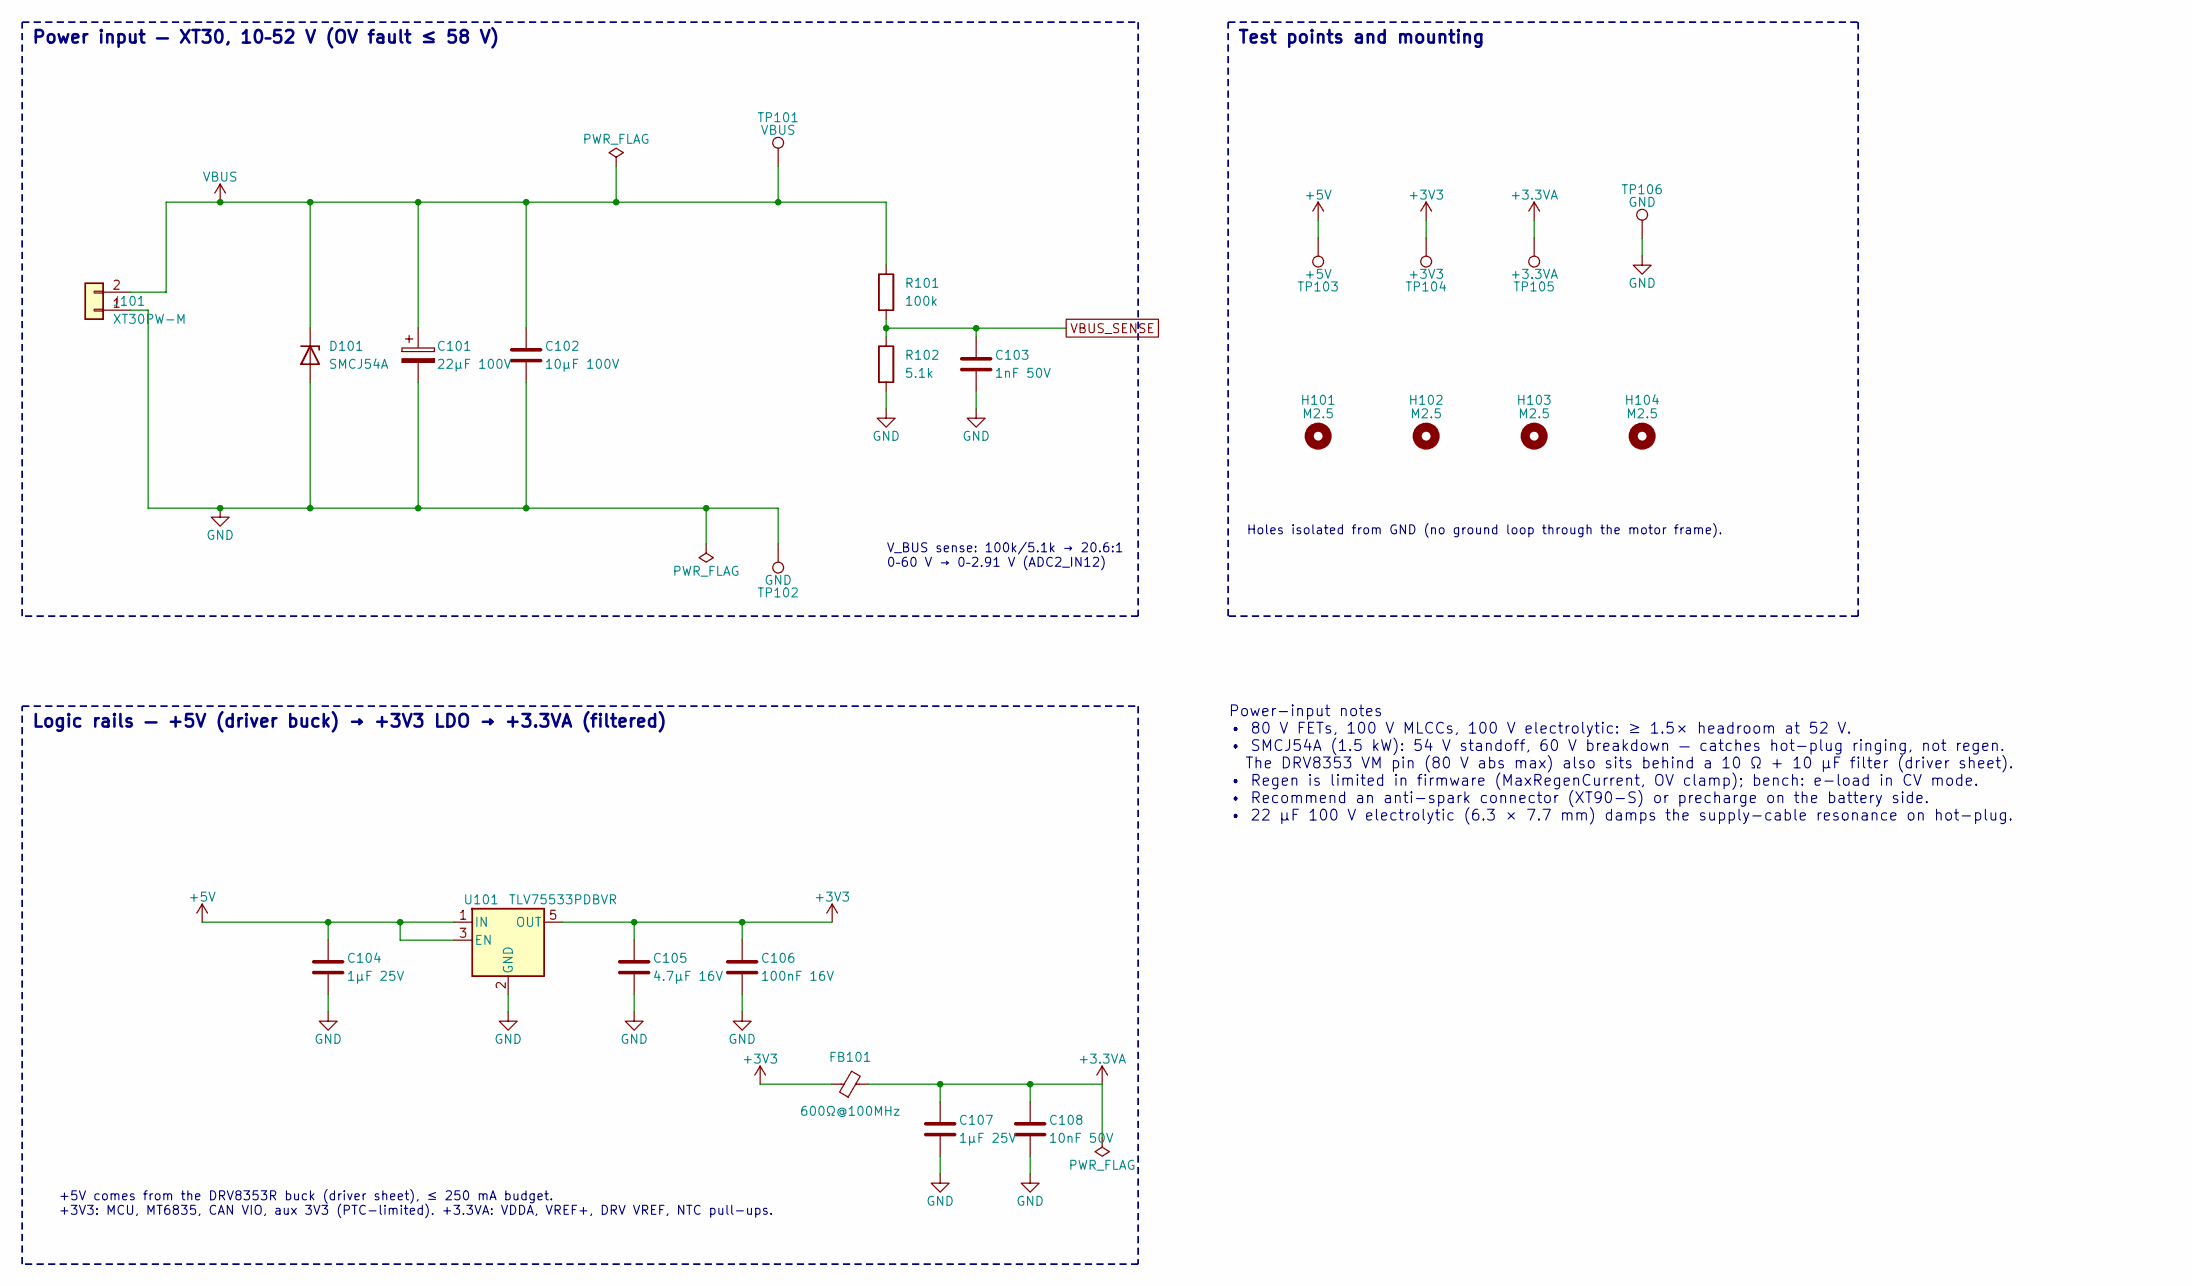
[picture p5: schematic power.kicad_sch, Tercio B1 — brushless FOC driver — Power input and rails]

Parts:
C101: 22µF 100V; CP_Elec_6.3x7.7; MPN JVJ100V22M6x8; LCSC C46550391
C102: 10µF 100V; C_1210_3225Metric; LCSC C5156756
C103: 1nF 50V; C_0402_1005Metric; LCSC C1523
C104, C107: 1µF 25V; C_0402_1005Metric; LCSC C52923
C105: 4.7µF 16V; C_0603_1608Metric; LCSC C19666
C106: 100nF 16V; C_0402_1005Metric; LCSC C1525
C108: 10nF 50V; C_0402_1005Metric; LCSC C15195
D101: SMCJ54A; D_SMC; MPN SMCJ54A; LCSC C438116
FB101: 600Ω@100MHz; L_0603_1608Metric; MPN GZ1608D601TF; LCSC C1002
H101, H102, H103, H104: M2.5; MountingHole_2.7mm_M2.5
J101: XT30PW-M; AMASS_XT30PW-M_1x02_P2.50mm_Horizontal; MPN XT30PW-M30.G.Y; LCSC C431092
R101: 100k; R_0603_1608Metric; LCSC C25803
R102: 5.1k; R_0402_1005Metric; LCSC C25905
TP101: VBUS; TestPad_D0.9mm
TP102, TP106: GND; TestPad_D0.9mm
TP103: +5V; TestPad_D0.9mm
TP104: +3V3; TestPad_D0.9mm
TP105: +3.3VA; TestPad_D0.9mm
U101: TLV75533PDBVR; SOT-23-5; MPN TLV75533PDBVR; LCSC C404027

Connections:
+3.3VA: C107.1, C108.1, FB101.2, TP105.1; also elsewhere on the board
+3V3: C105.1, C106.1, FB101.1, TP104.1, U101.5 (OUT); also elsewhere on the board
+5V: C104.1, TP103.1, U101.1 (IN), U101.3 (EN); also elsewhere on the board
GND: C101.2, C102.2, C103.2, C104.2, C105.2, C106.2, C107.2, C108.2, D101.2 (A), J101.1, R102.2, TP102.1, TP106.1, U101.2 (GND); also elsewhere on the board
VBUS: C101.1, C102.1, D101.1 (K), J101.2, R101.1, TP101.1; also elsewhere on the board
VBUS_SENSE: C103.1, R101.2, R102.1; also elsewhere on the board

Notes on the sheet:
Power input — XT30, 10–52 V (OV fault ≤ 58 V)
Logic rails — +5V (driver buck) → +3V3 LDO → +3.3VA (filtered)
Test points and mounting
V_BUS sense: 100k/5.1k → 20.6:1 0–60 V → 0–2.91 V (ADC2_IN12)
+5V comes from the DRV8353R buck (driver sheet), ≤ 250 mA budget. +3V3: MCU, MT6835, CAN VIO, aux 3V3 (PTC-limited). +3.3VA: VDDA, VREF+, DRV VREF, NTC pull-ups.
Holes isolated from GND (no ground loop through the motor frame).
Power-input notes • 80 V FETs, 100 V MLCCs, 100 V electrolytic: ≥ 1.5× headroom at 52 V. • SMCJ54A (1.5 kW): 54 V standoff, 60 V breakdown — catches hot-plug ringing, not regen. The DRV8353 VM pin (80 V abs max) also sits behind a 10 Ω + 10 µF filter (driver sheet). • Regen is limited in firmware (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

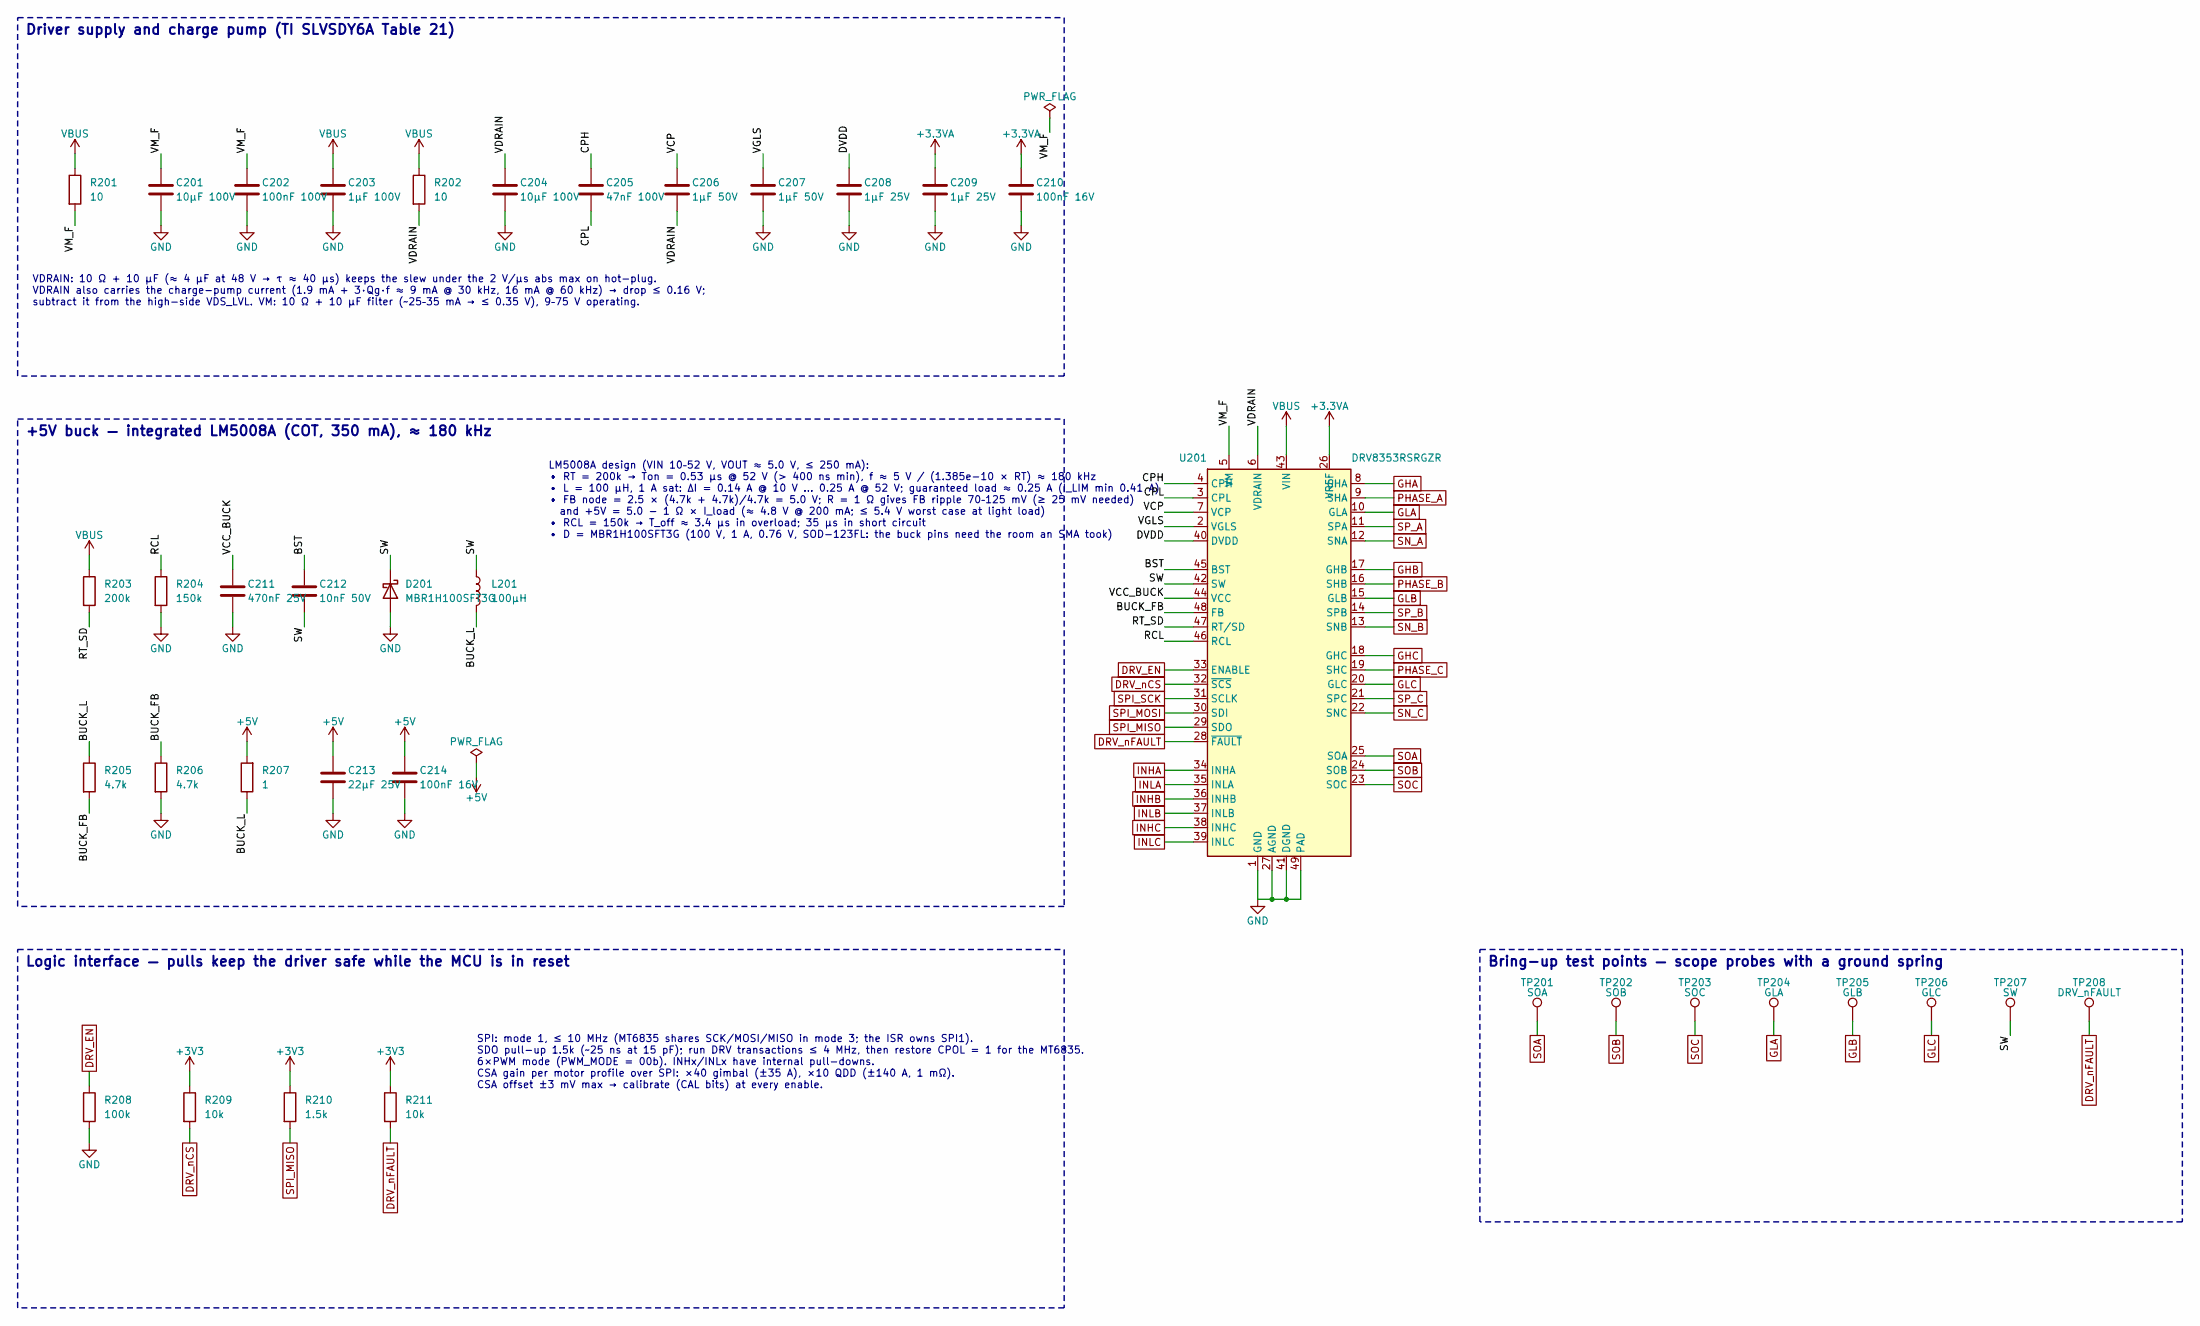
[picture p6: schematic driver.kicad_sch, Tercio B1 — brushless FOC driver — Gate driver and buck]

Parts:
C201, C204: 10µF 100V; C_1210_3225Metric; LCSC C5156756
C202: 100nF 100V; C_0603_1608Metric; LCSC C15725
C203: 1µF 100V; C_0805_2012Metric; LCSC C5370002
C205: 47nF 100V; C_0603_1608Metric; LCSC C576852
C206, C207: 1µF 50V; C_0603_1608Metric; LCSC C15849
C208, C209: 1µF 25V; C_0402_1005Metric; LCSC C52923
C210, C214: 100nF 16V; C_0402_1005Metric; LCSC C1525
C211: 470nF 25V; C_0603_1608Metric; LCSC C1623
C212: 10nF 50V; C_0402_1005Metric; LCSC C15195
C213: 22µF 25V; C_0805_2012Metric; LCSC C45783
D201: MBR1H100SFT3G; D_SOD-123F; MPN MBR1H100SFT3G; LCSC C235757
L201: 100µH; L_Sunlord_SWPA6045S; MPN SWPA6045S101MT; LCSC C60633
R201, R202: 10; R_0603_1608Metric; LCSC C22859
R203: 200k; R_0603_1608Metric; LCSC C25811
R204: 150k; R_0603_1608Metric; LCSC C22807
R205, R206: 4.7k; R_0402_1005Metric; LCSC C25900
R207: 1; R_0805_2012Metric; LCSC C25271
R208: 100k; R_0402_1005Metric; LCSC C25741
R209, R211: 10k; R_0402_1005Metric; LCSC C25744
R210: 1.5k; R_0402_1005Metric; LCSC C25867
TP201: SOA; TestPad_D0.9mm
TP202: SOB; TestPad_D0.9mm
TP203: SOC; TestPad_D0.9mm
TP204: GLA; TestPad_D0.9mm
TP205: GLB; TestPad_D0.9mm
TP206: GLC; TestPad_D0.9mm
TP207: SW; TestPad_D0.9mm
TP208: DRV_nFAULT; TestPad_D0.9mm
U201: DRV8353RSRGZR; Texas_RGZ0048A_VQFN-48-1EP_7x7mm_P0.5mm_EP5.15x5.15mm_Therm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; MPN DRV8353RSRGZR; LCSC C506246

Connections:
+3.3VA: C209.1, C210.1, U201.26 (VREF); also elsewhere on the board
+3V3: R209.1, R210.1, R211.1; also elsewhere on the board
+5V: C213.1, C214.1, R207.2; also elsewhere on the board
/Gate driver and buck/BST: C212.1, U201.45 (BST)
/Gate driver and buck/BUCK_FB: R205.2, R206.1, U201.48 (FB)
/Gate driver and buck/BUCK_L: L201.2, R205.1, R207.1
/Gate driver and buck/CPH: C205.1, U201.4 (CPH)
/Gate driver and buck/CPL: C205.2, U201.3 (CPL)
/Gate driver and buck/DVDD: C208.1, U201.40 (DVDD)
/Gate driver and buck/RCL: R204.1, U201.46 (RCL)
/Gate driver and buck/RT_SD: R203.2, U201.47 (RT/SD)
/Gate driver and buck/SW: C212.2, D201.1 (K), L201.1, TP207.1, U201.42 (SW)
/Gate driver and buck/VCC_BUCK: C211.1, U201.44 (VCC)
/Gate driver and buck/VCP: C206.1, U201.7 (VCP)
/Gate driver and buck/VDRAIN: C204.1, C206.2, R202.2, U201.6 (VDRAIN)
/Gate driver and buck/VGLS: C207.1, U201.2 (VGLS)
/Gate driver and buck/VM_F: C201.1, C202.1, R201.2, U201.5 (VM)
DRV_EN: R208.1, U201.33 (ENABLE); also elsewhere on the board
DRV_nCS: R209.2, U201.32 (~SCS); also elsewhere on the board
DRV_nFAULT: R211.2, TP208.1, U201.28 (~FAULT); also elsewhere on the board
GHA: U201.8 (GHA); also elsewhere on the board
GHB: U201.17 (GHB); also elsewhere on the board
GHC: U201.18 (GHC); also elsewhere on the board
GLA: TP204.1, U201.10 (GLA); also elsewhere on the board
GLB: TP205.1, U201.15 (GLB); also elsewhere on the board
GLC: TP206.1, U201.20 (GLC); also elsewhere on the board
GND: C201.2, C202.2, C203.2, C204.2, C207.2, C208.2, C209.2, C210.2, C211.2, C213.2, C214.2, D201.2 (A), R204.2, R206.2, R208.2, U201.1 (GND), U201.27 (AGND), U201.41 (DGND), U201.49 (PAD); also elsewhere on the board
INHA: U201.34 (INHA); also elsewhere on the board
INHB: U201.36 (INHB); also elsewhere on the board
INHC: U201.38 (INHC); also elsewhere on the board
INLA: U201.35 (INLA); also elsewhere on the board
INLB: U201.37 (INLB); also elsewhere on the board
INLC: U201.39 (INLC); also elsewhere on the board
PHASE_A: U201.9 (SHA); also elsewhere on the board
PHASE_B: U201.16 (SHB); also elsewhere on the board
PHASE_C: U201.19 (SHC); also elsewhere on the board
SN_A: U201.12 (SNA); also elsewhere on the board
SN_B: U201.13 (SNB); also elsewhere on the board
SN_C: U201.22 (SNC); also elsewhere on the board
SOA: TP201.1, U201.25 (SOA); also elsewhere on the board
SOB: TP202.1, U201.24 (SOB); also elsewhere on the board
SOC: TP203.1, U201.23 (SOC); also elsewhere on the board
SPI_MISO: R210.2, U201.29 (SDO); also elsewhere on the board
SPI_MOSI: U201.30 (SDI); also elsewhere on the board
SPI_SCK: U201.31 (SCLK); also elsewhere on the board
SP_A: U201.11 (SPA); also elsewhere on the board
SP_B: U201.14 (SPB); also elsewhere on the board
SP_C: U201.21 (SPC); also elsewhere on the board
VBUS: C203.1, R201.1, R202.1, R203.1, U201.43 (VIN); also elsewhere on the board

Notes on the sheet:
Driver supply and charge pump (TI SLVSDY6A Table 21)
+5V buck — integrated LM5008A (COT, 350 mA), ≈ 180 kHz
Logic interface — pulls keep the driver safe while the MCU is in reset
Bring-up test points — scope probes with a ground spring
VDRAIN: 10 Ω + 10 µF (≈ 4 µF at 48 V → τ ≈ 40 µs) keeps the slew under the 2 V/µs abs max on hot-plug. VDRAIN also carries the charge-pump current (1.9 mA + 3·Qg·f ≈ 9 mA @ 30 kHz, 16 mA @ 60 kHz) → drop ≤ 0.16 V; subtract it from the high-side VDS_LVL. VM: 10 Ω + 10 µF filter (~25–35 mA → ≤ 0.35 V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
LM5008A design (VIN 10–52 V, VOUT ≈ 5.0 V, ≤ 250 mA): • RT = 200k → Ton = 0.53 µs @ 52 V (> 400 ns min), f ≈ 5 V / (1.385e-10 × RT) ≈ 180 kHz • L = 100 µH, 1 A sat: ΔI = 0.14 A @ 10 V … 0.25 A @ 52 V; guaranteed load ≈ 0.25 A (I_LIM min 0.41 A) • FB node = 2.5 × (4.7k + 4.7k)/4.7k = 5.0 V; R = 1 Ω 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
SPI: mode 1, ≤ 10 MHz (MT6835 shares SCK/MOSI/MISO in mode 3; the ISR owns SPI1). SDO pull-up 1.5k (~25 ns at 15 pF); run DRV transactions ≤ 4 MHz, then restore CPOL = 1 for the MT6835. 6×PWM mode (PWM_MODE = 00b). INHx/INLx have internal pull-downs. CSA gain per motor profile over SPI: ×40 gimbal 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

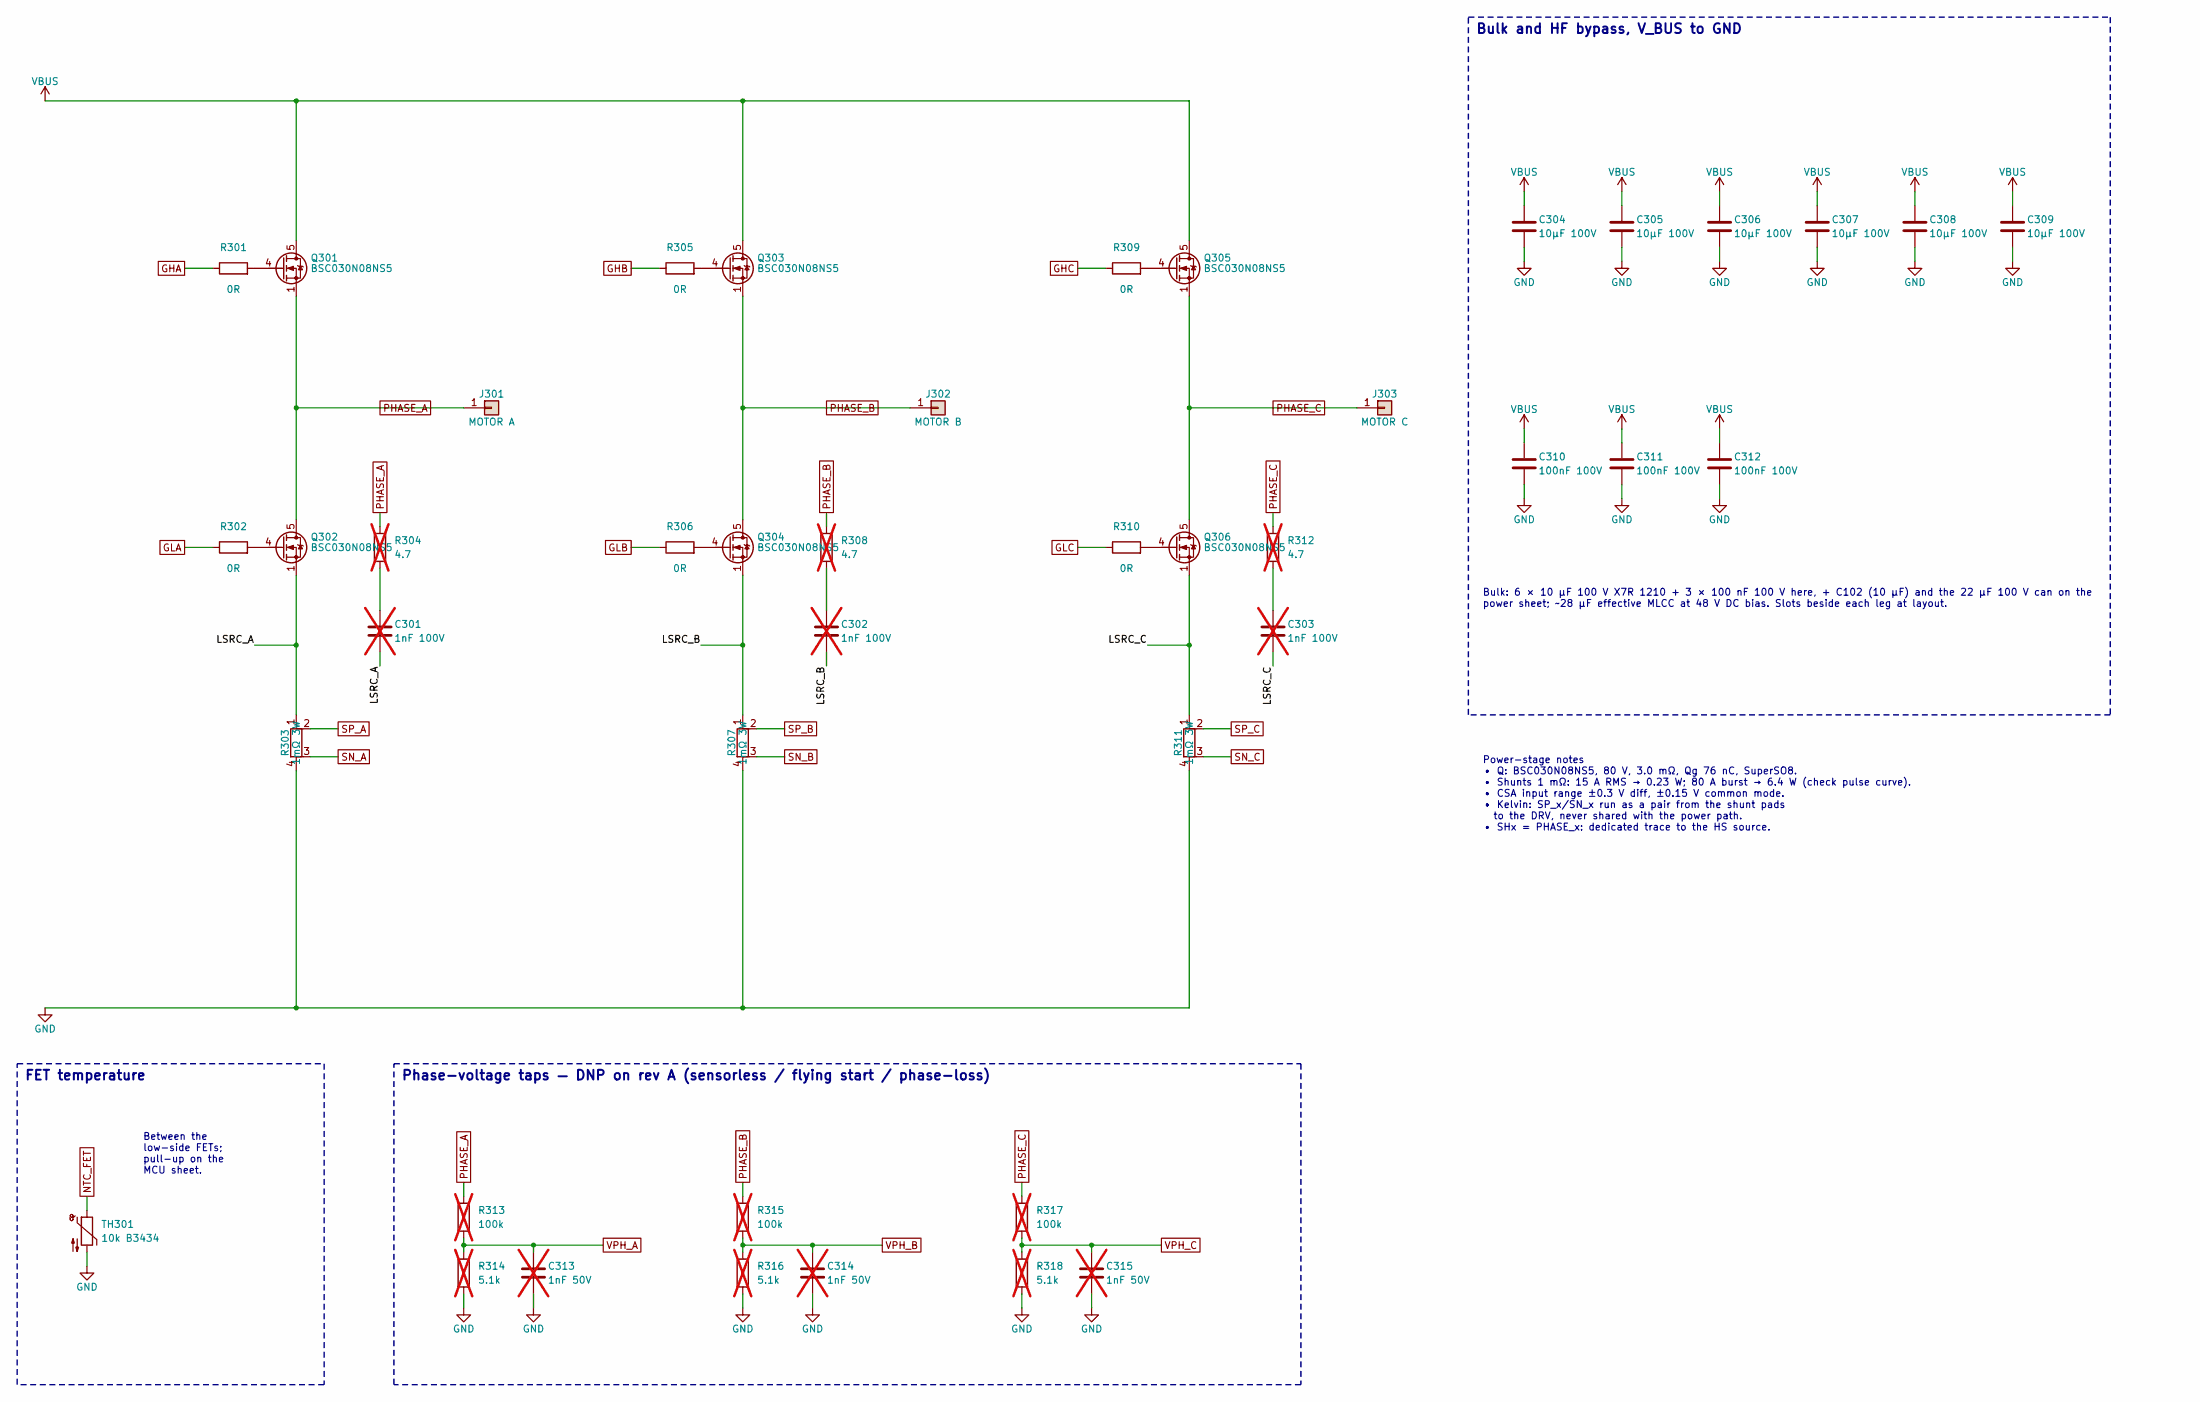
[picture p7: schematic bridge.kicad_sch, Tercio B1 — brushless FOC driver — Power stage]

Parts:
C301, C302, C303: 1nF 100V; C_0603_1608Metric; not fitted
C304, C305, C306, C307, C308, C309: 10µF 100V; C_1210_3225Metric; LCSC C5156756
C310, C311, C312: 100nF 100V; C_0805_2012Metric; LCSC C28233
C313, C314, C315: 1nF 50V; C_0402_1005Metric; not fitted
J301: MOTOR A; MotorPad_3.6x6mm
J302: MOTOR B; MotorPad_3.6x6mm
J303: MOTOR C; MotorPad_3.6x6mm
Q301, Q302, Q303, Q304, Q305, Q306: BSC030N08NS5; TDSON-8-1; MPN BSC030N08NS5; LCSC C501507
R301, R302, R305, R306, R309, R310: 0R; R_0402_1005Metric; LCSC C17168
R303, R307, R311: 1mΩ 3W; R_2512_Kelvin; MPN RLP25FEGR001; LCSC C459678
R304, R308, R312: 4.7; R_0805_2012Metric; not fitted
R313, R315, R317: 100k; R_0603_1608Metric; not fitted
R314, R316, R318: 5.1k; R_0402_1005Metric; not fitted
TH301: 10k B3434; R_0603_1608Metric; MPN NCP18XH103F03RB; LCSC C13564

Connections:
/Power stage/LSRC_A: C301.2, Q302.1 (S), Q302.2 (S), Q302.3 (S), R303.1
/Power stage/LSRC_B: C302.2, Q304.1 (S), Q304.2 (S), Q304.3 (S), R307.1
/Power stage/LSRC_C: C303.2, Q306.1 (S), Q306.2 (S), Q306.3 (S), R311.1
GHA: R301.1; also elsewhere on the board
GHB: R305.1; also elsewhere on the board
GHC: R309.1; also elsewhere on the board
GLA: R302.1; also elsewhere on the board
GLB: R306.1; also elsewhere on the board
GLC: R310.1; also elsewhere on the board
GND: C304.2, C305.2, C306.2, C307.2, C308.2, C309.2, C310.2, C311.2, C312.2, C313.2, C314.2, C315.2, R303.4, R307.4, R311.4, R314.2, R316.2, R318.2, TH301.2; also elsewhere on the board
NTC_FET: TH301.1; also elsewhere on the board
unnamed: C301.1, R304.2
unnamed: C302.1, R308.2
unnamed: C303.1, R312.2
unnamed: Q301.4 (G), R301.2
unnamed: Q302.4 (G), R302.2
unnamed: Q303.4 (G), R305.2
unnamed: Q304.4 (G), R306.2
unnamed: Q305.4 (G), R309.2
unnamed: Q306.4 (G), R310.2
PHASE_A: J301.1, Q301.1 (S), Q301.2 (S), Q301.3 (S), Q302.5 (D), R304.1, R313.1; also elsewhere on the board
PHASE_B: J302.1, Q303.1 (S), Q303.2 (S), Q303.3 (S), Q304.5 (D), R308.1, R315.1; also elsewhere on the board
PHASE_C: J303.1, Q305.1 (S), Q305.2 (S), Q305.3 (S), Q306.5 (D), R312.1, R317.1; also elsewhere on the board
SN_A: R303.3; also elsewhere on the board
SN_B: R307.3; also elsewhere on the board
SN_C: R311.3; also elsewhere on the board
SP_A: R303.2; also elsewhere on the board
SP_B: R307.2; also elsewhere on the board
SP_C: R311.2; also elsewhere on the board
VBUS: C304.1, C305.1, C306.1, C307.1, C308.1, C309.1, C310.1, C311.1, C312.1, Q301.5 (D), Q303.5 (D), Q305.5 (D); also elsewhere on the board
VPH_A: C313.1, R313.2, R314.1; also elsewhere on the board
VPH_B: C314.1, R315.2, R316.1; also elsewhere on the board
VPH_C: C315.1, R317.2, R318.1; also elsewhere on the board

Notes on the sheet:
Bulk and HF bypass, V_BUS to GND
FET temperature
Phase-voltage taps — DNP on rev A (sensorless / flying start / phase-loss)
Bulk: 6 × 10 µF 100 V X7R 1210 + 3 × 100 nF 100 V here, + C102 (10 µF) and the 22 µF 100 V can on the power sheet; ~28 µF effective MLCC at 48 V DC bias. Slots beside each leg at layout.
Between the low-side FETs; pull-up on the MCU sheet.
Power-stage notes • Q: BSC030N08NS5, 80 V, 3.0 mΩ, Qg 76 nC, SuperSO8. • Shunts 1 mΩ: 15 A RMS → 0.23 W; 80 A burst → 6.4 W (check pulse curve). • CSA input range ±0.3 V diff, ±0.15 V common mode. • Kelvin: SP_x/SN_x run as a pair from the shunt pads to the DRV, never shared with the power path. • 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

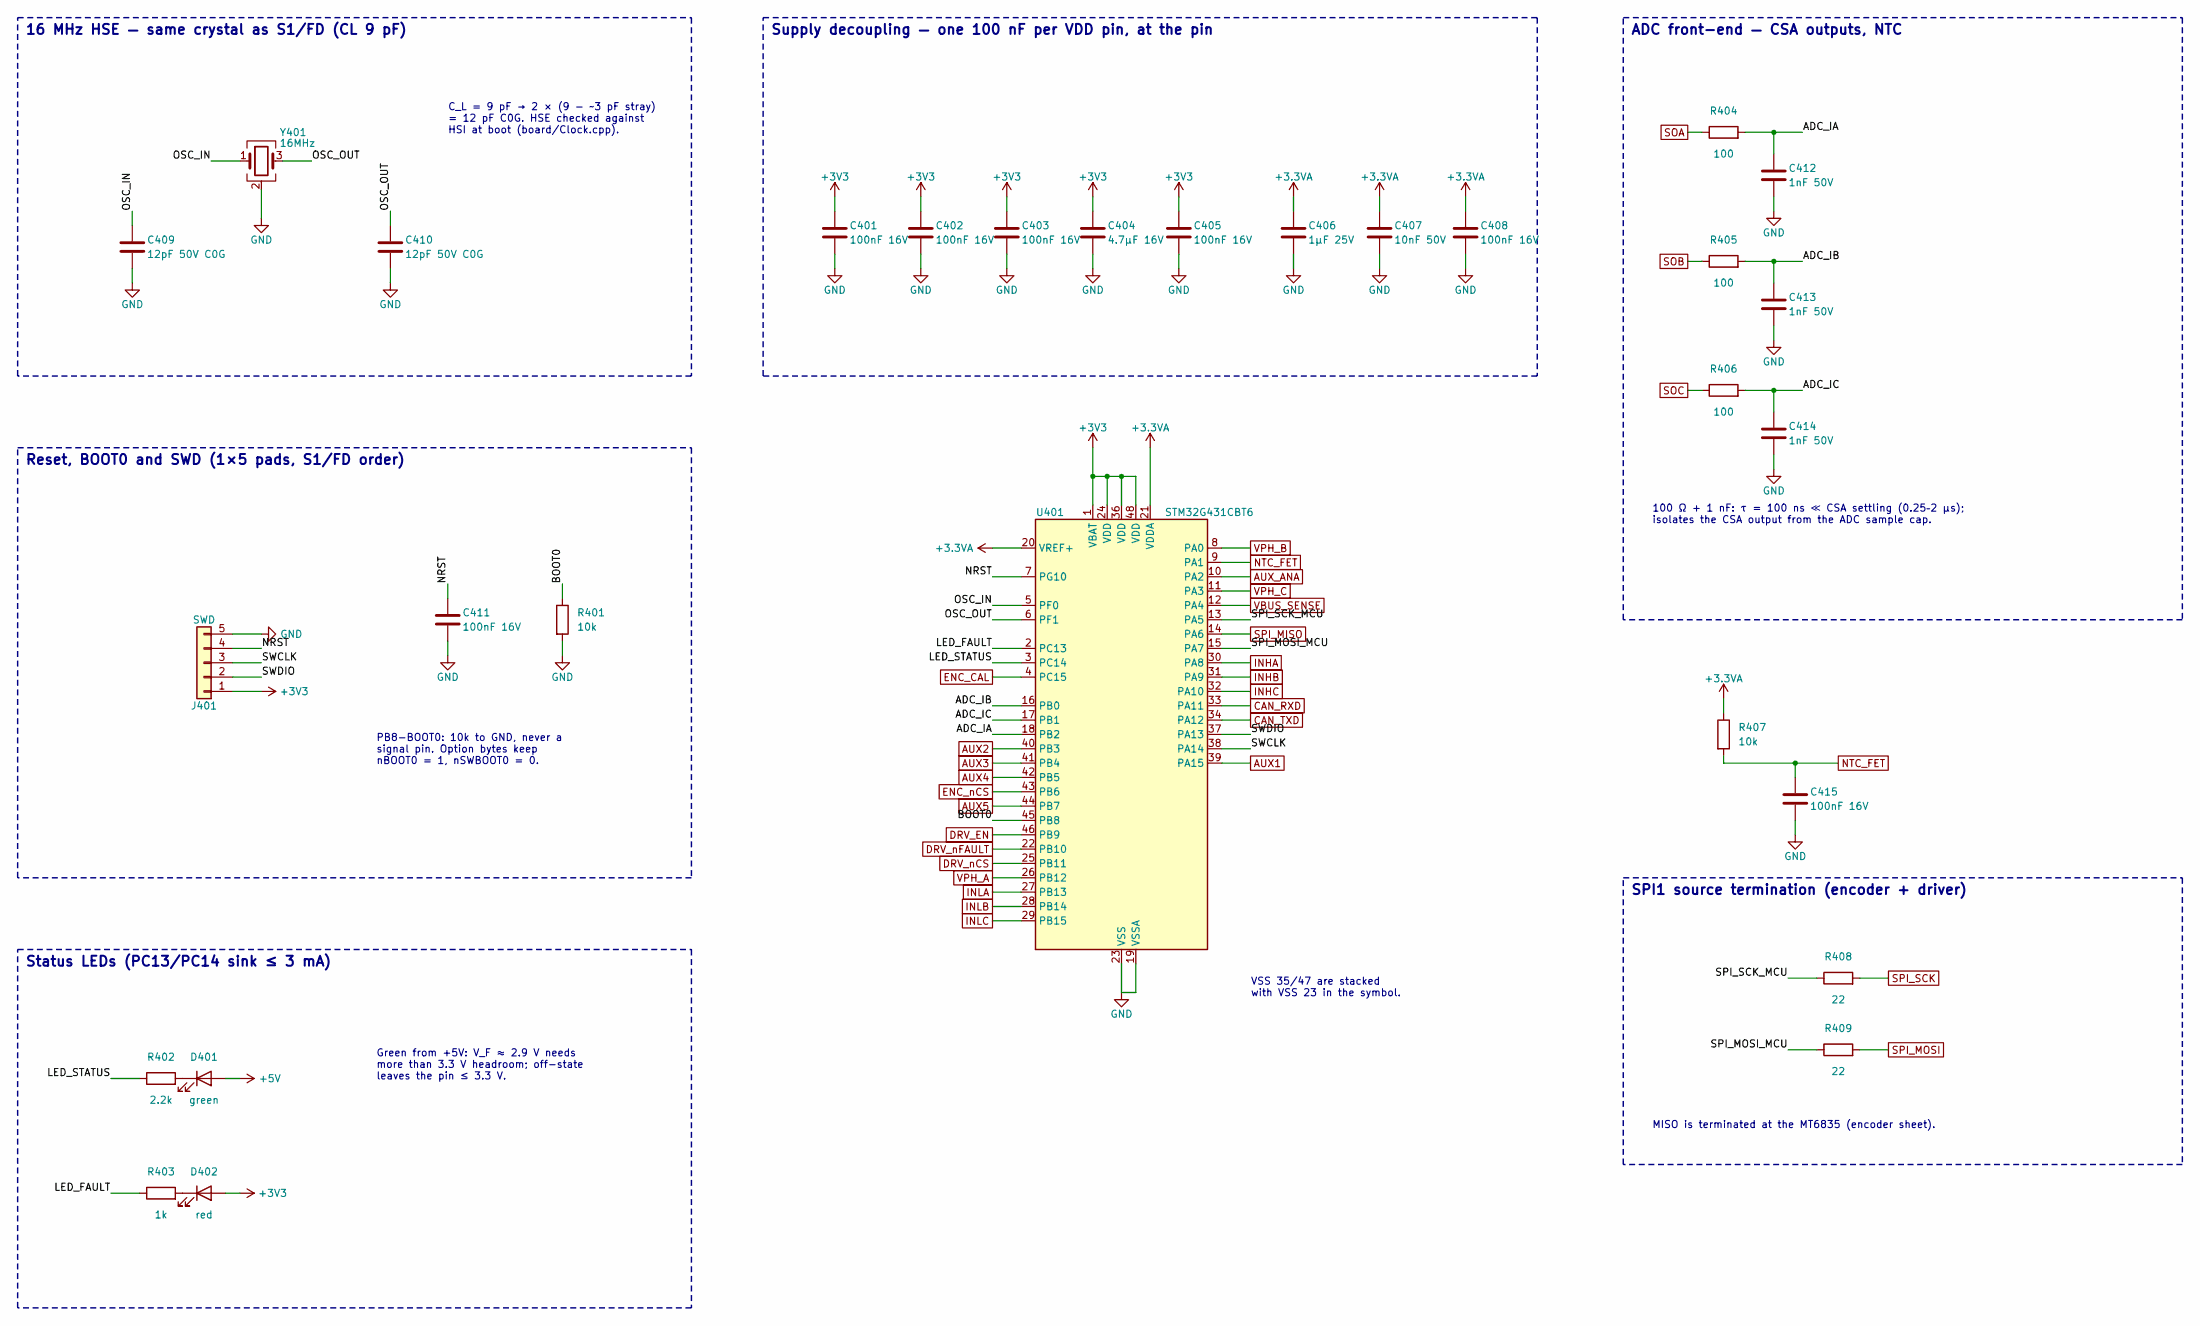
[picture p8: schematic mcu.kicad_sch, Tercio B1 — brushless FOC driver — MCU]

Parts:
C401, C402, C403, C405, C408, C411, C415: 100nF 16V; C_0402_1005Metric; LCSC C1525
C404: 4.7µF 16V; C_0603_1608Metric; LCSC C19666
C406: 1µF 25V; C_0402_1005Metric; LCSC C52923
C407: 10nF 50V; C_0402_1005Metric; LCSC C15195
C409, C410: 12pF 50V C0G; C_0402_1005Metric; LCSC C1547
C412, C413, C414: 1nF 50V; C_0402_1005Metric; LCSC C1523
D401: green; LED_0805_2012Metric; MPN KT-0805G; LCSC C2297
D402: red; LED_0603_1608Metric; MPN KT-0603R; LCSC C2286
J401: SWD; SWD_Pads_1x05_P2.54mm
R401, R407: 10k; R_0402_1005Metric; LCSC C25744
R402: 2.2k; R_0402_1005Metric; LCSC C25879
R403: 1k; R_0402_1005Metric; LCSC C11702
R404, R405, R406: 100; R_0402_1005Metric; LCSC C25076
R408, R409: 22; R_0402_1005Metric; LCSC C25092
U401: STM32G431CBT6; LQFP-48_7x7mm_P0.5mm; MPN STM32G431CBT6; LCSC C529355
Y401: 16MHz; Crystal_SMD_3225-4Pin_3.2x2.5mm; MPN X322516MLB4SI; LCSC C13738

Connections:
+3.3VA: C406.1, C407.1, C408.1, R407.1, U401.20 (VREF+), U401.21 (VDDA); also elsewhere on the board
+3V3: C401.1, C402.1, C403.1, C404.1, C405.1, D402.2 (A), J401.1, U401.1 (VBAT), U401.24 (VDD), U401.36 (VDD), U401.48 (VDD); also elsewhere on the board
+5V: D401.2 (A); also elsewhere on the board
/MCU/ADC_IA: C412.1, R404.2, U401.18 (PB2)
/MCU/ADC_IB: C413.1, R405.2, U401.16 (PB0)
/MCU/ADC_IC: C414.1, R406.2, U401.17 (PB1)
/MCU/BOOT0: R401.1, U401.45 (PB8)
/MCU/LED_FAULT: R403.1, U401.2 (PC13)
/MCU/LED_STATUS: R402.1, U401.3 (PC14)
/MCU/NRST: C411.1, J401.4, U401.7 (PG10)
/MCU/OSC_IN: C409.1, U401.5 (PF0), Y401.1
/MCU/OSC_OUT: C410.1, U401.6 (PF1), Y401.3
/MCU/SPI_MOSI_MCU: R409.1, U401.15 (PA7)
/MCU/SPI_SCK_MCU: R408.1, U401.13 (PA5)
/MCU/SWCLK: J401.3, U401.38 (PA14)
/MCU/SWDIO: J401.2, U401.37 (PA13)
AUX1: U401.39 (PA15); also elsewhere on the board
AUX2: U401.40 (PB3); also elsewhere on the board
AUX3: U401.41 (PB4); also elsewhere on the board
AUX4: U401.42 (PB5); also elsewhere on the board
AUX5: U401.44 (PB7); also elsewhere on the board
AUX_ANA: U401.10 (PA2); also elsewhere on the board
CAN_RXD: U401.33 (PA11); also elsewhere on the board
CAN_TXD: U401.34 (PA12); also elsewhere on the board
DRV_EN: U401.46 (PB9); also elsewhere on the board
DRV_nCS: U401.25 (PB11); also elsewhere on the board
DRV_nFAULT: U401.22 (PB10); also elsewhere on the board
ENC_CAL: U401.4 (PC15); also elsewhere on the board
ENC_nCS: U401.43 (PB6); also elsewhere on the board
GND: C401.2, C402.2, C403.2, C404.2, C405.2, C406.2, C407.2, C408.2, C409.2, C410.2, C411.2, C412.2, C413.2, C414.2, C415.2, J401.5, R401.2, U401.19 (VSSA), U401.23 (VSS), U401.35 (VSS), U401.47 (VSS), Y401.2 (G), Y401.4 (G); also elsewhere on the board
INHA: U401.30 (PA8); also elsewhere on the board
INHB: U401.31 (PA9); also elsewhere on the board
INHC: U401.32 (PA10); also elsewhere on the board
INLA: U401.27 (PB13); also elsewhere on the board
INLB: U401.28 (PB14); also elsewhere on the board
INLC: U401.29 (PB15); also elsewhere on the board
NTC_FET: C415.1, R407.2, U401.9 (PA1); also elsewhere on the board
unnamed: D401.1 (K), R402.2
unnamed: D402.1 (K), R403.2
SOA: R404.1; also elsewhere on the board
SOB: R405.1; also elsewhere on the board
SOC: R406.1; also elsewhere on the board
SPI_MISO: U401.14 (PA6); also elsewhere on the board
SPI_MOSI: R409.2; also elsewhere on the board
SPI_SCK: R408.2; also elsewhere on the board
VBUS_SENSE: U401.12 (PA4); also elsewhere on the board
VPH_A: U401.26 (PB12); also elsewhere on the board
VPH_B: U401.8 (PA0); also elsewhere on the board
VPH_C: U401.11 (PA3); also elsewhere on the board

Notes on the sheet:
Supply decoupling — one 100 nF per VDD pin, at the pin
16 MHz HSE — same crystal as S1/FD (CL 9 pF)
Reset, BOOT0 and SWD (1×5 pads, S1/FD order)
Status LEDs (PC13/PC14 sink ≤ 3 mA)
ADC front-end — CSA outputs, NTC
SPI1 source termination (encoder + driver)
VSS 35/47 are stacked with VSS 23 in the symbol.
C_L = 9 pF → 2 × (9 − ~3 pF stray) = 12 pF C0G. HSE checked against HSI at boot (board/Clock.cpp).
PB8-BOOT0: 10k to GND, never a signal pin. Option bytes keep nBOOT0 = 1, nSWBOOT0 = 0.
Green from +5V: V_F ≈ 2.9 V needs more than 3.3 V headroom; off-state leaves the pin ≤ 3.3 V.
100 Ω + 1 nF: τ = 100 ns ≪ CSA settling (0.25–2 µs); isolates the CSA output from the ADC sample cap.
MISO is terminated at the MT6835 (encoder sheet).
