Kerol-Dev/Tercio-B1/hardware/kicad/tercio-b1.kicad_pcb

## KiCad design hardware/kicad/tercio-b1.kicad_pcb (continued)

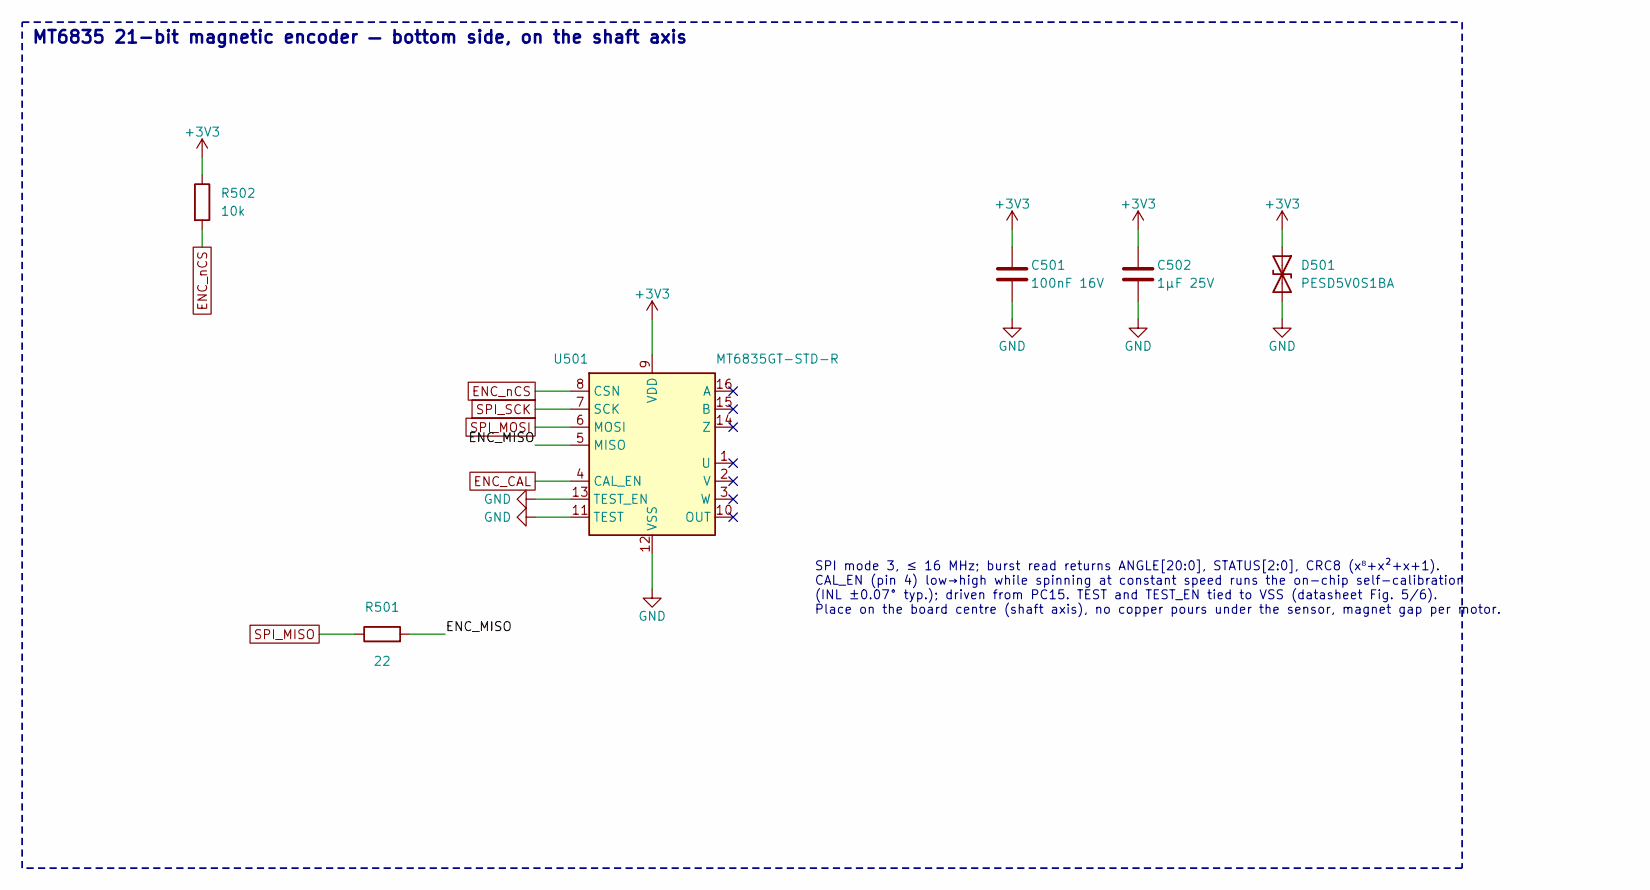
[picture p9: schematic encoder.kicad_sch, Tercio B1 — brushless FOC driver — Encoder]

Parts:
C501: 100nF 16V; C_0402_1005Metric; LCSC C1525
C502: 1µF 25V; C_0402_1005Metric; LCSC C52923
D501: PESD5V0S1BA; D_SOD-323; MPN PESD5V0S1BA; LCSC C2827694
R501: 22; R_0402_1005Metric; LCSC C25092
R502: 10k; R_0402_1005Metric; LCSC C25744
U501: MT6835GT-STD-R; TSSOP-16_4.4x5mm_P0.65mm; MPN MT6835GT-STD-R; LCSC C2932578

Connections:
+3V3: C501.1, C502.1, D501.1 (A1), R502.1, U501.9 (VDD); also elsewhere on the board
/Encoder/ENC_MISO: R501.2, U501.5 (MISO)
ENC_CAL: U501.4 (CAL_EN); also elsewhere on the board
ENC_nCS: R502.2, U501.8 (CSN); also elsewhere on the board
GND: C501.2, C502.2, D501.2 (A2), U501.11 (TEST), U501.12 (VSS), U501.13 (TEST_EN); also elsewhere on the board
SPI_MISO: R501.1; also elsewhere on the board
SPI_MOSI: U501.6 (MOSI); also elsewhere on the board
SPI_SCK: U501.7 (SCK); also elsewhere on the board

Notes on the sheet:
MT6835 21-bit magnetic encoder — bottom side, on the shaft axis
SPI mode 3, ≤ 16 MHz; burst read returns ANGLE[20:0], STATUS[2:0], CRC8 (x⁸+x²+x+1). CAL_EN (pin 4) low→high while spinning at constant speed runs the on-chip self-calibration (INL ±0.07° typ.); driven from PC15. TEST and TEST_EN tied to VSS (datasheet Fig. 5/6). Place on the board centre (shaft ax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

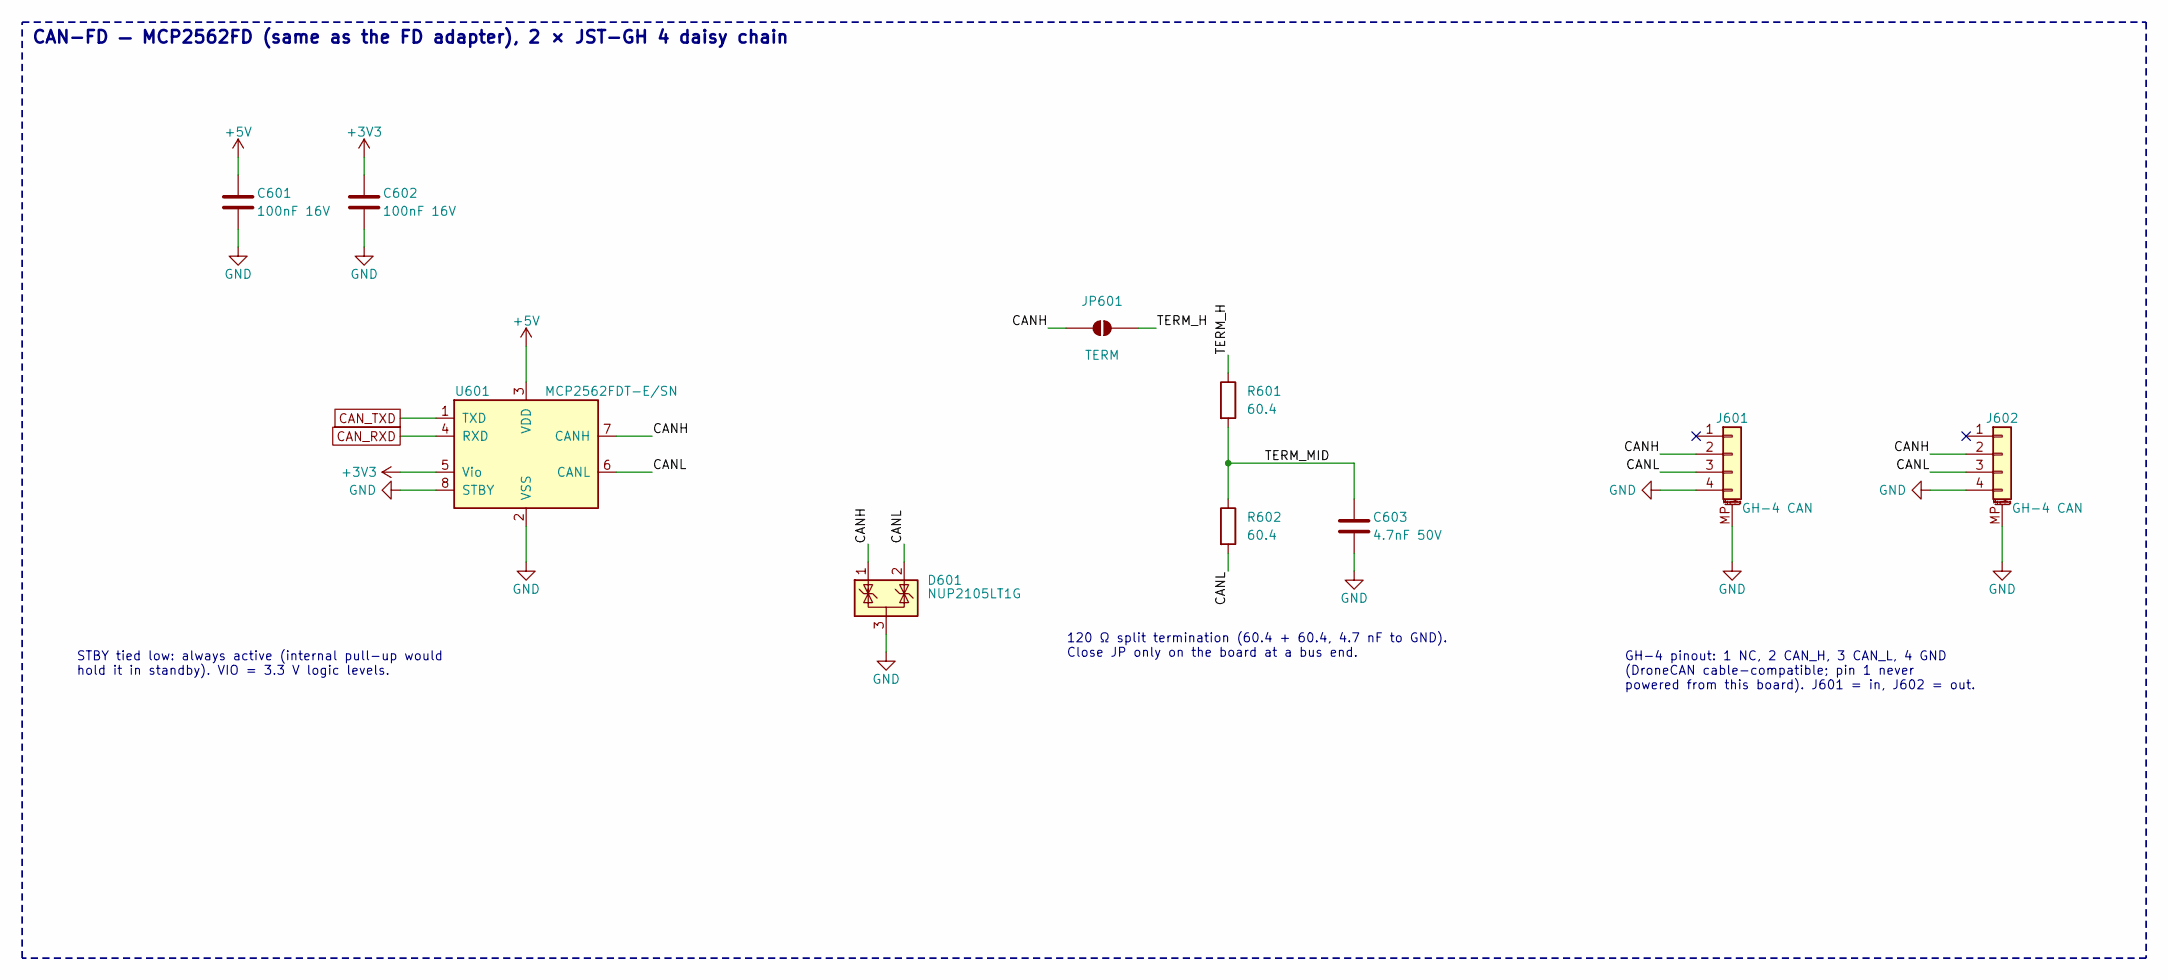
[picture p10: schematic can.kicad_sch, Tercio B1 — brushless FOC driver — CAN-FD]

Parts:
C601, C602: 100nF 16V; C_0402_1005Metric; LCSC C1525
C603: 4.7nF 50V; C_0402_1005Metric; LCSC C1538
D601: NUP2105LT1G; SOT-23; MPN NUP2105LT1G; LCSC C14486
J601, J602: GH-4 CAN; JST_GH_SM04B-GHS-TB_1x04-1MP_P1.25mm_Horizontal; MPN SM04B-GHS-TB(LF)(SN); LCSC C189895
JP601: TERM; SolderJumper-2_P1.3mm_Open_RoundedPad1.0x1.5mm
R601, R602: 60.4; R_0402_1005Metric; LCSC C137954
U601: MCP2562FDT-E/SN; SOIC-8_3.9x4.9mm_P1.27mm; MPN MCP2562FDT-E/SN; LCSC C511335

Connections:
+3V3: C602.1, U601.5 (Vio); also elsewhere on the board
+5V: C601.1, U601.3 (VDD); also elsewhere on the board
/CAN-FD/CANH: D601.1 (K), J601.2, J602.2, JP601.1 (A), U601.7 (CANH)
/CAN-FD/CANL: D601.2 (K), J601.3, J602.3, R602.2, U601.6 (CANL)
/CAN-FD/TERM_H: JP601.2 (B), R601.1
/CAN-FD/TERM_MID: C603.1, R601.2, R602.1
CAN_RXD: U601.4 (RXD); also elsewhere on the board
CAN_TXD: U601.1 (TXD); also elsewhere on the board
GND: C601.2, C602.2, C603.2, D601.3 (A), J601.4, J601.MP (MountPin), J602.4, J602.MP (MountPin), U601.2 (VSS), U601.8 (STBY); also elsewhere on the board

Notes on the sheet:
CAN-FD — MCP2562FD (same as the FD adapter), 2 × JST-GH 4 daisy chain
STBY tied low: always active (internal pull-up would hold it in standby). VIO = 3.3 V logic levels.
120 Ω split termination (60.4 + 60.4, 4.7 nF to GND). Close JP only on the board at a bus end.
GH-4 pinout: 1 NC, 2 CAN_H, 3 CAN_L, 4 GND (DroneCAN cable-compatible; pin 1 never powered from this board). J601 = in, J602 = out.

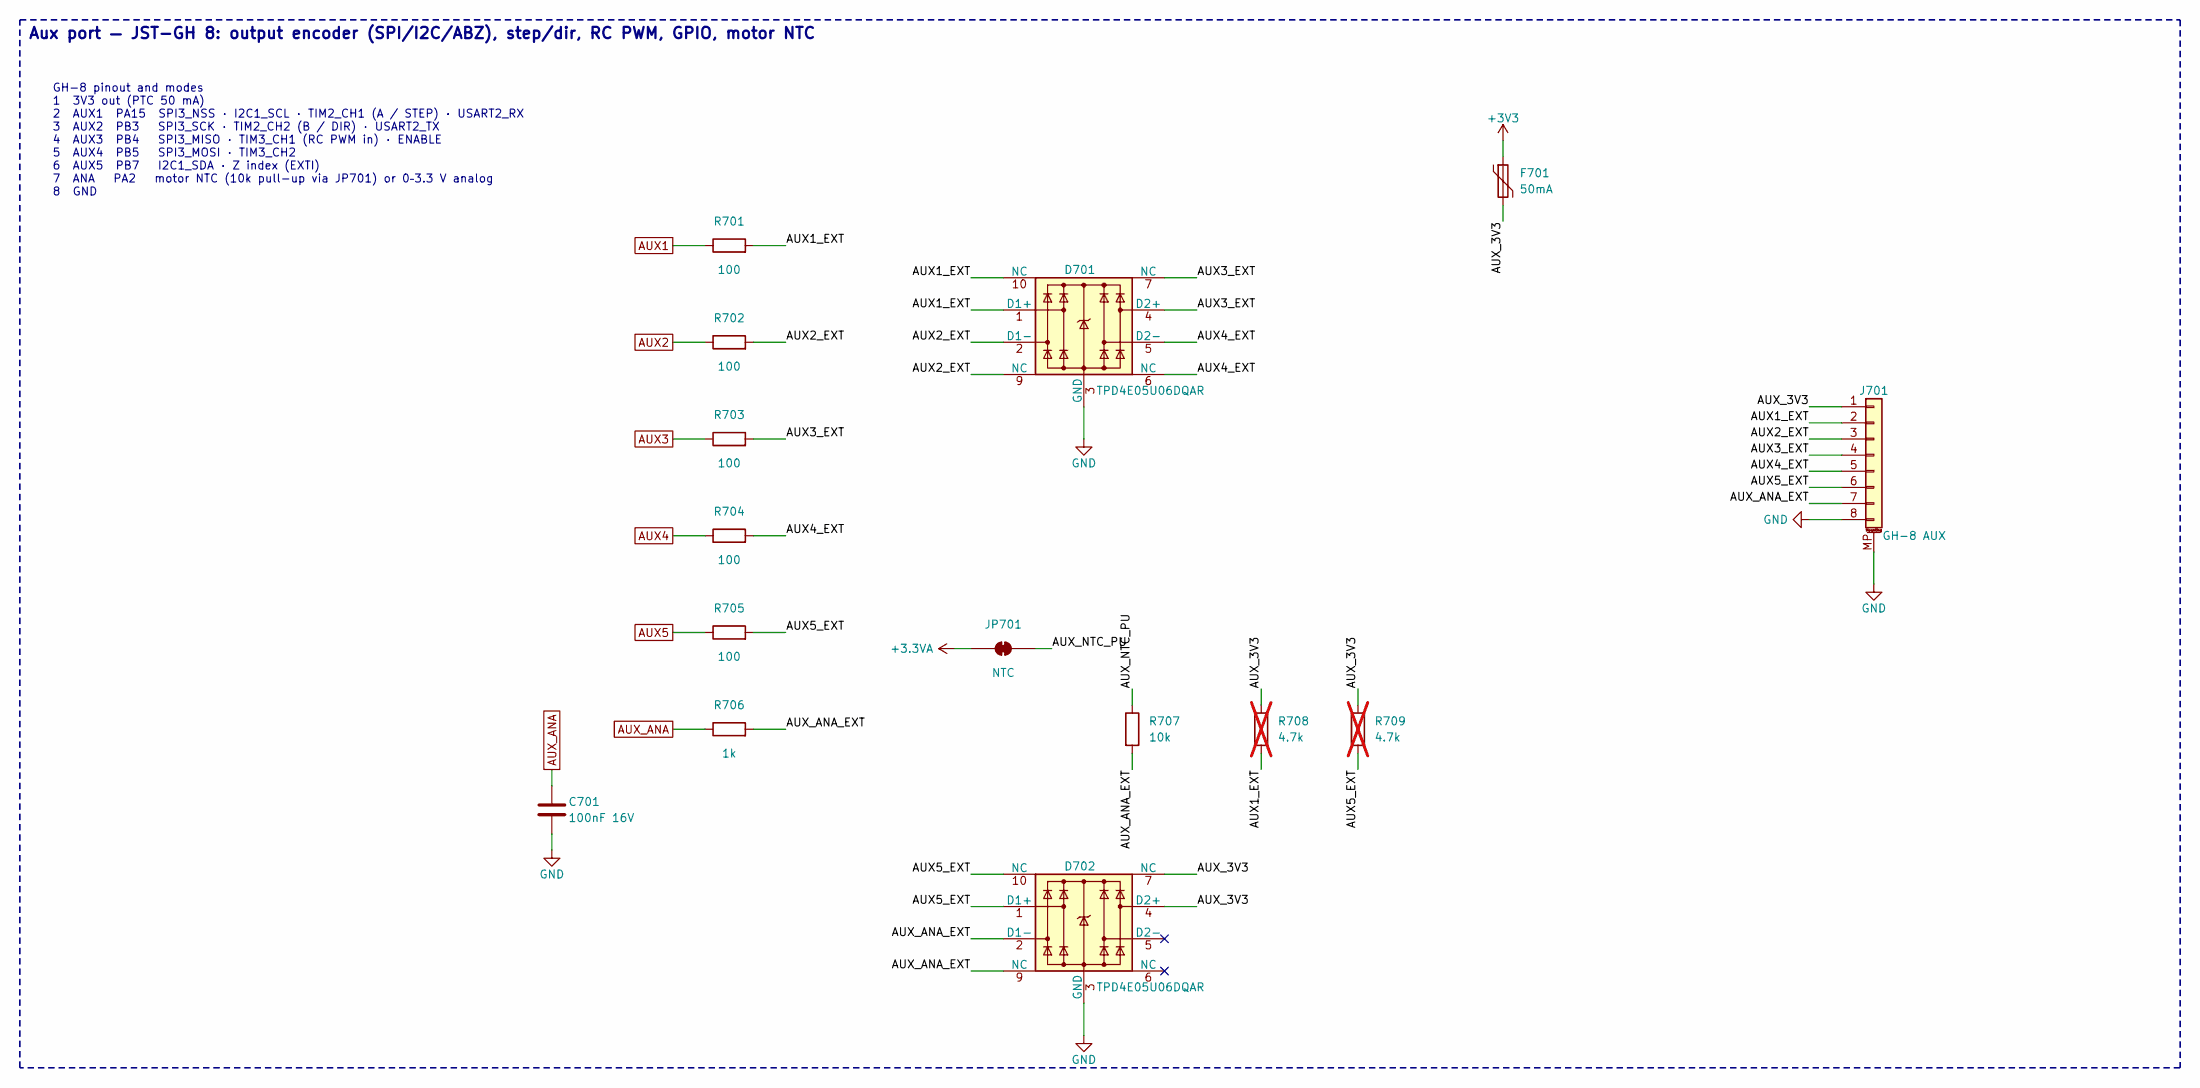
[picture p11: schematic aux.kicad_sch, Tercio B1 — brushless FOC driver — Aux port]

Parts:
C701: 100nF 16V; C_0402_1005Metric; LCSC C1525
D701, D702: TPD4E05U06DQAR; USON-10_2.5x1.0mm_P0.5mm; MPN TPD4E05U06DQAR; LCSC C138714
F701: 50mA; Fuse_0603_1608Metric; MPN 0603L005/24AR; LCSC C7472511
J701: GH-8 AUX; JST_GH_SM08B-GHS-TB_1x08-1MP_P1.25mm_Horizontal; MPN SH-SM08B-GHS-TB(LF)(SN); LCSC C42376901
JP701: NTC; SolderJumper-2_P1.3mm_Bridged_RoundedPad1.0x1.5mm
R701, R702, R703, R704, R705: 100; R_0402_1005Metric; LCSC C25076
R706: 1k; R_0402_1005Metric; LCSC C11702
R707: 10k; R_0402_1005Metric; LCSC C25744
R708, R709: 4.7k; R_0402_1005Metric; not fitted

Connections:
+3.3VA: JP701.1 (A); also elsewhere on the board
+3V3: F701.1; also elsewhere on the board
/Aux port/AUX1_EXT: D701.1 (D1+), D701.10 (NC), J701.2, R701.2, R708.2
/Aux port/AUX2_EXT: D701.2 (D1-), D701.9 (NC), J701.3, R702.2
/Aux port/AUX3_EXT: D701.4 (D2+), D701.7 (NC), J701.4, R703.2
/Aux port/AUX4_EXT: D701.5 (D2-), D701.6 (NC), J701.5, R704.2
/Aux port/AUX5_EXT: D702.1 (D1+), D702.10 (NC), J701.6, R705.2, R709.2
/Aux port/AUX_3V3: D702.4 (D2+), D702.7 (NC), F701.2, J701.1, R708.1, R709.1
/Aux port/AUX_ANA_EXT: D702.2 (D1-), D702.9 (NC), J701.7, R706.2, R707.2
/Aux port/AUX_NTC_PU: JP701.2 (B), R707.1
AUX1: R701.1; also elsewhere on the board
AUX2: R702.1; also elsewhere on the board
AUX3: R703.1; also elsewhere on the board
AUX4: R704.1; also elsewhere on the board
AUX5: R705.1; also elsewhere on the board
AUX_ANA: C701.1, R706.1; also elsewhere on the board
GND: C701.2, D701.3 (GND), D701.8 (GND), D702.3 (GND), D702.8 (GND), J701.8, J701.MP (MountPin); also elsewhere on the board

Notes on the sheet:
Aux port — JST-GH 8: output encoder (SPI/I2C/ABZ), step/dir, RC PWM, GPIO, motor NTC
GH-8 pinout and modes 1 3V3 out (PTC 50 mA) 2 AUX1 PA15 SPI3_NSS · I2C1_SCL · TIM2_CH1 (A / STEP) · USART2_RX 3 AUX2 PB3 SPI3_SCK · TIM2_CH2 (B / DIR) · USART2_TX 4 AUX3 PB4 SPI3_MISO · TIM3_CH1 (RC PWM in) · ENABLE 5 AUX4 PB5 SPI3_MOSI · TIM3_CH2 6 AUX5 PB7 I2C1_SDA · Z index (EXTI) 7 ANA PA2 moto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

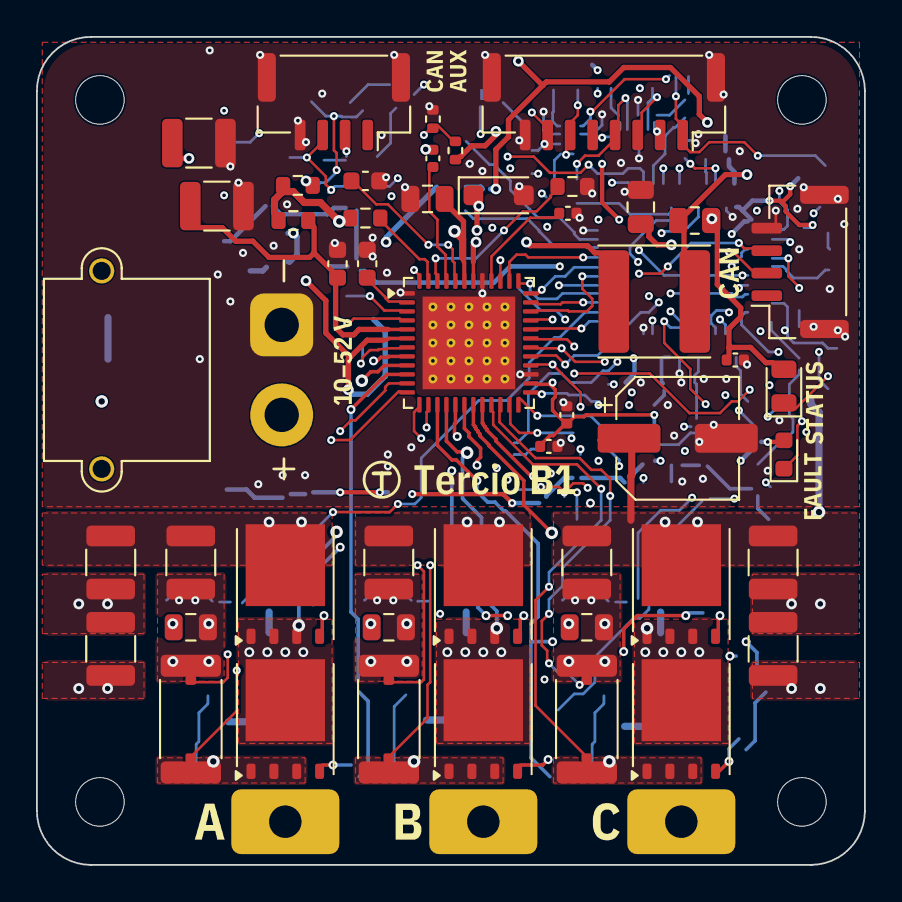
[picture p12: board tercio-b1.kicad_pcb from above]

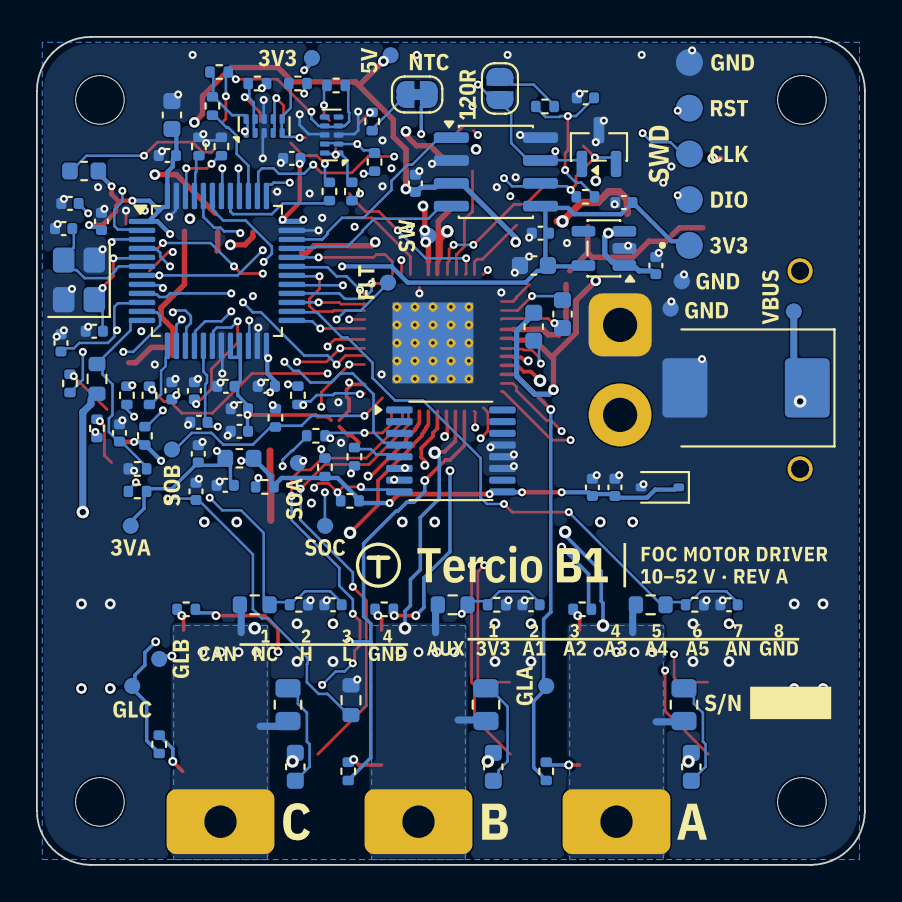
[picture p13: board tercio-b1.kicad_pcb from below]

Board: 6 copper layers, 46.0 x 46.0 mm, 163 parts (108 on the bottom side), 104 nets.
