Kerol-Dev/Tercio-B1/(commit log)

2026-10-12 Plan the Tercio B1 brushless FOC driver
    Requirements and the wedge against moteus-x1/n1, a spec comparison, a part
    shortlist with live LCSC/JLCPCB stock (2026-10-12), the block diagram and
    STM32G431 pin map, BOM cost at 10/100 boards and the PCB plan, the
    KiCad-as-code flow, the firmware plan, bring-up tests, and risks with a
    three-spin schedule. Tools re-run the part lookup, the BOM estimate and the
    CAN-FD bus budget.
    [bom-estimate.csv, parts-live-2026-10-12-candidates-extra.csv, parts-live-2026-10-12.csv, pinmap-g431cbt6.csv]
2026-10-18 Tercio B1 rev A: generated board, firmware F0 and simulator; new README
    The repository is renamed from Tercio-bldc to Tercio-B1.
    - hardware/: the rev A schematic and 6-layer board as code (Python that
    writes KiCad 10 files), 100 % routed by our own router, ERC 0, DRC 0,
    schematic parity 0; silkscreen in IBM Plex; JLCPCB gerbers, BOM and
    CPL from tools/jlc_fab.py; the generated KiCad project in kicad/.
    - firmware/: milestone F0, the hardware-independent FOC core,
    calibration and joint, with host tests 1-6 on simulated motors and a
    real-time simulator with a web UI.
    - docs: pin map and architecture updated to the routed board (CSA on
    PB2/PB0/PB1, VBUS on PA4, DRV_CS PB11, ENC_CS P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
    [aux.kicad_sch, bridge.kicad_sch, can.kicad_sch, driver.kicad_sch, encoder.kicad_sch, mcu.kicad_sch, pinmap-g431cbt6.csv, power.kicad_sch]
