Kerol-Dev/Tercio-B1/(notices)

Notices in the files:
README.md:
License: Apache-2.0
